Camperlux/vancontroller/docs/3d_top.png

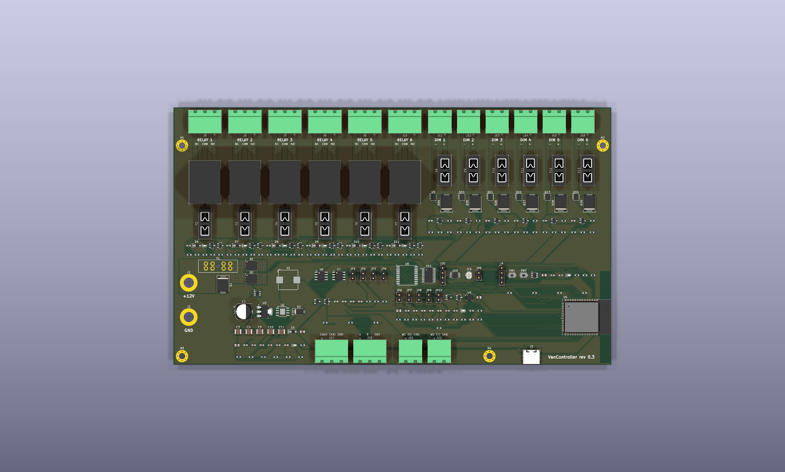
docs/3d_top.png
