Camperlux/vancontroller/docs/board_rev0.3_routed.png

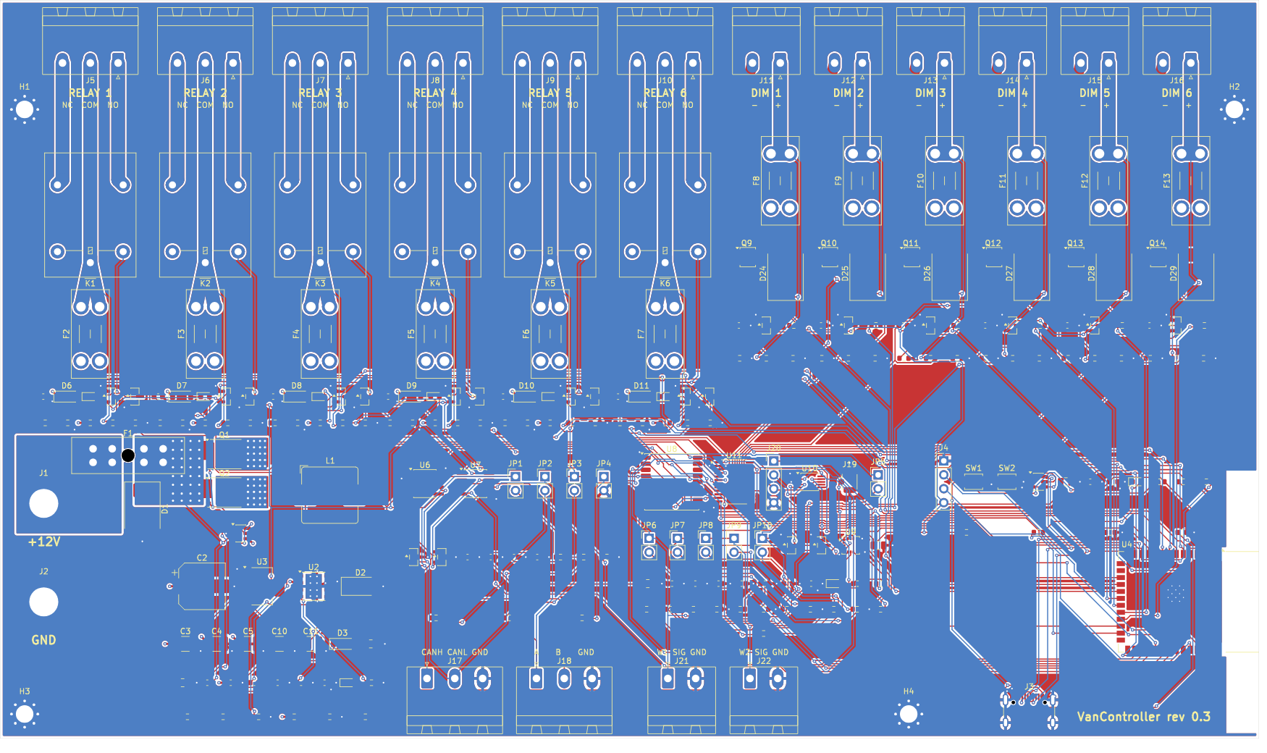
docs/board_rev0.3_routed.png
