Camperlux/vancontroller/docs/placement_rev0.3.png

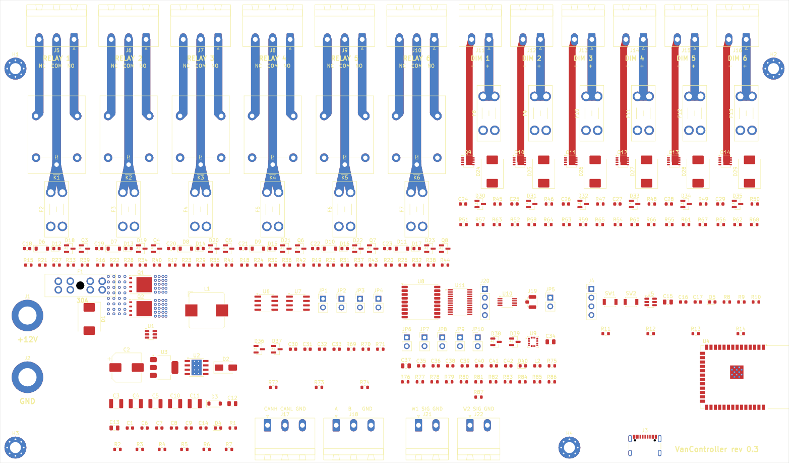
docs/placement_rev0.3.png
