Camperlux/vancontroller/enclosure/enclosure_base_preview.png

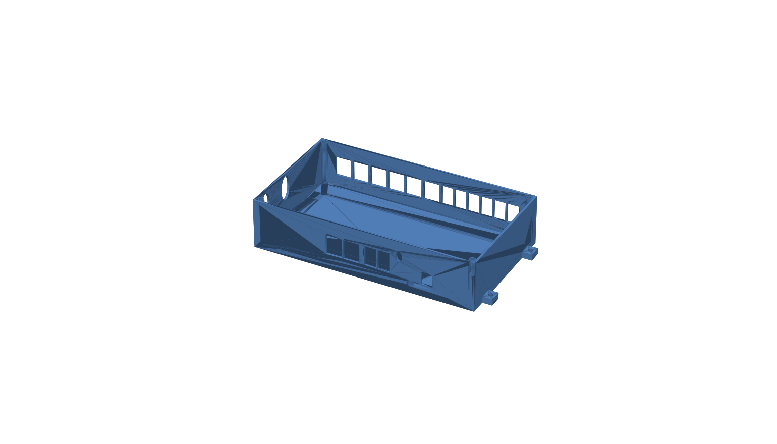
enclosure/enclosure_base_preview.png
