Camperlux/vancontroller/enclosure/enclosure_exploded_preview.png

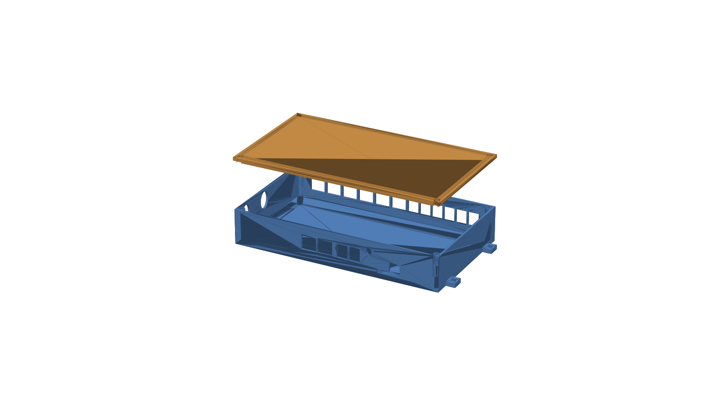
enclosure/enclosure_exploded_preview.png
