Camperlux/vancontroller/fab/bom.csv

Designators | Value | Footprint | MPN | Qty
C1,C7,C14,C16,C30,C31,C33,C35,C38-C42 | 100nF | Capacitor_SMD:C_0603_1608Metric |  | 13
C2 | 100uF 35V | Capacitor_SMD:CP_Elec_8x10 |  | 1
C3 | 4.7uF 50V | Capacitor_SMD:C_1210_3225Metric |  | 1
C4,C5 | 4.7uF 100V | Capacitor_SMD:C_1210_3225Metric |  | 2
C6 | 100nF 100V | Capacitor_SMD:C_0603_1608Metric |  | 1
C8,C32 | 4.7nF | Capacitor_SMD:C_0603_1608Metric |  | 2
C9 | 47pF | Capacitor_SMD:C_0603_1608Metric |  | 1
C10,C11 | 47uF 10V | Capacitor_SMD:C_1210_3225Metric |  | 2
C12,C13,C15 | 22uF | Capacitor_SMD:C_0805_2012Metric |  | 3
C17 | 1uF | Capacitor_SMD:C_0603_1608Metric |  | 1
C18-C29,C36 | 10nF | Capacitor_SMD:C_0603_1608Metric |  | 13
C34,C37 | 10uF | Capacitor_SMD:C_0805_2012Metric |  | 2
D1 | SMDJ26CA | Diode_SMD:D_SMC |  | 1
D2 | B360A | Diode_SMD:D_SMA |  | 1
D3 | B5819W | Diode_SMD:D_SOD-123 |  | 1
D4 | Green | LED_SMD:LED_0603_1608Metric |  | 1
D5 | Blue | LED_SMD:LED_0603_1608Metric |  | 1
D6-D11 | 1N4148W | Diode_SMD:D_SOD-123 |  | 6
D12-D17 | Red | LED_SMD:LED_0603_1608Metric |  | 6
D18-D23,D30-D35,D38,D39 | BAT54S | Package_TO_SOT_SMD:SOT-23 |  | 14
D24-D29 | SS54 | Diode_SMD:D_SMC |  | 6
D36 | NUP2105L | Package_TO_SOT_SMD:SOT-23 |  | 1
D37 | SM712 | Package_TO_SOT_SMD:SOT-23 |  | 1
D40 | Yellow | LED_SMD:LED_0603_1608Metric |  | 1
F1 | 30A ATO | Fuse:FuseHolder_Blade_ATO_Littelfuse_FLR_178.6165 | Littelfuse FLR 178.6165 + 30 A ATO fuse | 1
F2-F7 | 10A mini | Fuse:Fuseholder_Blade_Mini_Keystone_3568 | Keystone 3568 + mini blade fuse (size to load) | 6
F8-F13 | 5A mini | Fuse:Fuseholder_Blade_Mini_Keystone_3568 | Keystone 3568 + mini blade fuse (size to load) | 6
J1 | +12V IN (M5 stud) | MountingHole:MountingHole_5.3mm_M5_DIN965_Pad |  | 1
J2 | GND IN (M5 stud) | MountingHole:MountingHole_5.3mm_M5_DIN965_Pad |  | 1
J3 | USB-C | Connector_USB:USB_C_Receptacle_GCT_USB4105-xx-A_16P_TopMnt_Horizontal |  | 1
J4 | UART0 debug | Connector_PinHeader_2.54mm:PinHeader_1x04_P2.54mm_Vertical |  | 1
J5-J10 | NO / COM / NC | Connector_Phoenix_MSTB:PhoenixContact_MSTBA_2,5_3-G-5,08_1x03_P5.08mm_Horizontal | Phoenix MSTBA 2,5/3-G-5,08 + MSTB 2,5/3-ST-5,08 | 6
J11-J16 | LOAD+ / LOAD- | Connector_Phoenix_MSTB:PhoenixContact_MSTBA_2,5_2-G-5,08_1x02_P5.08mm_Horizontal | Phoenix MSTBA 2,5/2-G-5,08 + MSTB 2,5/2-ST-5,08 | 6
J17 | CANH / CANL / GND | Connector_Phoenix_MSTB:PhoenixContact_MSTBA_2,5_3-G-5,08_1x03_P5.08mm_Horizontal | Phoenix MSTBA 2,5/3-G-5,08 + MSTB 2,5/3-ST-5,08 | 1
J18 | A / B / GND | Connector_Phoenix_MSTB:PhoenixContact_MSTBA_2,5_3-G-5,08_1x03_P5.08mm_Horizontal | Phoenix MSTBA 2,5/3-G-5,08 + MSTB 2,5/3-ST-5,08 | 1
J19 | GPS ANT (u.FL) | Connector_Coaxial:U.FL_Hirose_U.FL-R-SMT-1_Vertical |  | 1
J20 | AUX ADC | Connector_PinHeader_2.54mm:PinHeader_1x04_P2.54mm_Vertical |  | 1
J21 | WATER 1 | Connector_Phoenix_MSTB:PhoenixContact_MSTBA_2,5_2-G-5,08_1x02_P5.08mm_Horizontal | Phoenix MSTBA 2,5/2-G-5,08 + MSTB 2,5/2-ST-5,08 | 1
J22 | WATER 2 | Connector_Phoenix_MSTB:PhoenixContact_MSTBA_2,5_2-G-5,08_1x02_P5.08mm_Horizontal | Phoenix MSTBA 2,5/2-G-5,08 + MSTB 2,5/2-ST-5,08 | 1
JP1 | CAN TERM | Connector_PinHeader_2.54mm:PinHeader_1x02_P2.54mm_Vertical |  | 1
JP2 | 485 TERM | Connector_PinHeader_2.54mm:PinHeader_1x02_P2.54mm_Vertical |  | 1
JP3 | 485 BIAS+ | Connector_PinHeader_2.54mm:PinHeader_1x02_P2.54mm_Vertical |  | 1
JP4 | 485 BIAS- | Connector_PinHeader_2.54mm:PinHeader_1x02_P2.54mm_Vertical |  | 1
JP5 | W1 RESISTIVE | Connector_PinHeader_2.54mm:PinHeader_1x02_P2.54mm_Vertical |  | 1
JP6 | W1 4-20mA | Connector_PinHeader_2.54mm:PinHeader_1x02_P2.54mm_Vertical |  | 1
JP7 | W1 0-5V | Connector_PinHeader_2.54mm:PinHeader_1x02_P2.54mm_Vertical |  | 1
JP8 | W2 RESISTIVE | Connector_PinHeader_2.54mm:PinHeader_1x02_P2.54mm_Vertical |  | 1
JP9 | W2 4-20mA | Connector_PinHeader_2.54mm:PinHeader_1x02_P2.54mm_Vertical |  | 1
JP10 | W2 0-5V | Connector_PinHeader_2.54mm:PinHeader_1x02_P2.54mm_Vertical |  | 1
K1-K6 | G5LE-1-E DC12 | Relay_THT:Relay_SPDT_Omron-G5LE-1 |  | 6
L1 | 10uH 6A | Inductor_SMD:L_Bourns_SRP1038C_10.0x10.0mm | Bourns SRP1038C-100M | 1
L2 | 27nH | Inductor_SMD:L_0603_1608Metric |  | 1
Q1,Q2 | CSD18540Q5B | Package_TO_SOT_SMD:TDSON-8-1 |  | 2
Q3-Q8 | AO3400A | Package_TO_SOT_SMD:SOT-23 |  | 6
Q9-Q14 | BUK9M12-60EX | Package_TO_SOT_SMD:LFPAK33 |  | 6
R1 | 162k | Resistor_SMD:R_0603_1608Metric |  | 1
R2 | 16.9k | Resistor_SMD:R_0603_1608Metric |  | 1
R3 | 53.6k | Resistor_SMD:R_0603_1608Metric |  | 1
R4 | 10.2k | Resistor_SMD:R_0603_1608Metric |  | 1
R5 | 120k | Resistor_SMD:R_0603_1608Metric |  | 1
R6,R8,R9,R39-R44,R63-R68,R71,R76,R77,R80,R84,R86 | 10k | Resistor_SMD:R_0603_1608Metric |  | 21
R7,R12,R87 | 1k | Resistor_SMD:R_0603_1608Metric |  | 3
R10,R11 | 4.7k | Resistor_SMD:R_0603_1608Metric |  | 2
R13,R14 | 5.1k | Resistor_SMD:R_0603_1608Metric |  | 2
R15-R20 | 100 | Resistor_SMD:R_0603_1608Metric |  | 6
R21-R26,R51-R56 | 100k | Resistor_SMD:R_0603_1608Metric |  | 12
R27-R32 | 2.2k | Resistor_SMD:R_0603_1608Metric |  | 6
R33-R38,R57-R62 | 33k | Resistor_SMD:R_0603_1608Metric |  | 12
R45-R50 | 47 | Resistor_SMD:R_0603_1608Metric |  | 6
R69,R70 | 60.4 | Resistor_SMD:R_0603_1608Metric |  | 2
R72 | 120 | Resistor_SMD:R_0603_1608Metric |  | 1
R73,R74 | 680 | Resistor_SMD:R_0603_1608Metric |  | 2
R75 | 10 | Resistor_SMD:R_0603_1608Metric |  | 1
R78,R82 | 470 | Resistor_SMD:R_0603_1608Metric |  | 2
R79,R83 | 150 | Resistor_SMD:R_0603_1608Metric |  | 2
R81,R85 | 15k | Resistor_SMD:R_0603_1608Metric |  | 2
SW1 | RESET | Button_Switch_SMD:SW_SPST_B3U-1000P |  | 1
SW2 | BOOT | Button_Switch_SMD:SW_SPST_B3U-1000P |  | 1
U1 | LM74700QDBVRQ1 | Package_TO_SOT_SMD:SOT-23-6 |  | 1
U2 | TPS54360DDA | Package_SO:TI_SO-PowerPAD-8_ThermalVias |  | 1
U3 | AMS1117-3.3 | Package_TO_SOT_SMD:SOT-223-3_TabPin2 |  | 1
U4 | ESP32-S3-WROOM-1-N16 | RF_Module:ESP32-S3-WROOM-1 |  | 1
U5 | USBLC6-2SC6 | Package_TO_SOT_SMD:SOT-23-6 |  | 1
U6 | TJA1051T/3 | Package_SO:SOIC-8_3.9x4.9mm_P1.27mm |  | 1
U7 | THVD1450D | Package_SO:SOIC-8_3.9x4.9mm_P1.27mm |  | 1
U8 | MAX-M10S | RF_GPS:ublox_MAX |  | 1
U9 | LIS3DH | Package_LGA:LGA-16_3x3mm_P0.5mm_LayoutBorder3x5y |  | 1
U10 | ADS1115IDGS | Package_SO:TSSOP-10_3x3mm_P0.5mm |  | 1
U11 | TCA9535PWR | Package_SO:TSSOP-24_4.4x7.8mm_P0.65mm |  | 1
