Camperlux/vancontroller/enclosure/VanController_enclosure_assembly.step

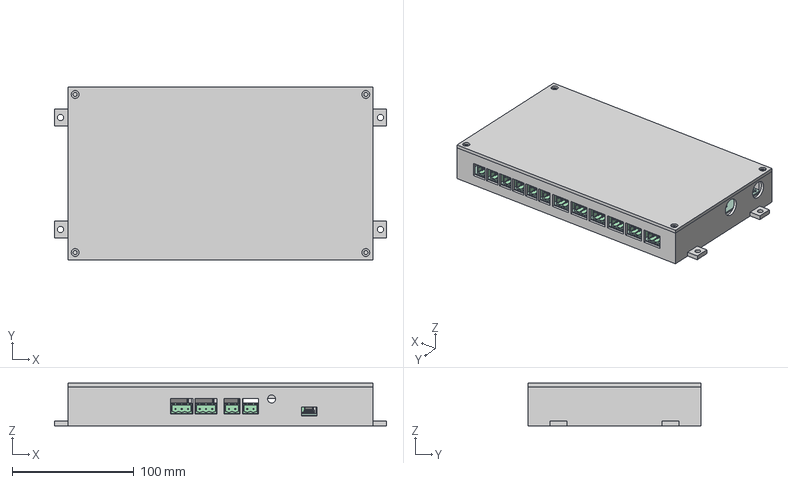
[picture p7: CAD file, 2026-10-07]
enclosure/VanController_enclosure_assembly.step
273.0 x 142.0 x 35.1 mm
R_0603_1608Metric_1 x 87
A_Keystone_3568 x 12
D_SMC_1 x 7
C_0603_1608Metric_1 x 31
MSTBA_01x03_G_5_08mm x 8
Relay_SPDT_Omron-G5LE-1_1 x 6
MSTBA_01x02_G_5_08mm x 8
LED_0603_1608Metric_1 x 9
C_0805_2012Metric_1 x 5
U.FL_Hirose_U.FL-R-SMT-1_Vertical_1
SOT-23_1 x 22
SOT-1210_LFPAK33 x 6
D_SOD-123_1 x 7
TSSOP-24_4.4x7.8mm_P0.65mm_1
SW_SPST_B3U-1000P_1 x 2
C_1210_3225Metric_1 x 5
PinHeader_1x02_P254mm_Vertical x 10
ESP32-S3-WROOM-1_1
TDSON_8_1 x 2
TSSOP-10_3x3mm_P0.5mm_1
PinHeader_1x04_P254mm_Vertical x 2
SOT-23-6_1 x 2
D_SMA_1
CP_Elec_8x10_1
SOIC-8_3.9x4.9mm_P1.27mm_1 x 2
SOT-223_1
L_0603_1608Metric_1
USB_C_Receptacle_16P_TopMnt_Horizontal_GCT_USB4105-xx-A
LGA_16_3x3mm_P05mm_LayoutBorder3x5y
VanController_PCB
