Camperlux/vancontroller/fab/VanController.step

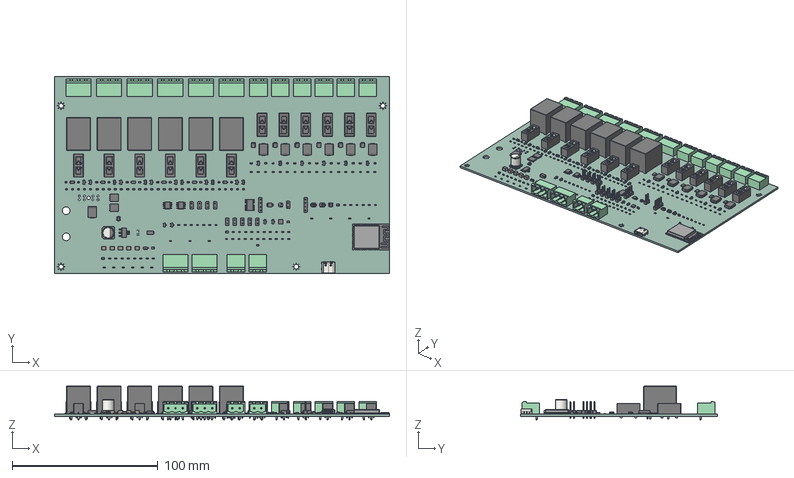
[picture p8: CAD file, 2026-10-14]
fab/VanController.step
230.0 x 135.0 x 23.1 mm
R_0603_1608Metric x 87
A_Keystone_3568 x 12
D_SMC x 7
C_0603_1608Metric x 31
MSTBA_01x03_G_5_08mm x 8
Relay_SPDT_Omron-G5LE-1 x 6
MSTBA_01x02_G_5_08mm x 8
LED_0603_1608Metric x 9
C_0805_2012Metric x 5
U.FL_Hirose_U.FL-R-SMT-1_Vertical
SOT-23 x 22
SOT-1210_LFPAK33 x 6
D_SOD-123 x 7
TSSOP-24_4.4x7.8mm_P0.65mm
SW_SPST_B3U-1000P x 2
C_1210_3225Metric x 5
PinHeader_1x02_P254mm_Vertical x 10
ESP32-S3-WROOM-1
TDSON_8_1 x 2
TSSOP-10_3x3mm_P0.5mm
PinHeader_1x04_P254mm_Vertical x 2
SOT-23-6 x 2
D_SMA
CP_Elec_8x10
SOIC-8_3.9x4.9mm_P1.27mm x 2
SOT-223
L_0603_1608Metric
USB_C_Receptacle_16P_TopMnt_Horizontal_GCT_USB4105-xx-A
LGA_16_3x3mm_P05mm_LayoutBorder3x5y
VanController_PCB
