Camperlux/vancontroller/manufacturing/VanController_rev0.3_PCBWay/08_Enclosure_3D_print_optional/VanController_base.stl

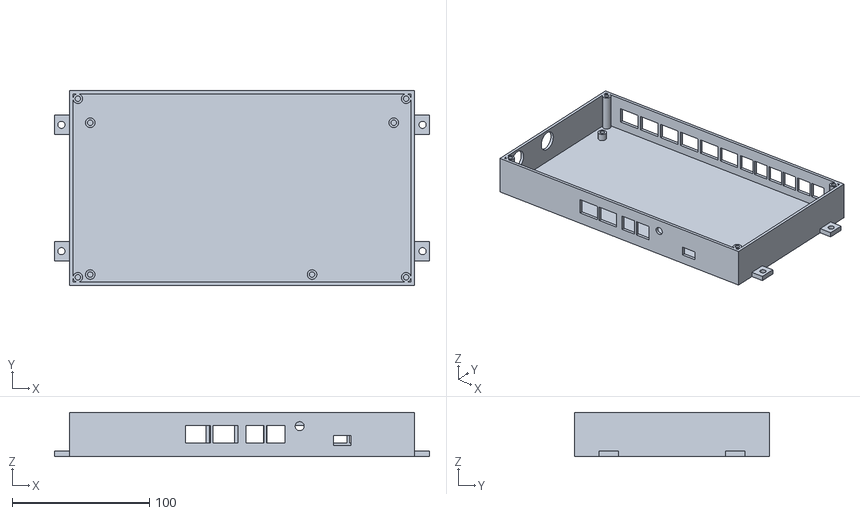
[picture p9: CAD file, 2026-10-07]
manufacturing/VanController_rev0.3_PCBWay/08_Enclosure_3D_print_optional/VanController_base.stl
273.0 x 142.0 x 32.1
