Camperlux/vancontroller/manufacturing/VanController_rev0.3_PCBWay/08_Enclosure_3D_print_optional/VanController_lid.stl

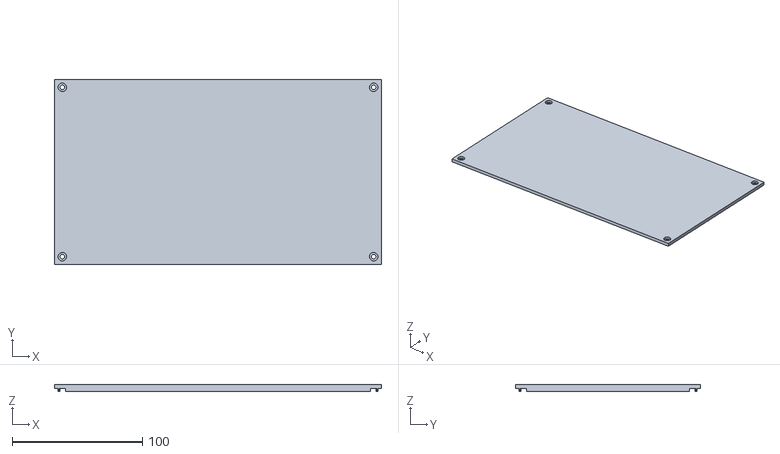
[picture p10: CAD file, 2026-10-07]
manufacturing/VanController_rev0.3_PCBWay/08_Enclosure_3D_print_optional/VanController_lid.stl
251.0 x 142.0 x 5.00
