Camperlux/vancontroller/(list of files, cad)

Other CAD files:
enclosure/VanController_pcb.step
