Camperlux/vancontroller/docs/VanController_schematic.pdf

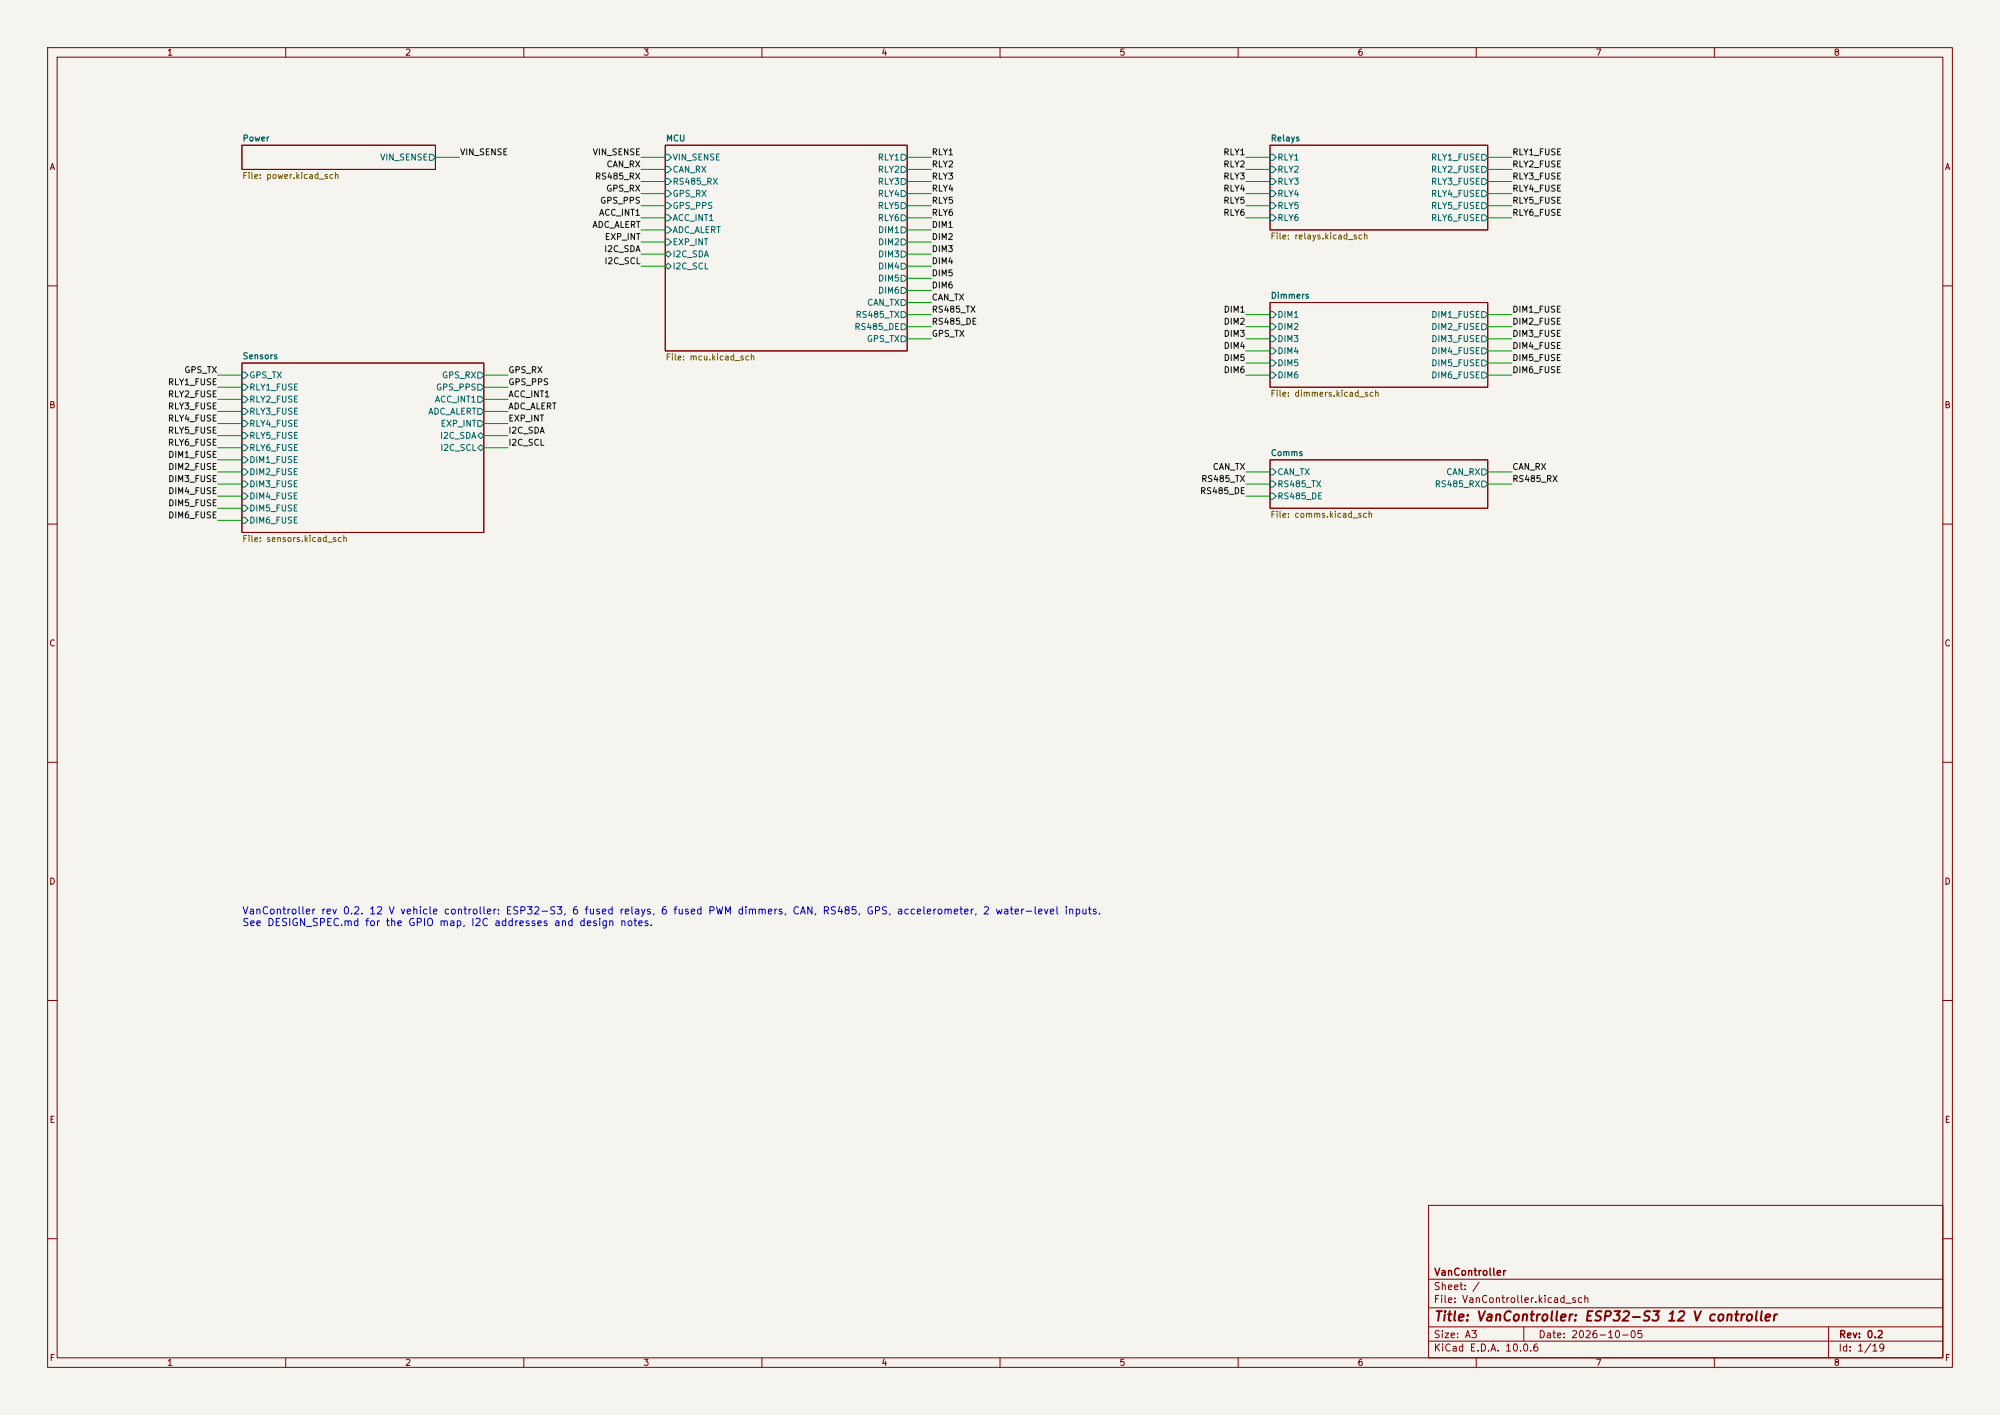
[picture p11: page 1]

See DESIGN_SPEC.md for the GPIO map, I2C addresses and design notes.

Size: A3 | Rev: 0.2 | F Date: 2026-10-05
KiCad E.D.A. 10.0.6 | Id: 1/19

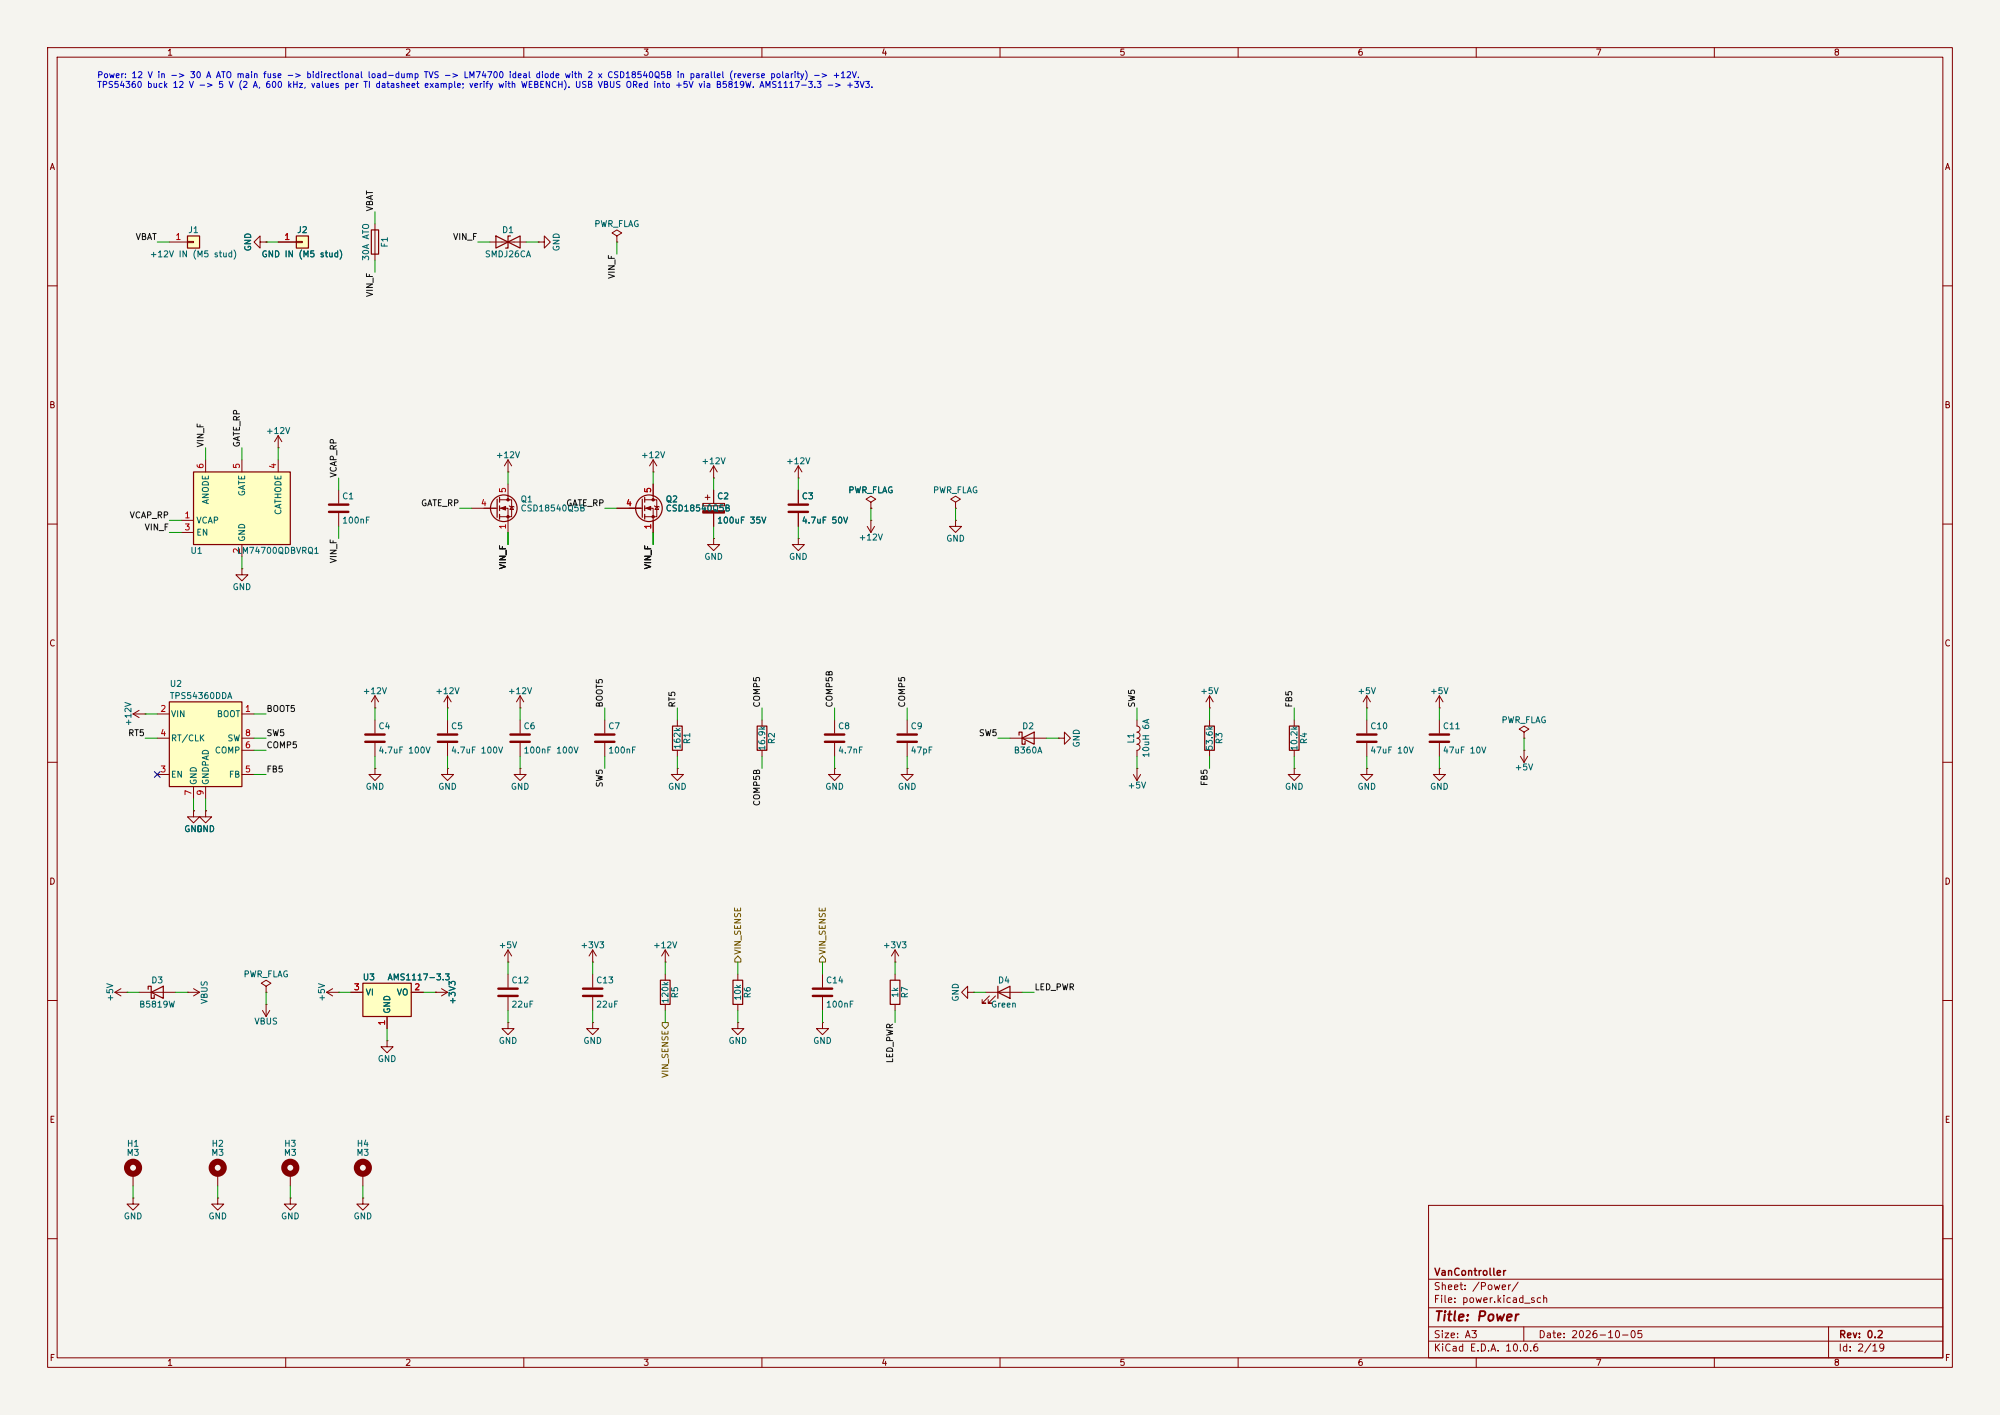
[picture p12: page 2]

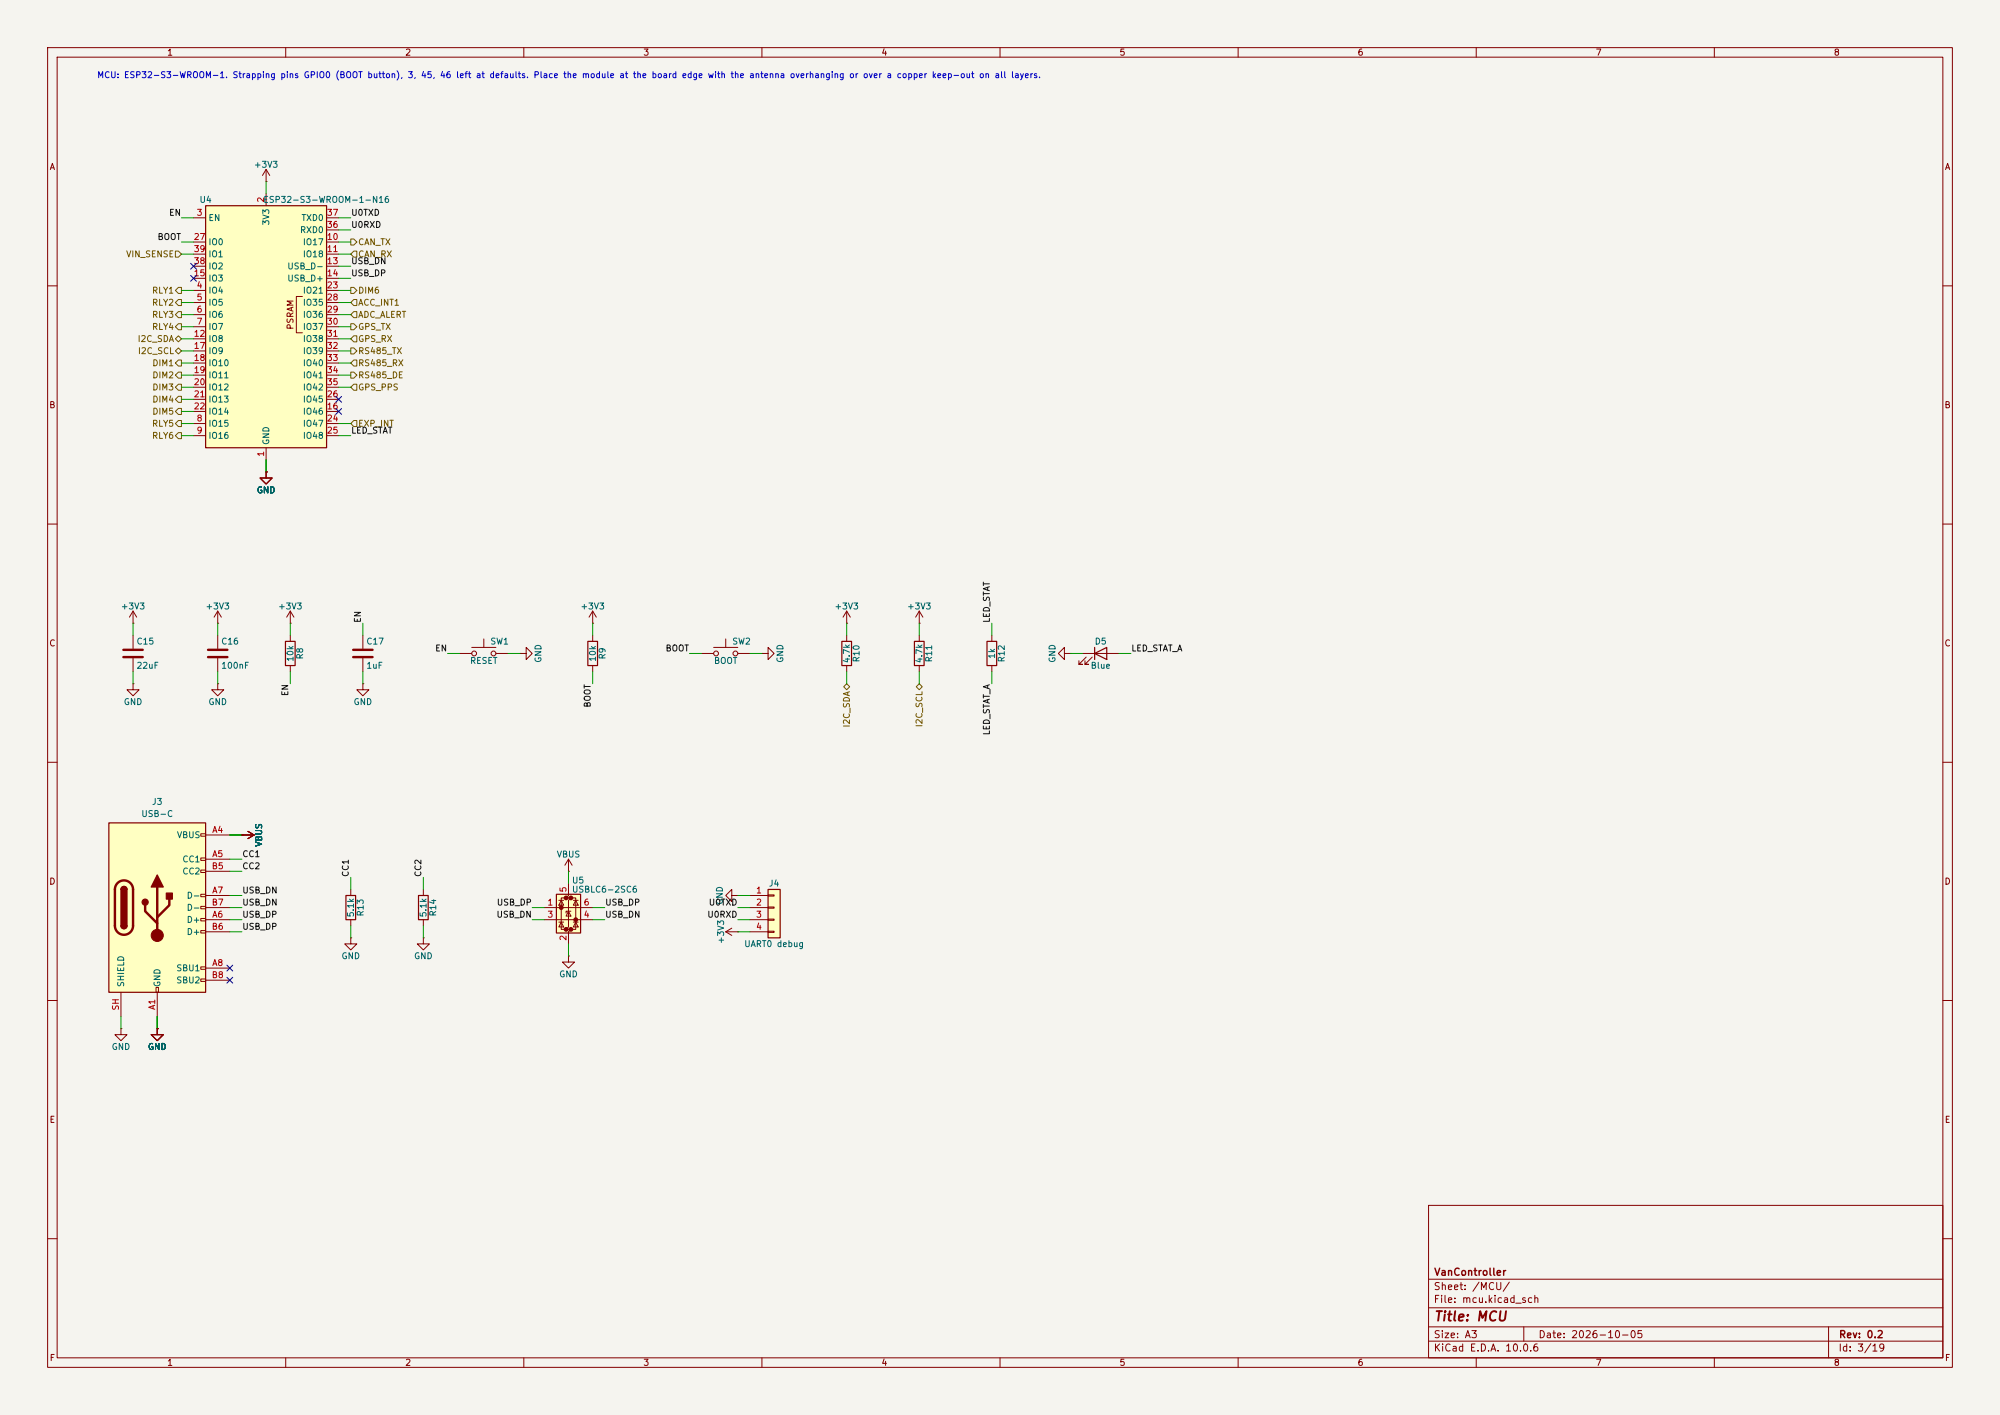
[picture p13: page 3]

MCU: ESP32-S3-WROOM-1. Strapping pins GPIO0 (BOOT button), 3, 45, 46 left at defaults. Place the module at the board edge with the antenna overhanging or over a copper keep-out on all layers. GNDVBUS GND

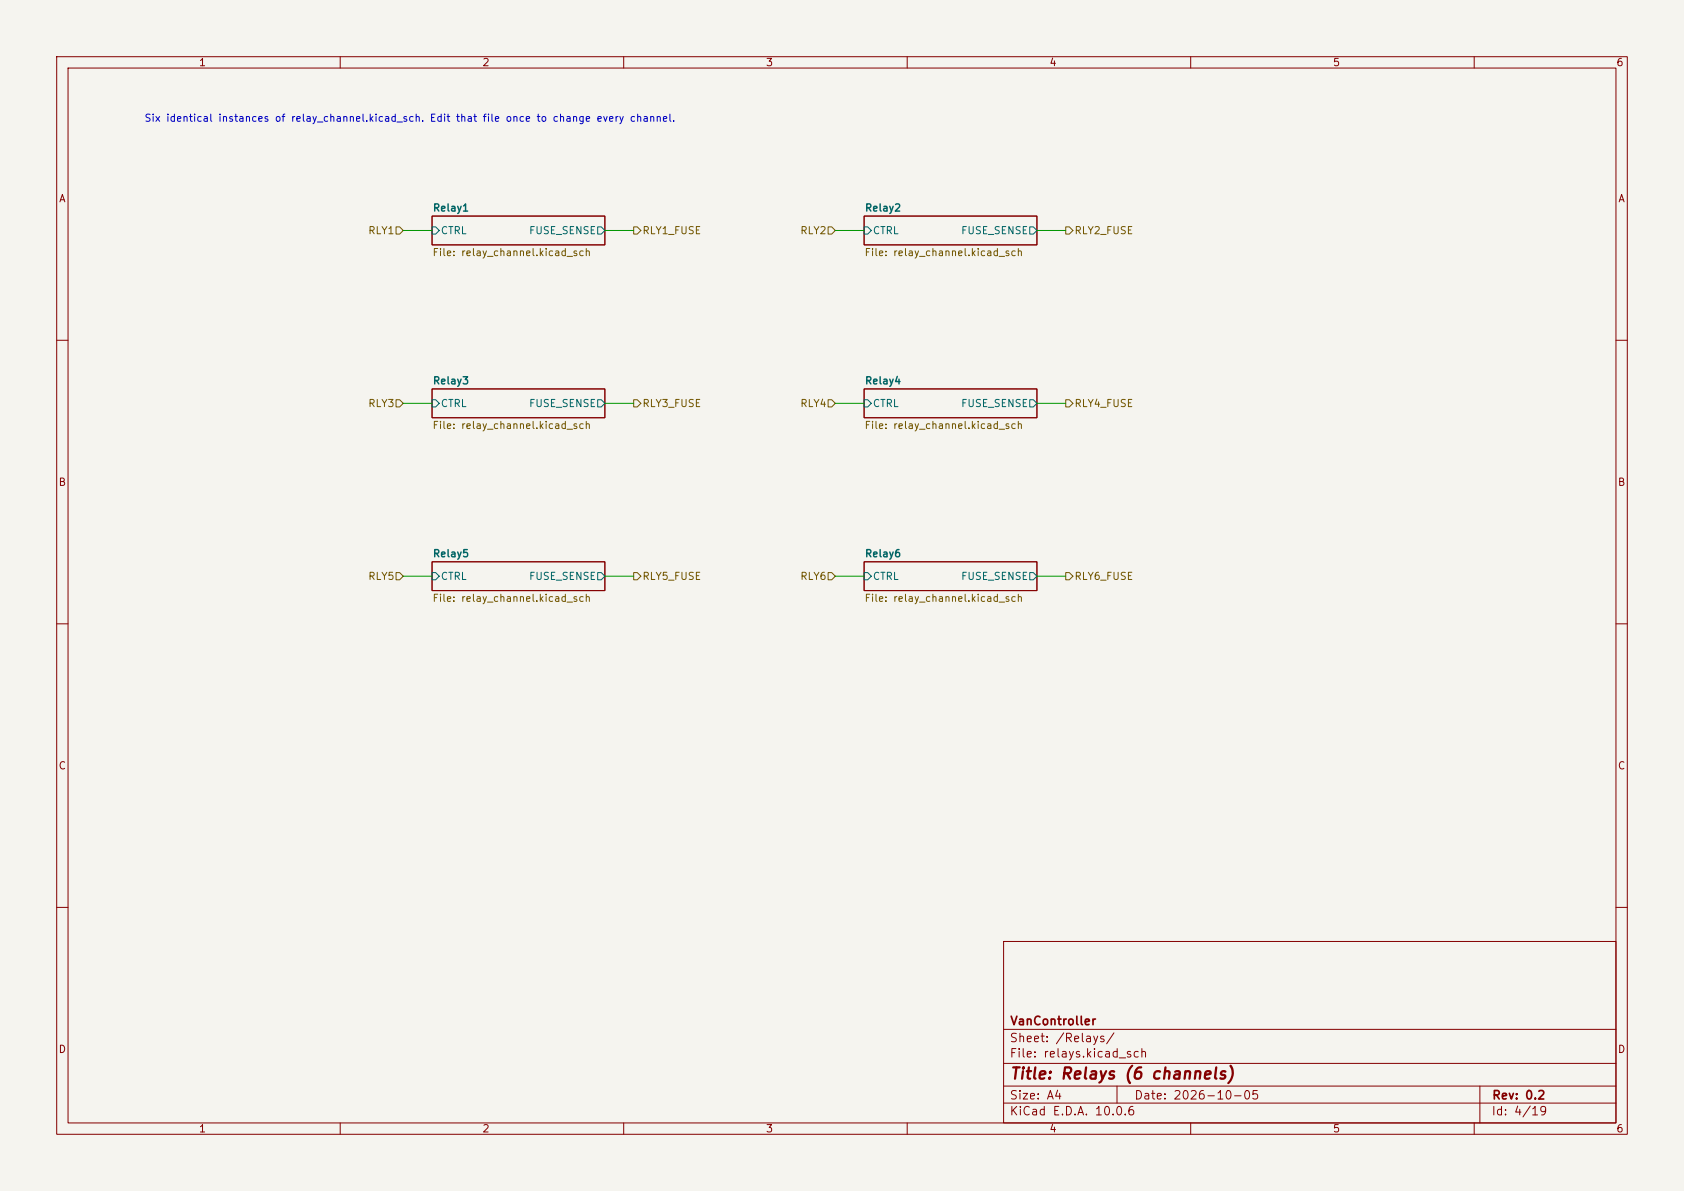
[picture p14: page 4]

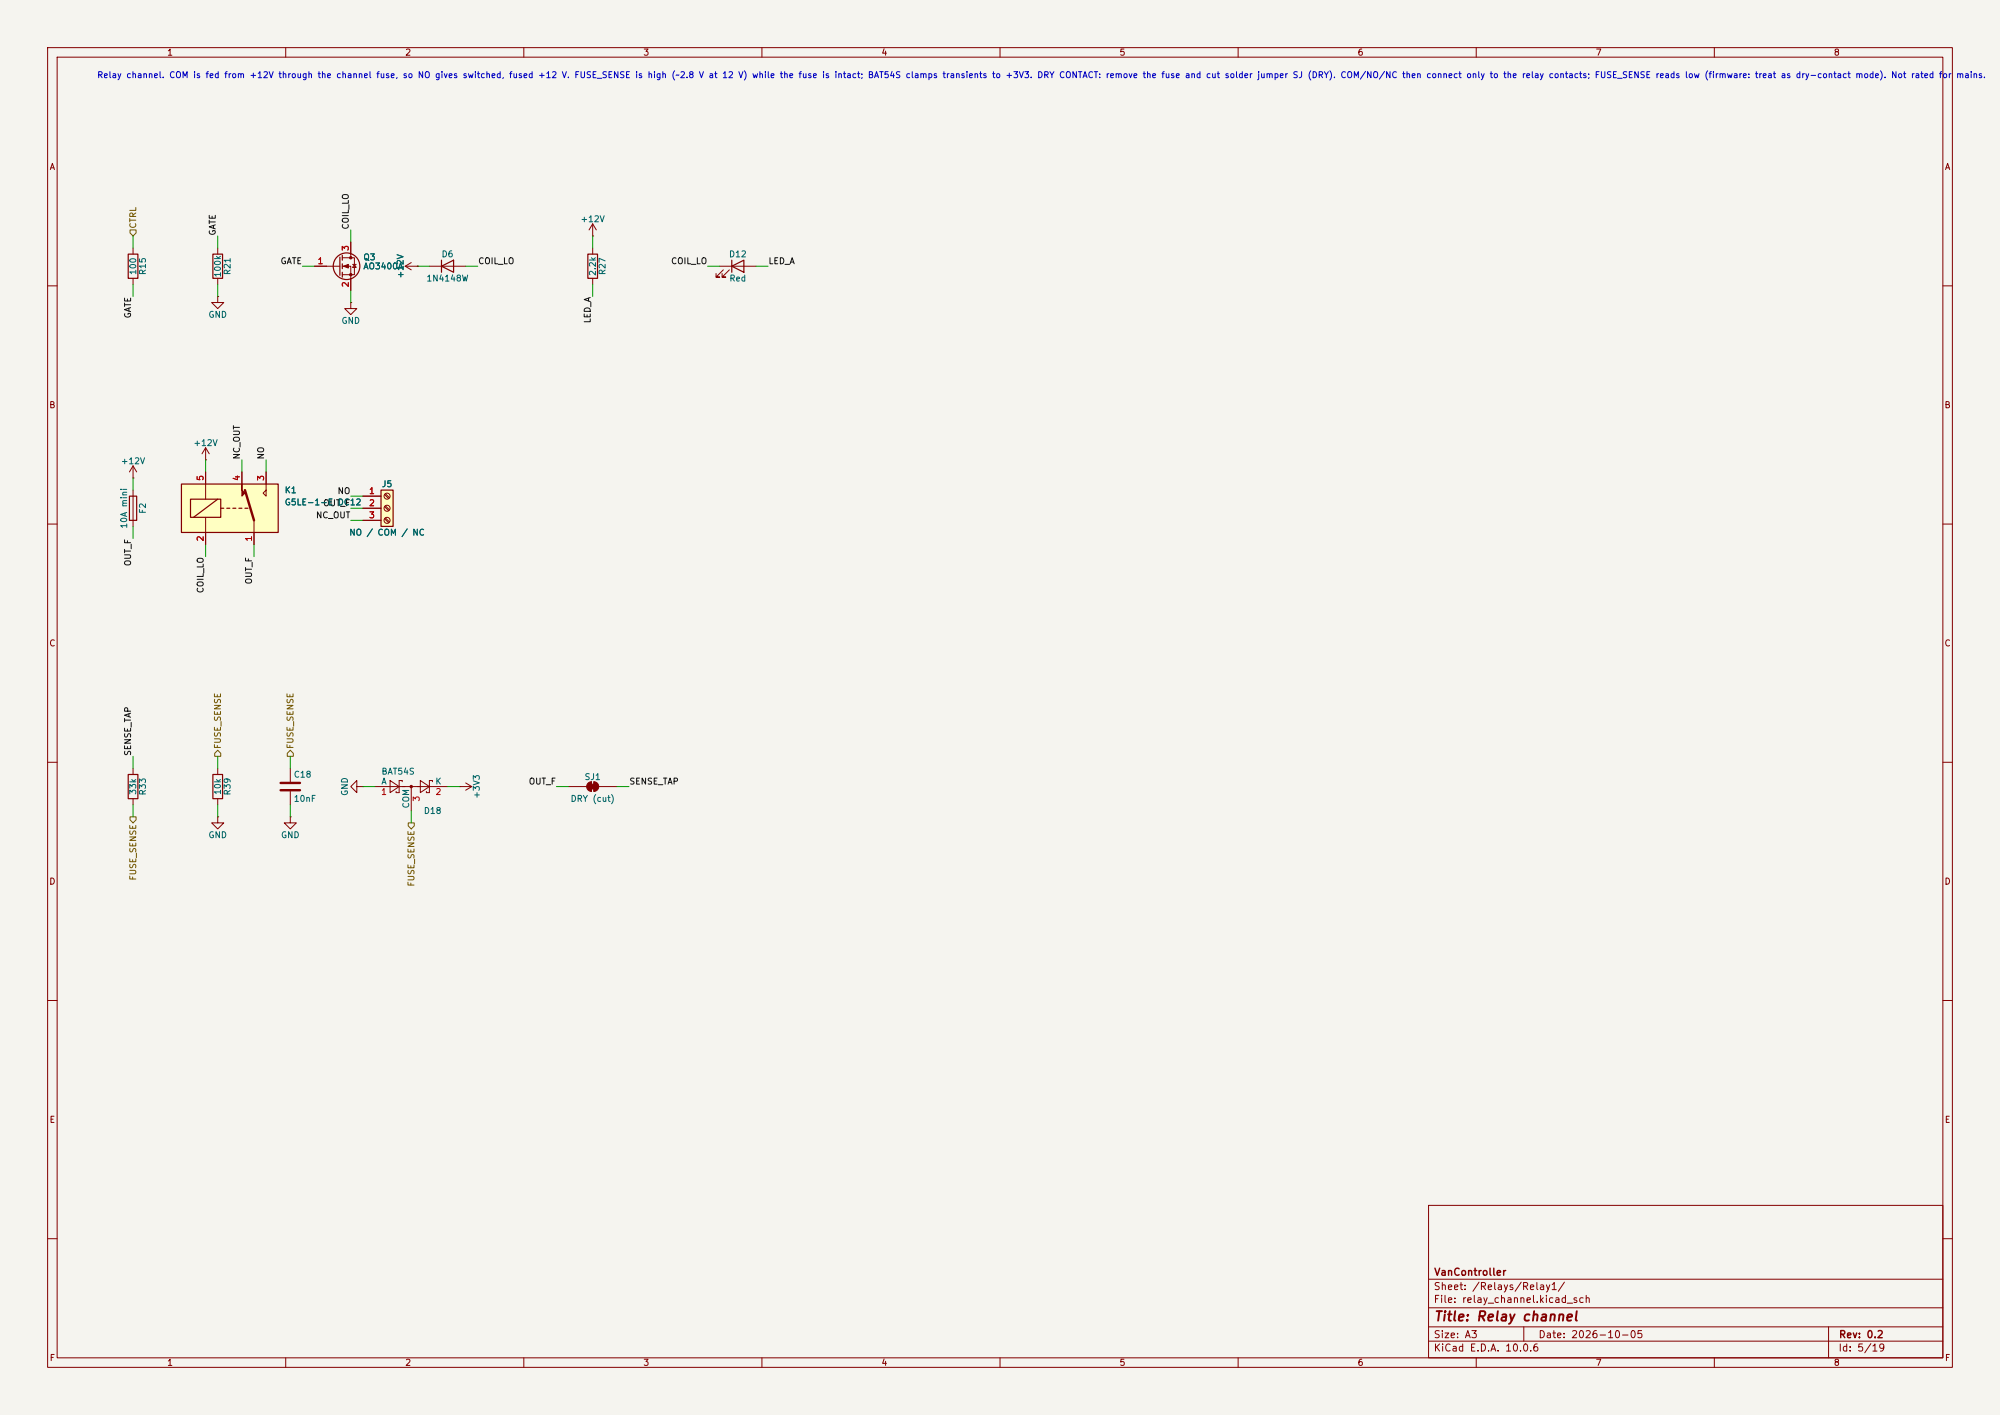
[picture p15: page 5]

GATE Relay channel. COM is fed from +12V through the channel fuse, so NO gives switched, fused +12 V. FUSE_SENSE is high (~2.8 V at 12 V) while the fuse is intact; BAT54S clamps transients to +3V3. DRY CONTACT: remove the fuse and cut solder jumper SJ (DRY). COM/NO/NC then connect only to the relay contacts; FUSE_SENSE reads low (firmware: treat as dry-contact mode). Not rated for mains. Q3

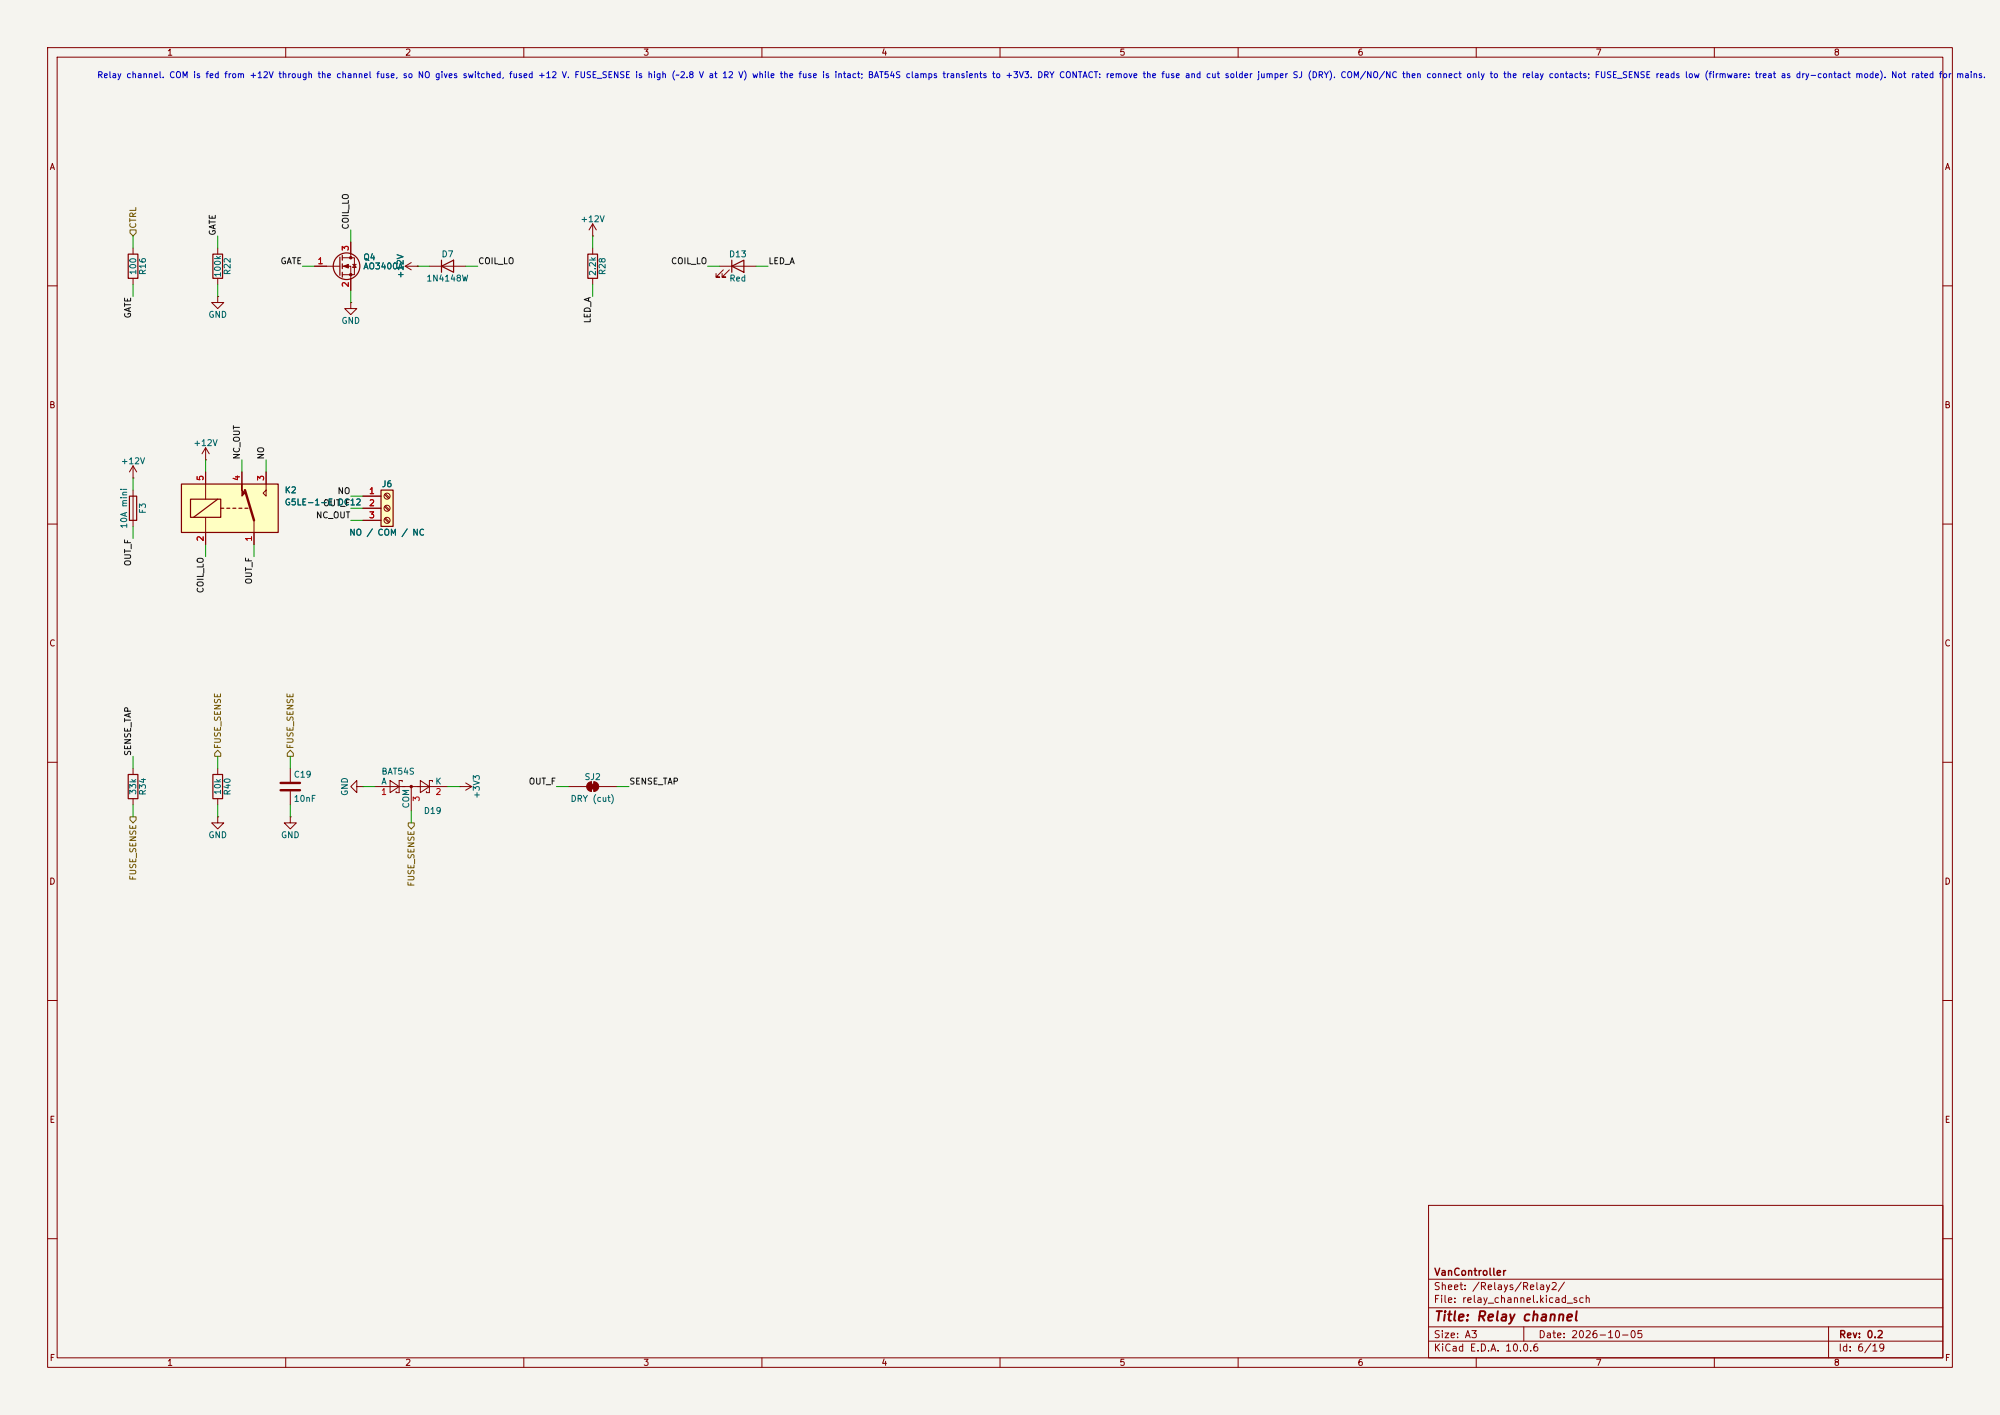
[picture p16: page 6]

GATE Relay channel. COM is fed from +12V through the channel fuse, so NO gives switched, fused +12 V. FUSE_SENSE is high (~2.8 V at 12 V) while the fuse is intact; BAT54S clamps transients to +3V3. DRY CONTACT: remove the fuse and cut solder jumper SJ (DRY). COM/NO/NC then connect only to the relay contacts; FUSE_SENSE reads low (firmware: treat as dry-contact mode). Not rated for mains. Q4

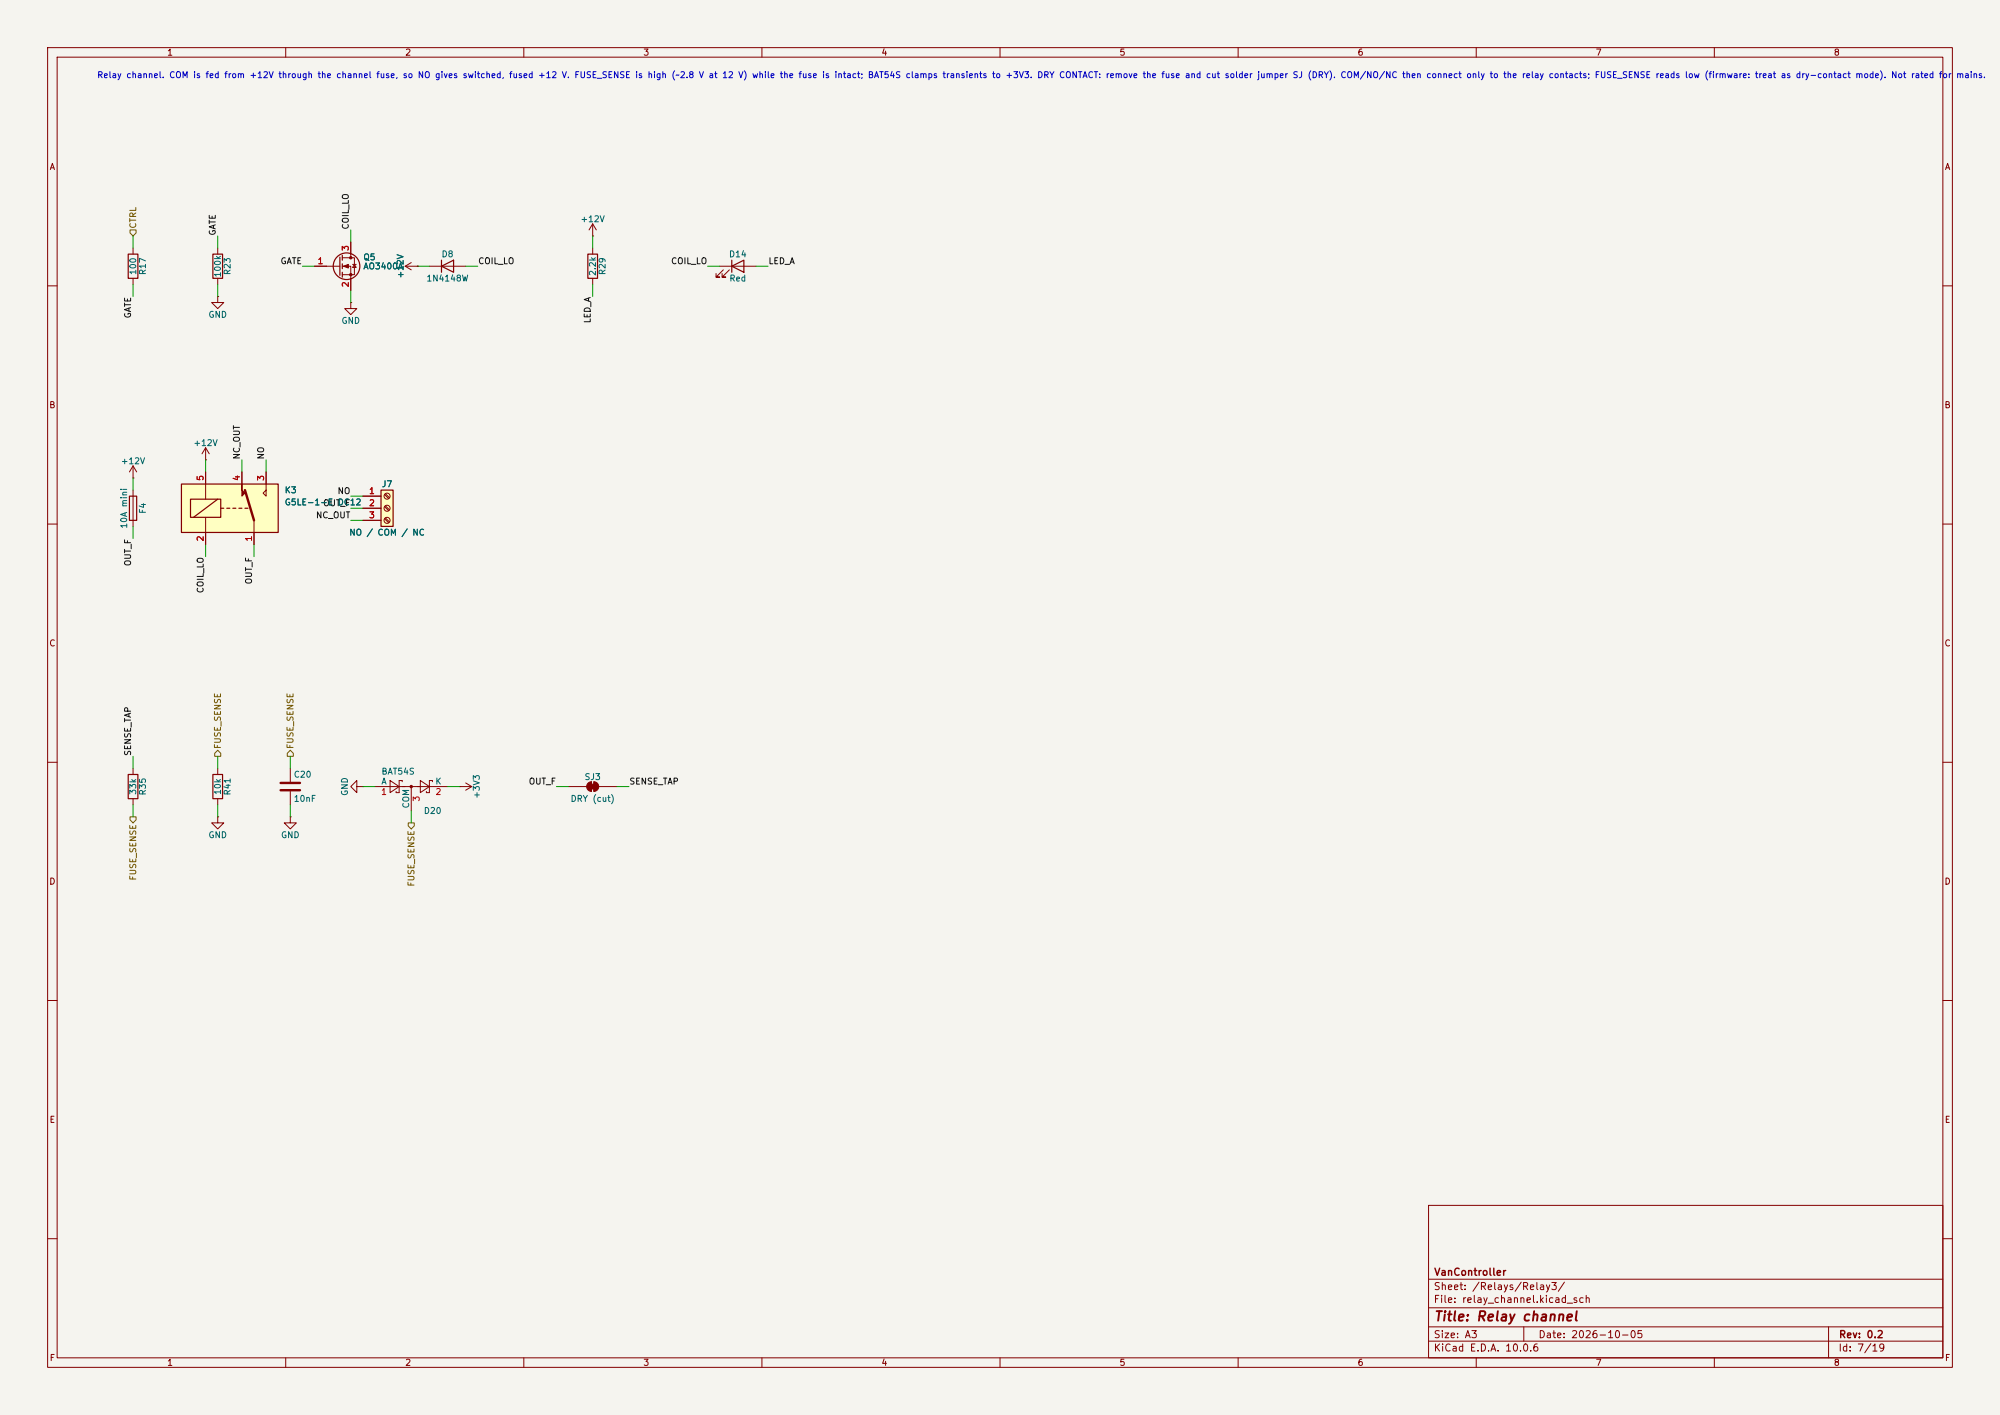
[picture p17: page 7]

GATE Relay channel. COM is fed from +12V through the channel fuse, so NO gives switched, fused +12 V. FUSE_SENSE is high (~2.8 V at 12 V) while the fuse is intact; BAT54S clamps transients to +3V3. DRY CONTACT: remove the fuse and cut solder jumper SJ (DRY). COM/NO/NC then connect only to the relay contacts; FUSE_SENSE reads low (firmware: treat as dry-contact mode). Not rated for mains. Q5

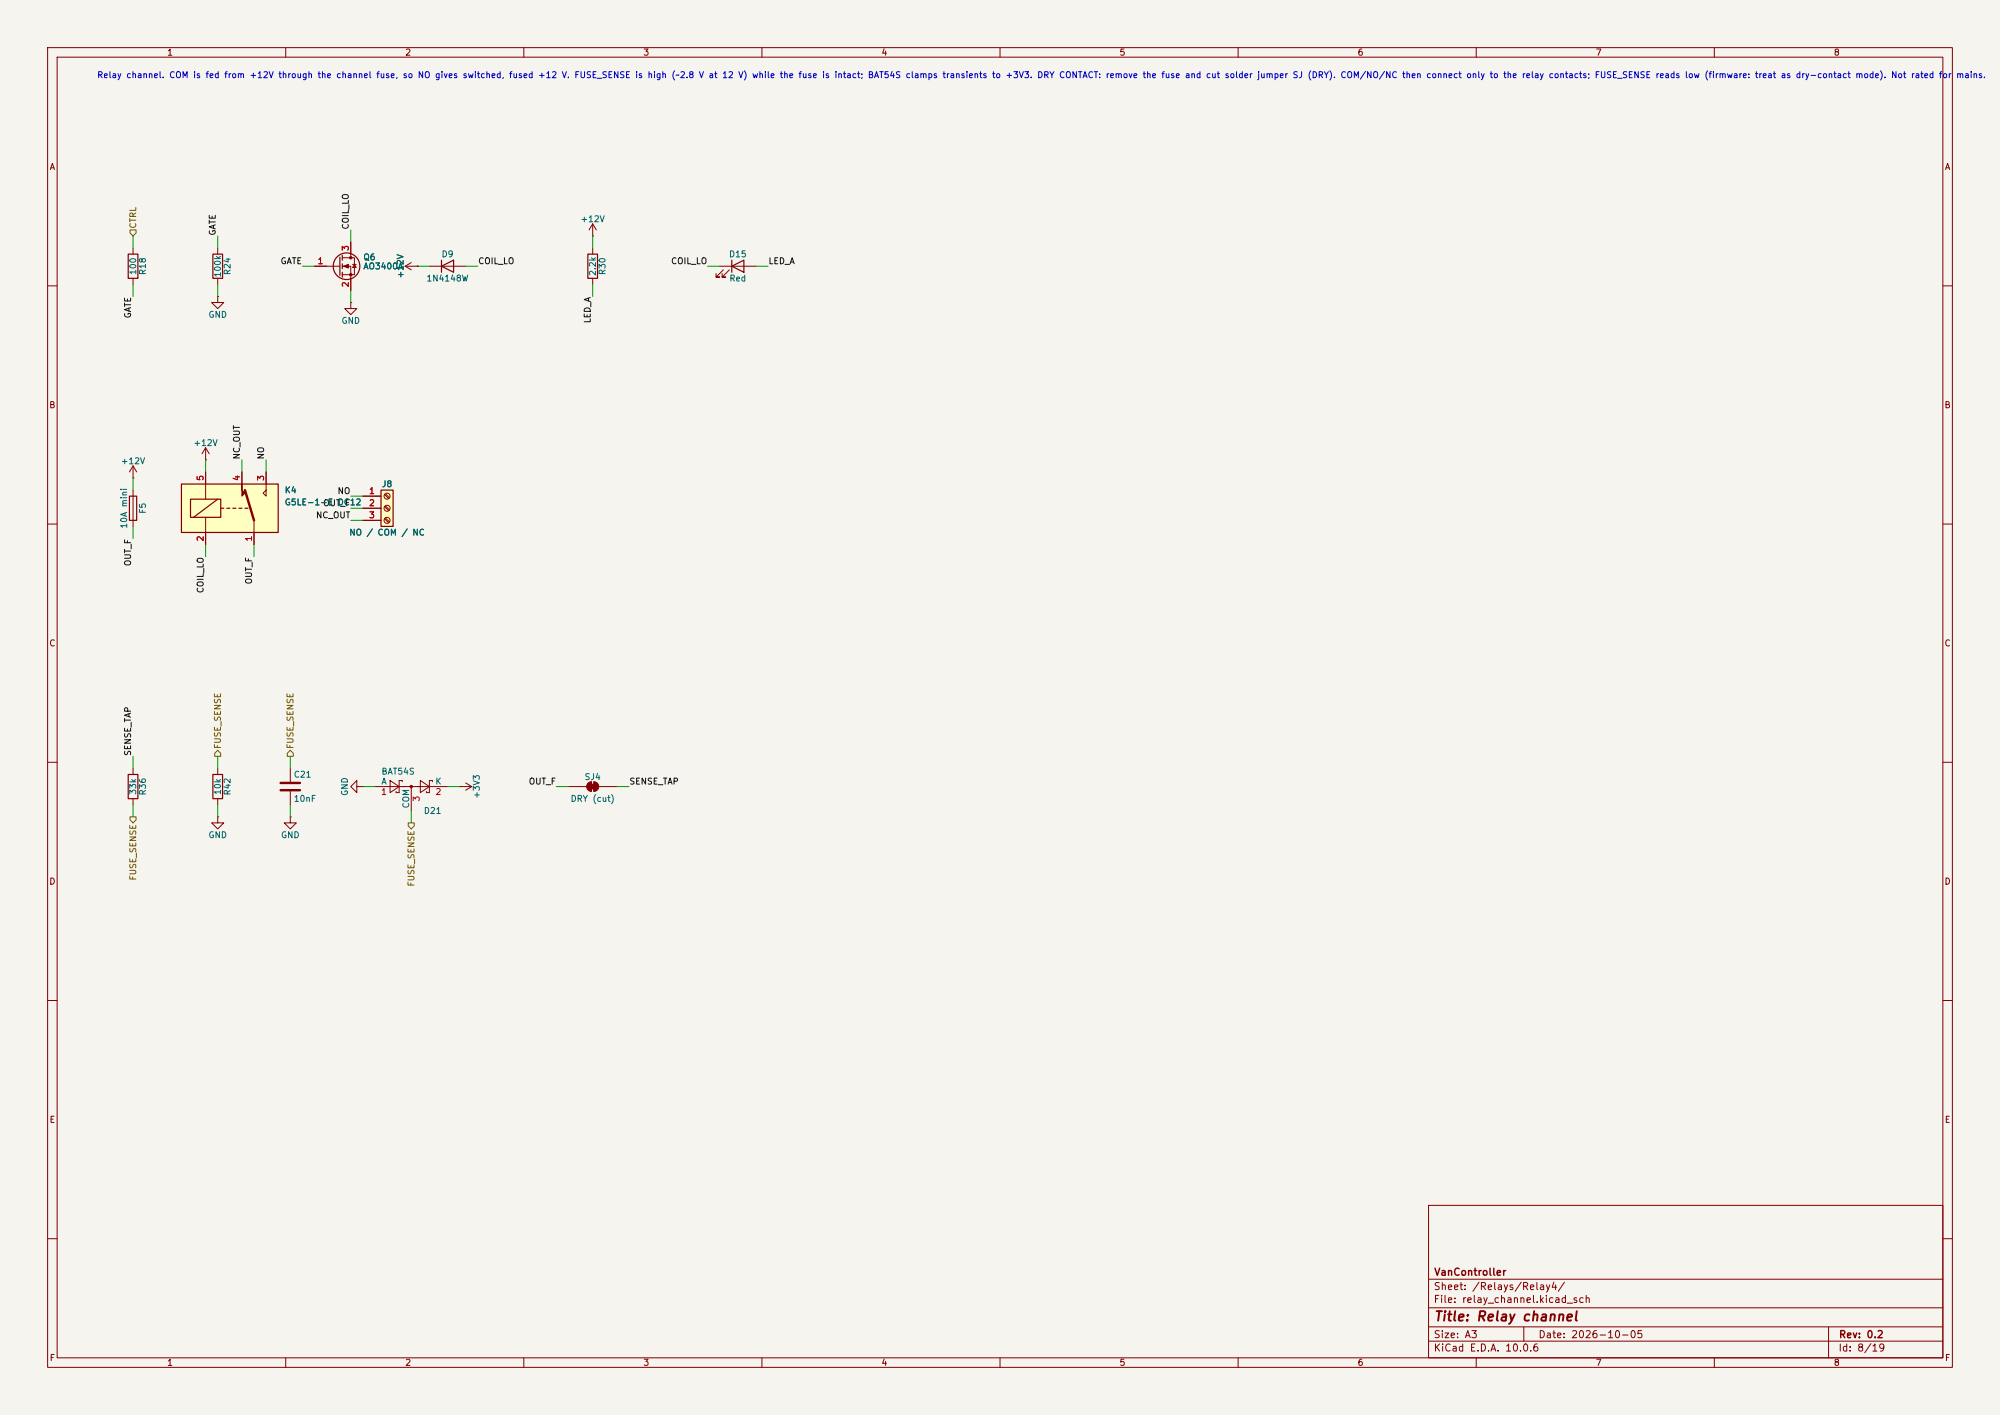
[picture p18: page 8]

GATE Relay channel. COM is fed from +12V through the channel fuse, so NO gives switched, fused +12 V. FUSE_SENSE is high (~2.8 V at 12 V) while the fuse is intact; BAT54S clamps transients to +3V3. DRY CONTACT: remove the fuse and cut solder jumper SJ (DRY). COM/NO/NC then connect only to the relay contacts; FUSE_SENSE reads low (firmware: treat as dry-contact mode). Not rated for mains. Q6
D15 Red +12V 100 R18

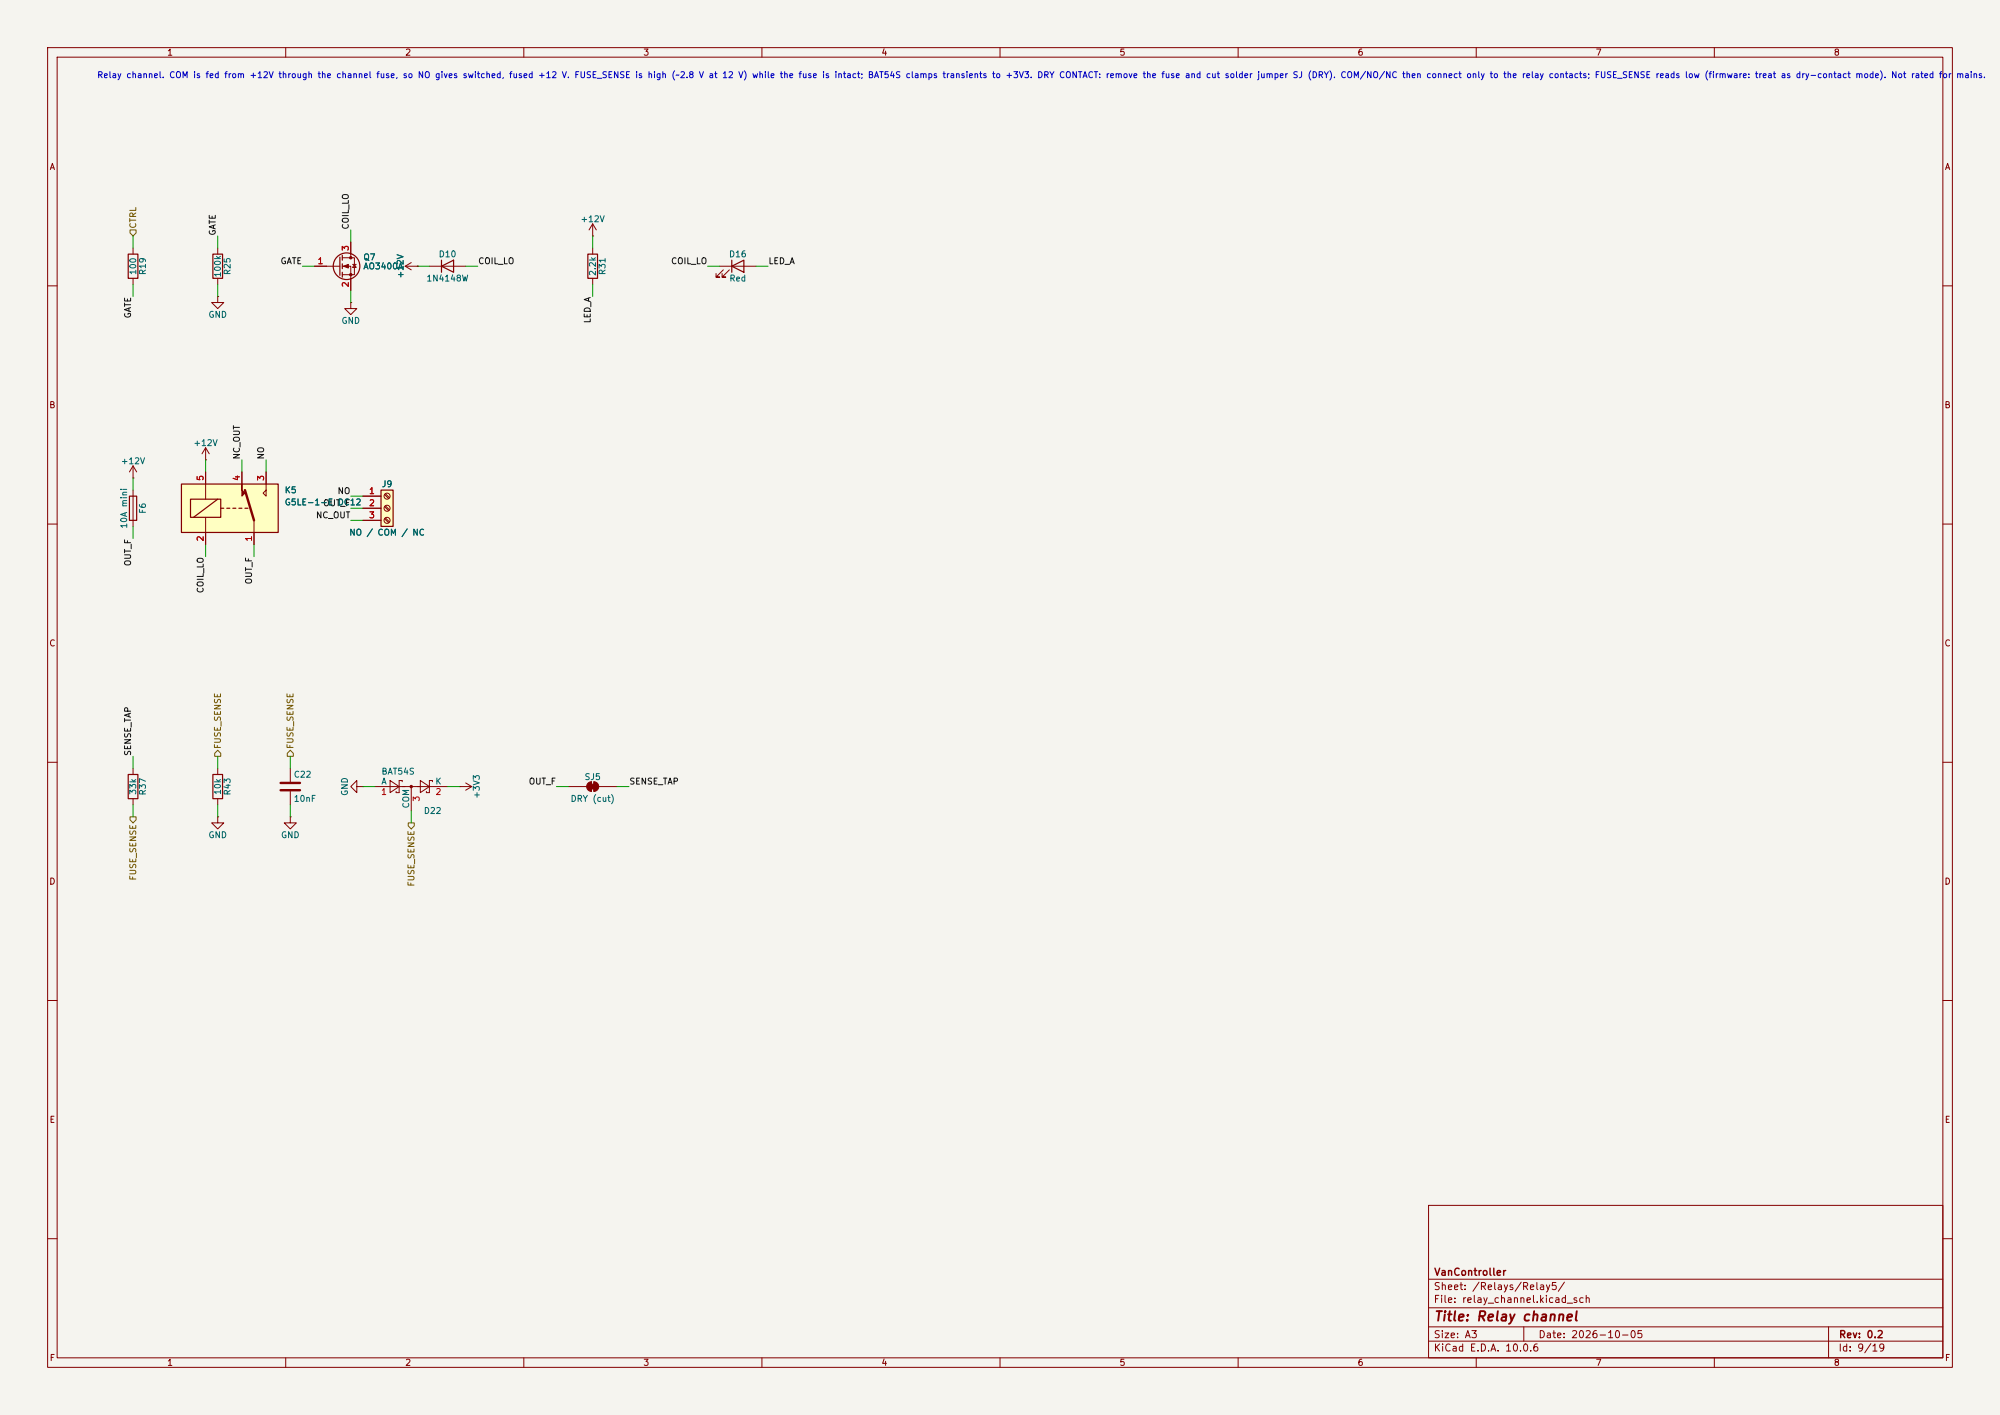
[picture p19: page 9]

GATE Relay channel. COM is fed from +12V through the channel fuse, so NO gives switched, fused +12 V. FUSE_SENSE is high (~2.8 V at 12 V) while the fuse is intact; BAT54S clamps transients to +3V3. DRY CONTACT: remove the fuse and cut solder jumper SJ (DRY). COM/NO/NC then connect only to the relay contacts; FUSE_SENSE reads low (firmware: treat as dry-contact mode). Not rated for mains. Q7

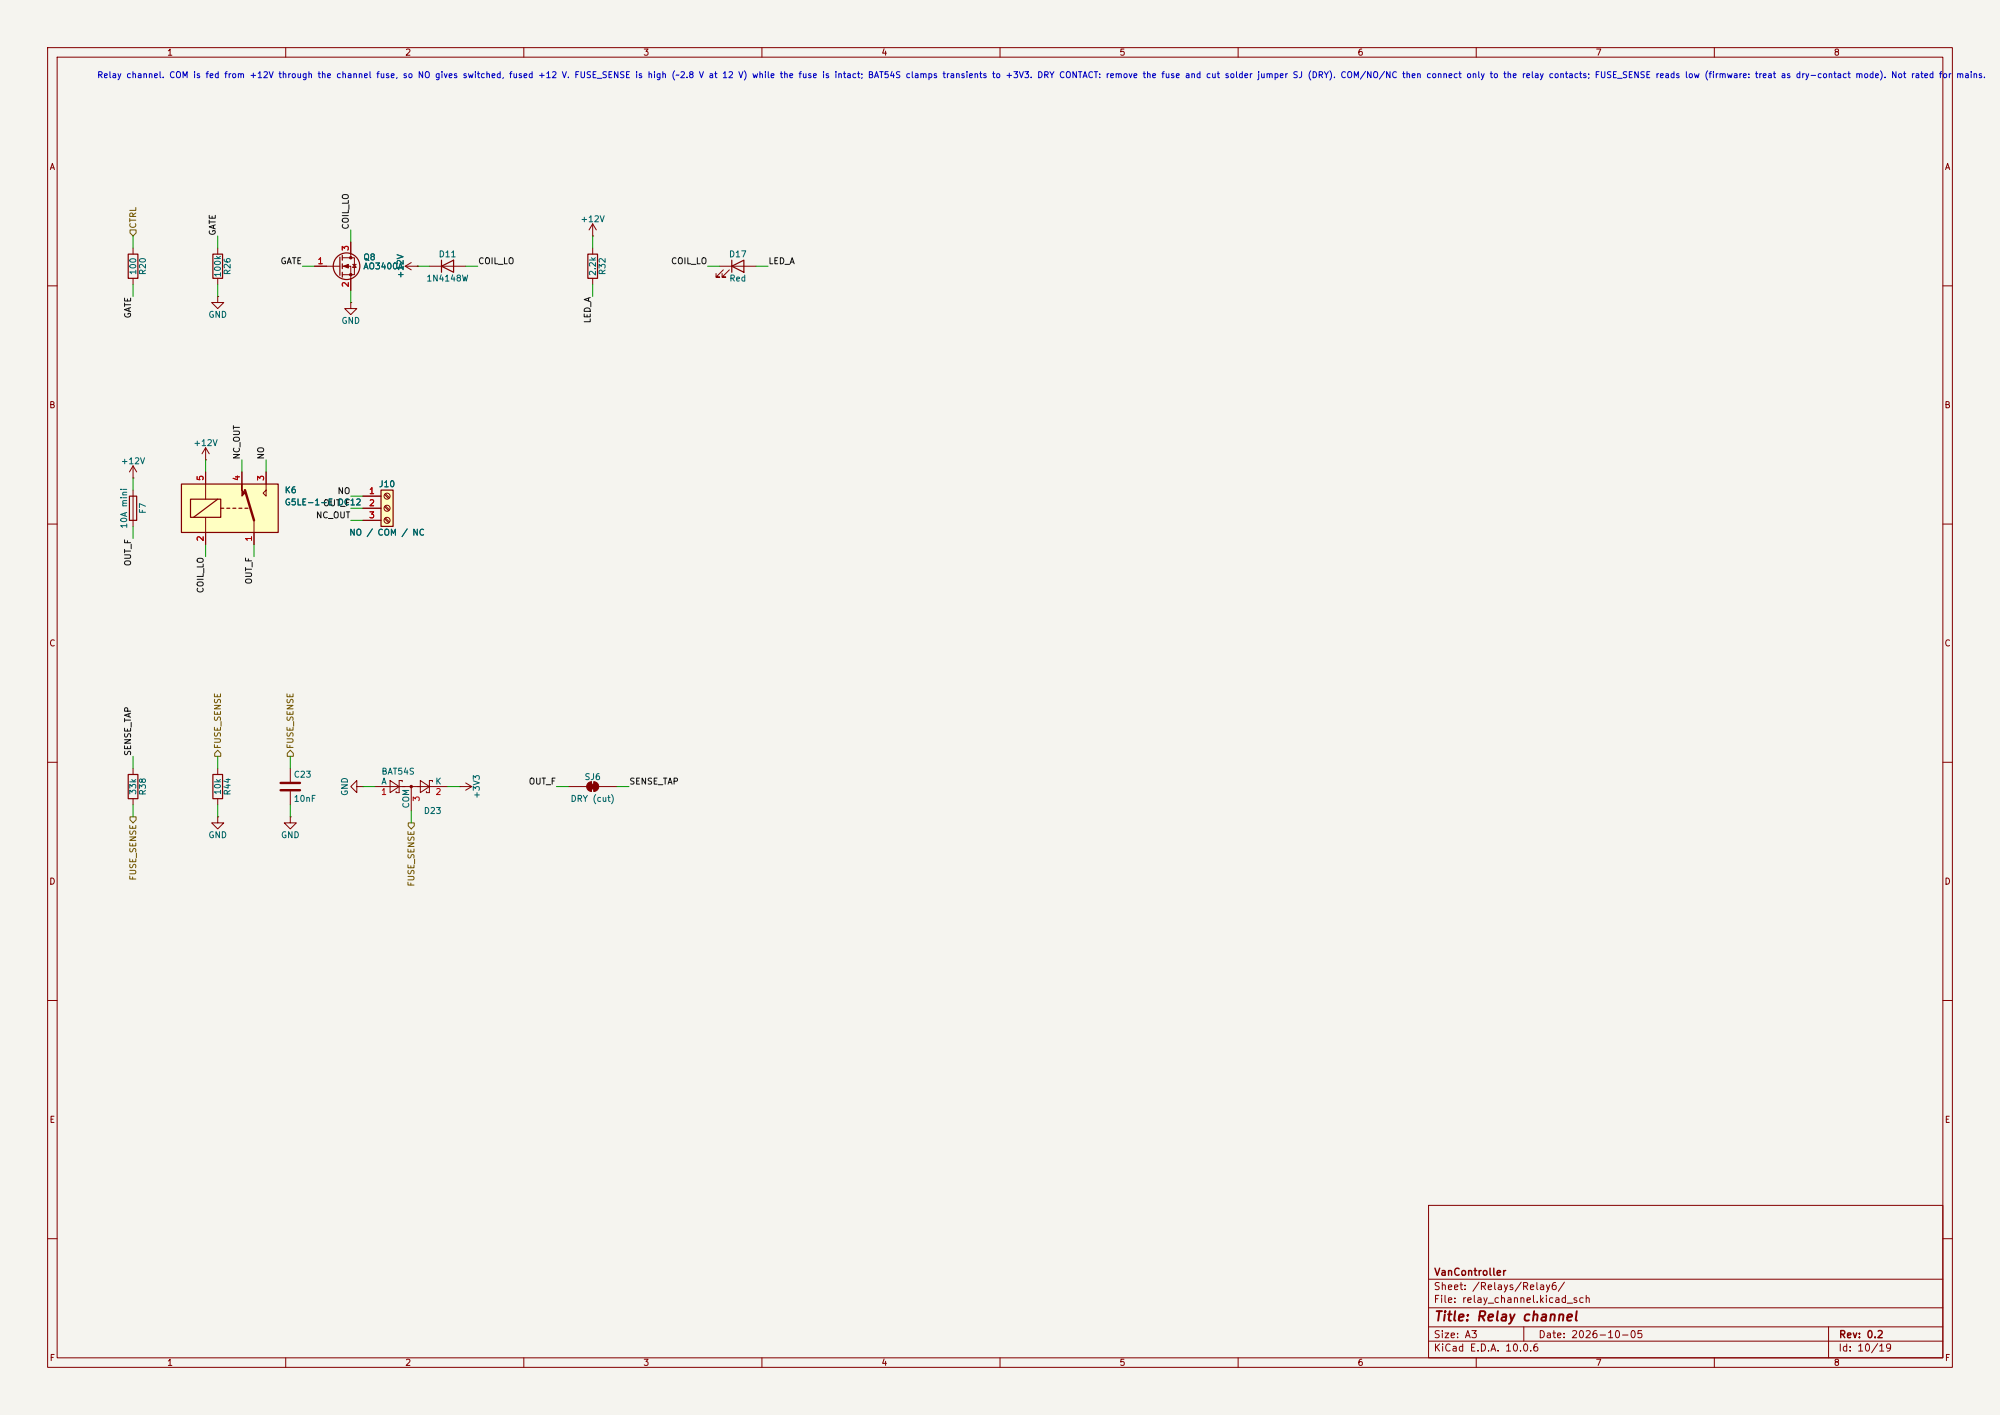
[picture p20: page 10]

GATE Relay channel. COM is fed from +12V through the channel fuse, so NO gives switched, fused +12 V. FUSE_SENSE is high (~2.8 V at 12 V) while the fuse is intact; BAT54S clamps transients to +3V3. DRY CONTACT: remove the fuse and cut solder jumper SJ (DRY). COM/NO/NC then connect only to the relay contacts; FUSE_SENSE reads low (firmware: treat as dry-contact mode). Not rated for mains. Q8
D17 Red +12V 100 R20

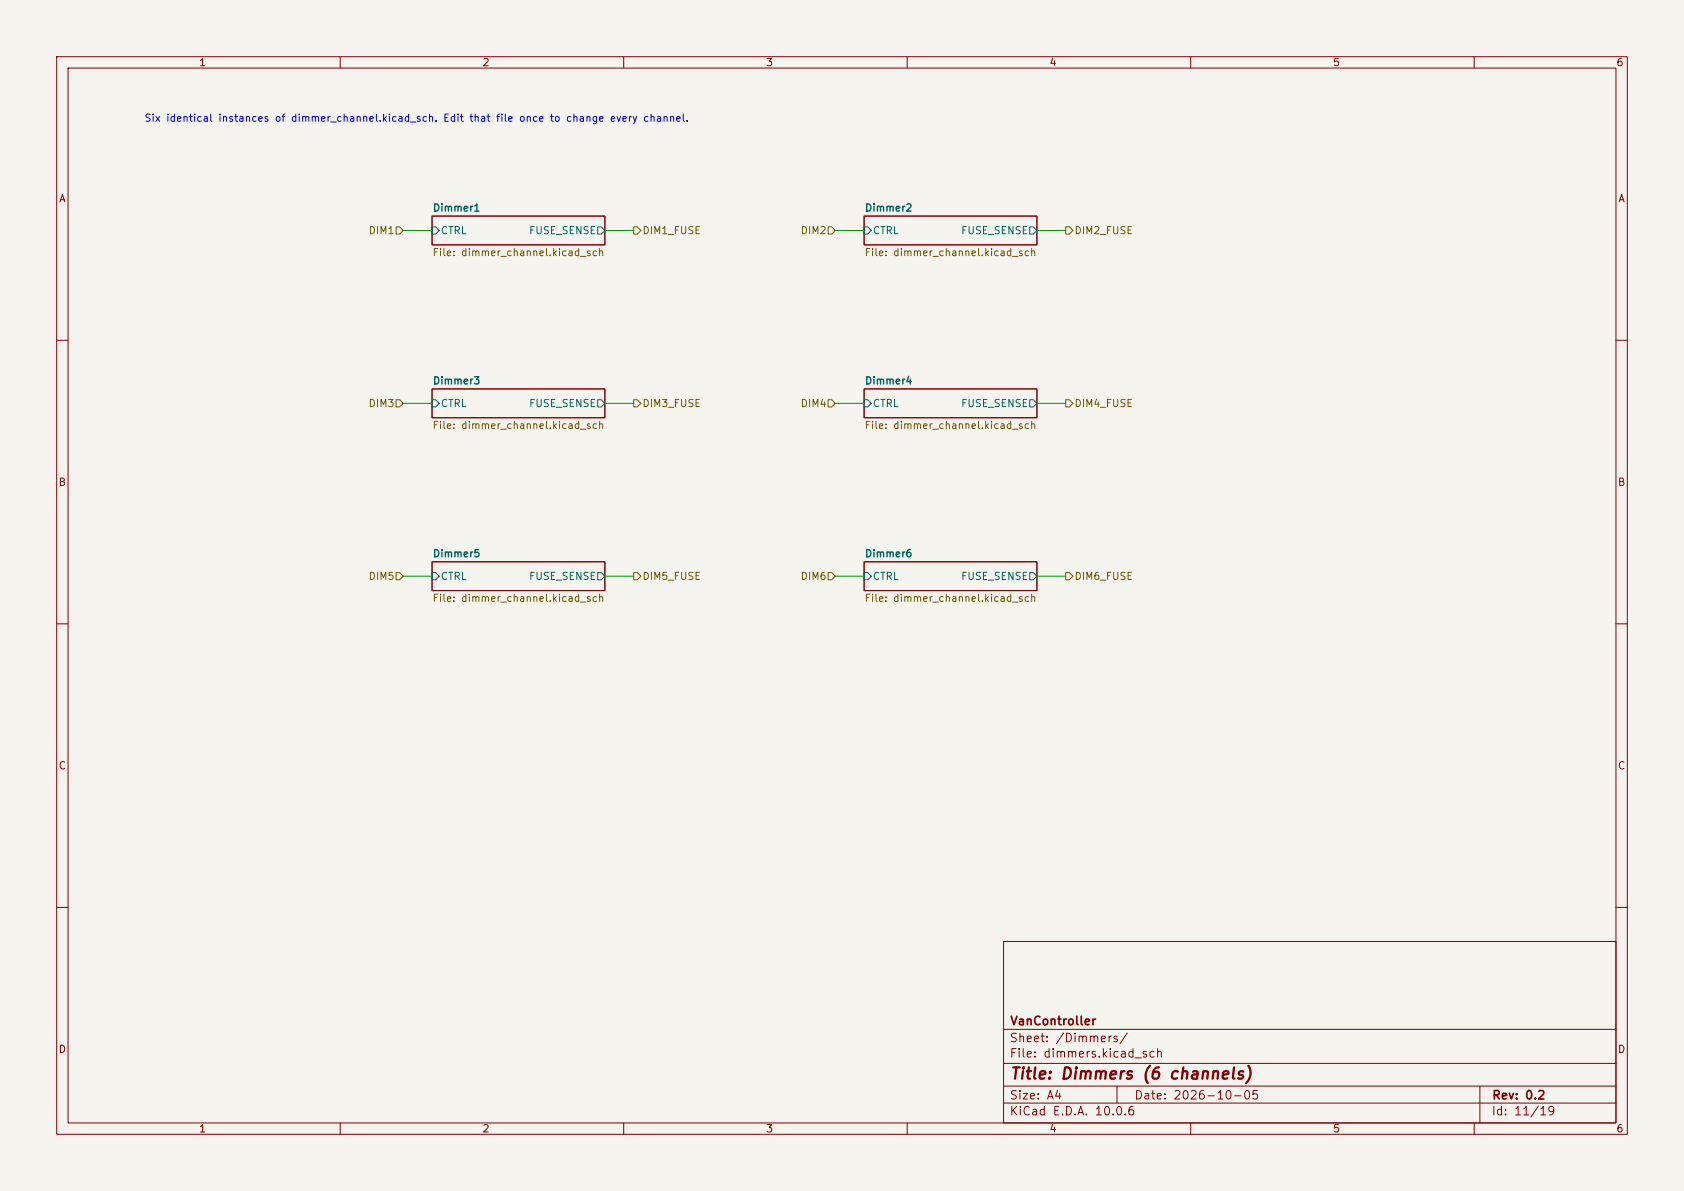
[picture p21: page 11]

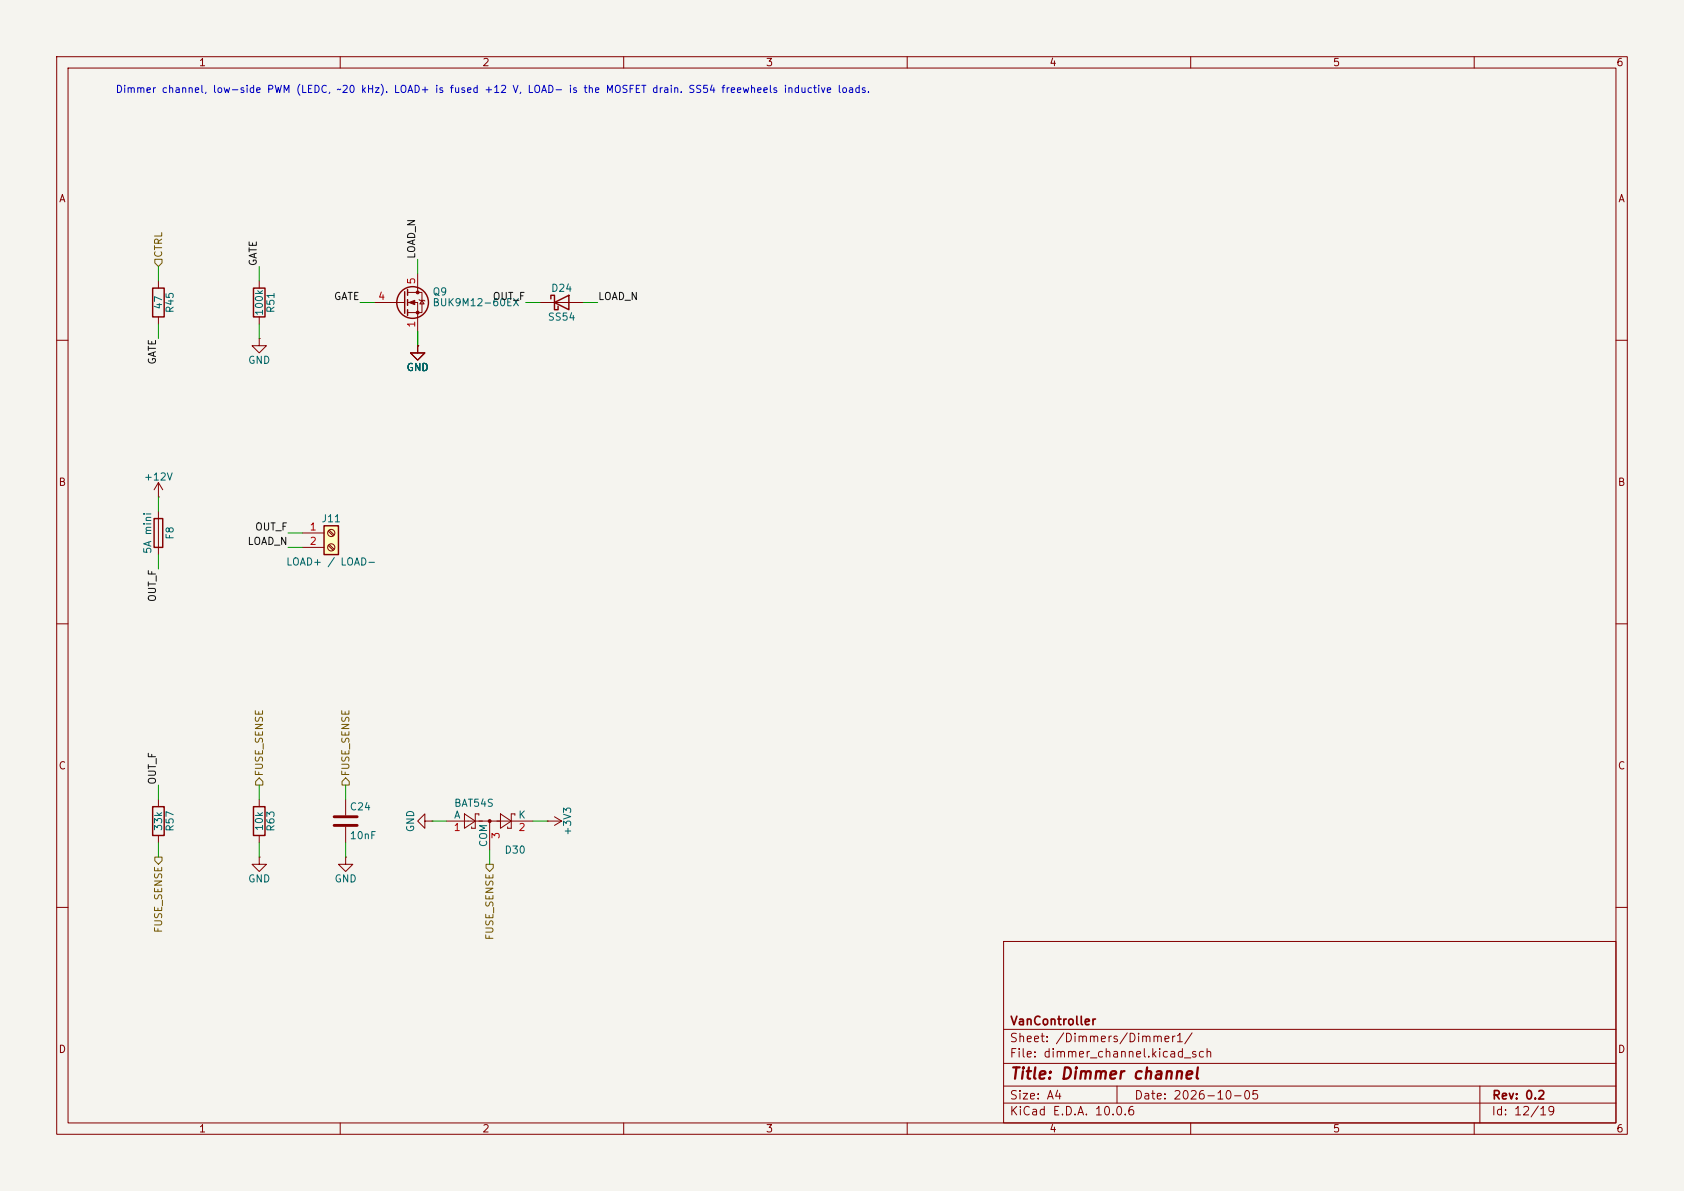
[picture p22: page 12]

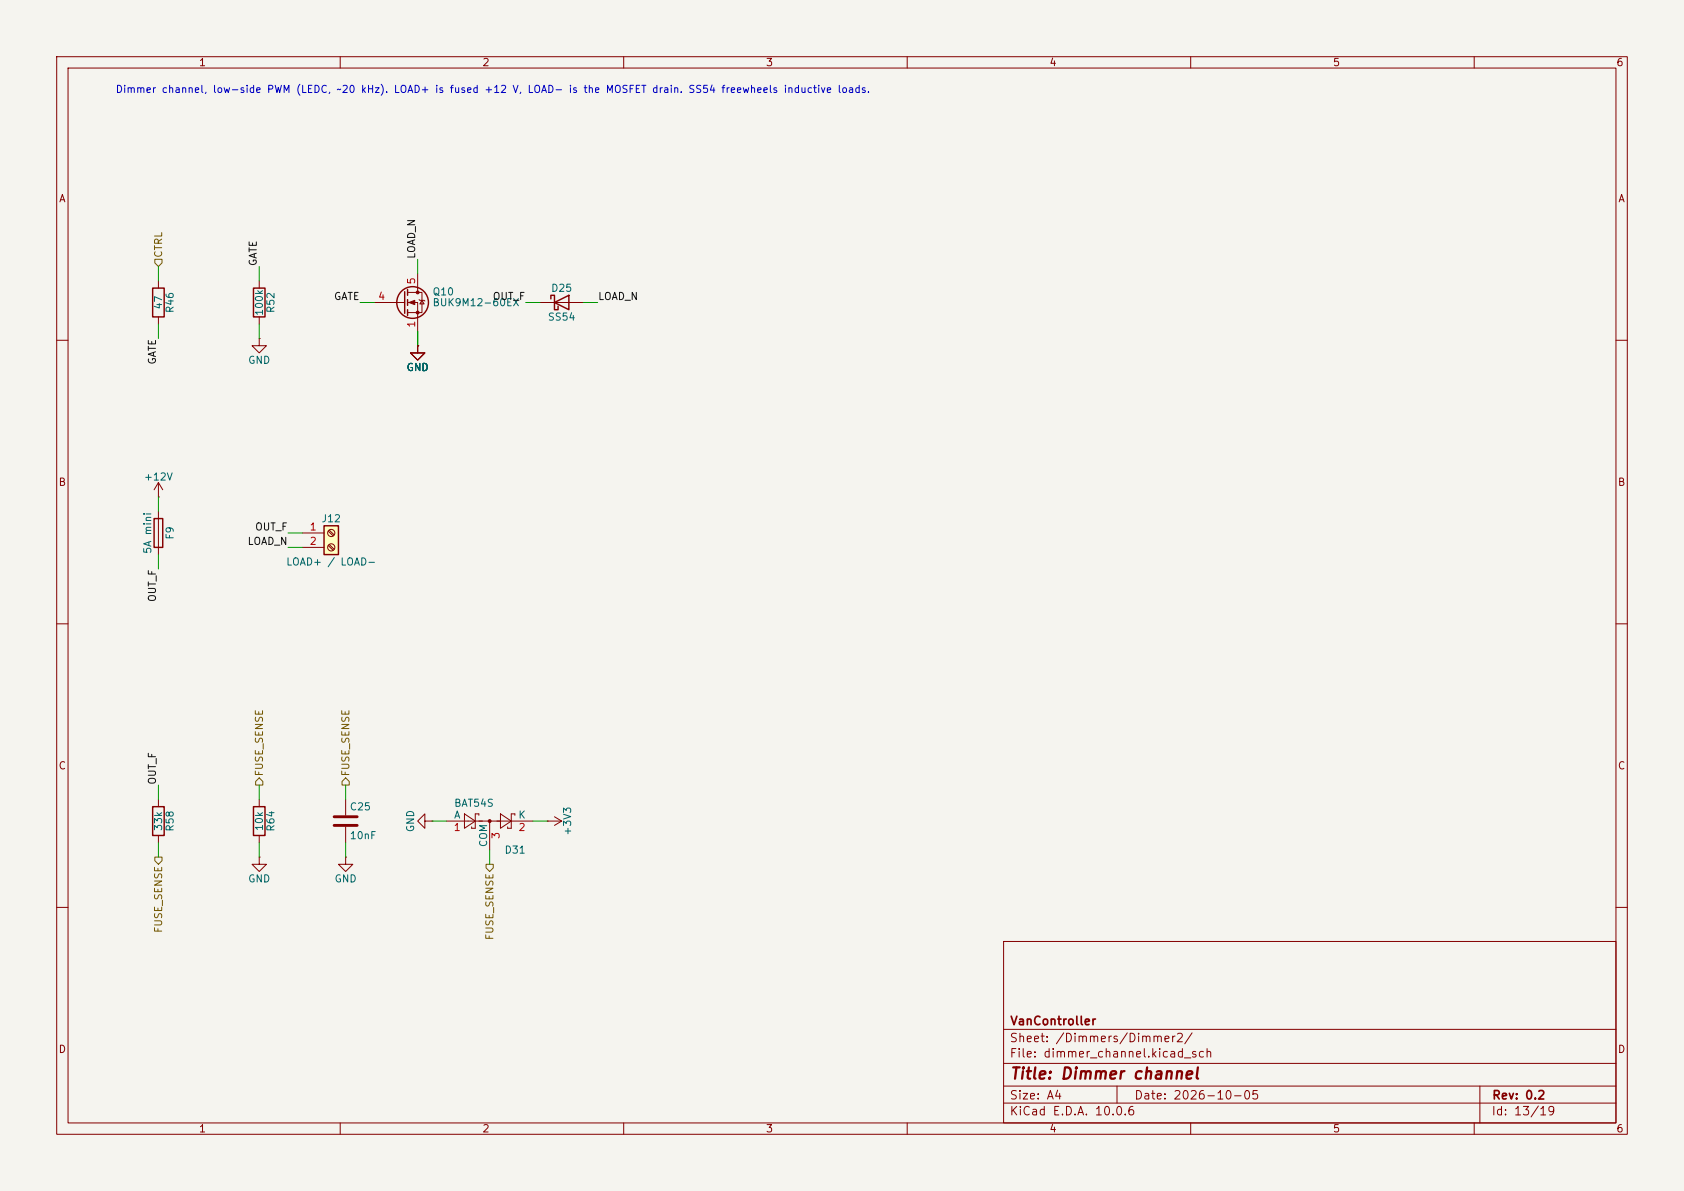
[picture p23: page 13]

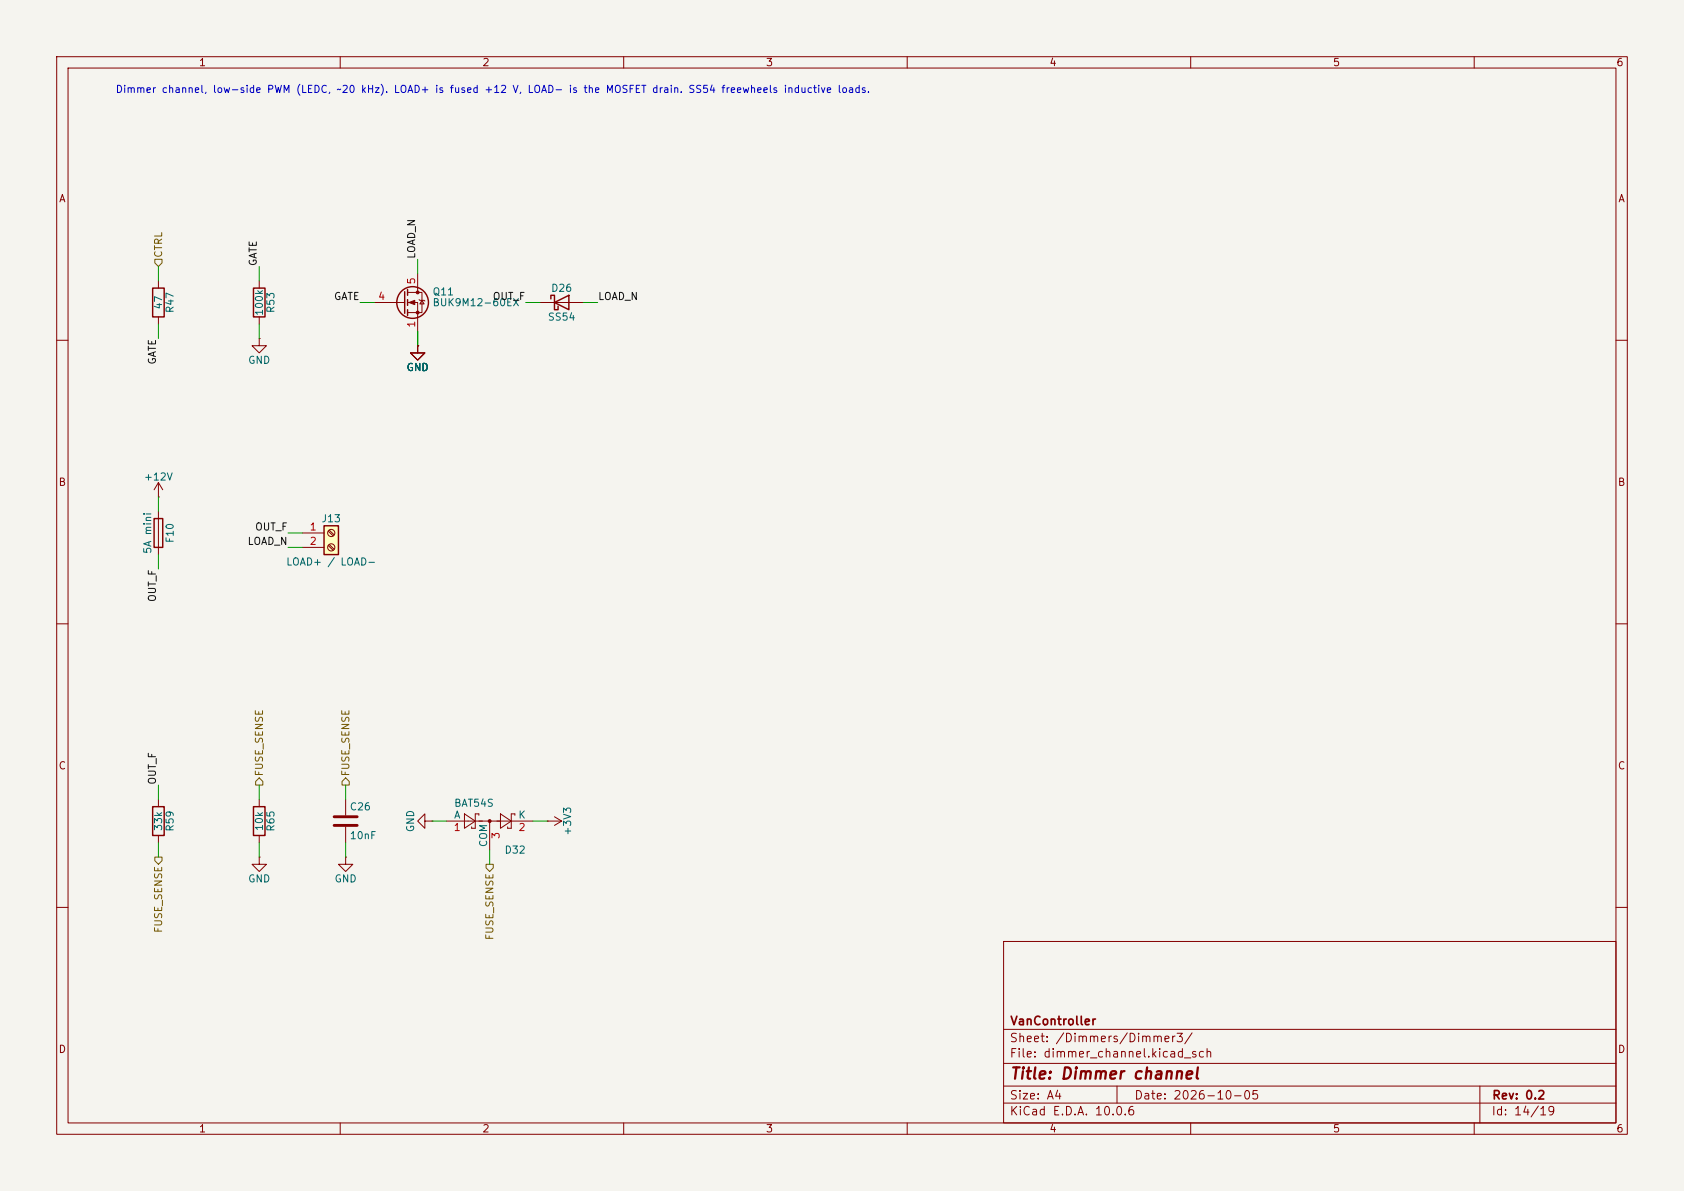
[picture p24: page 14]

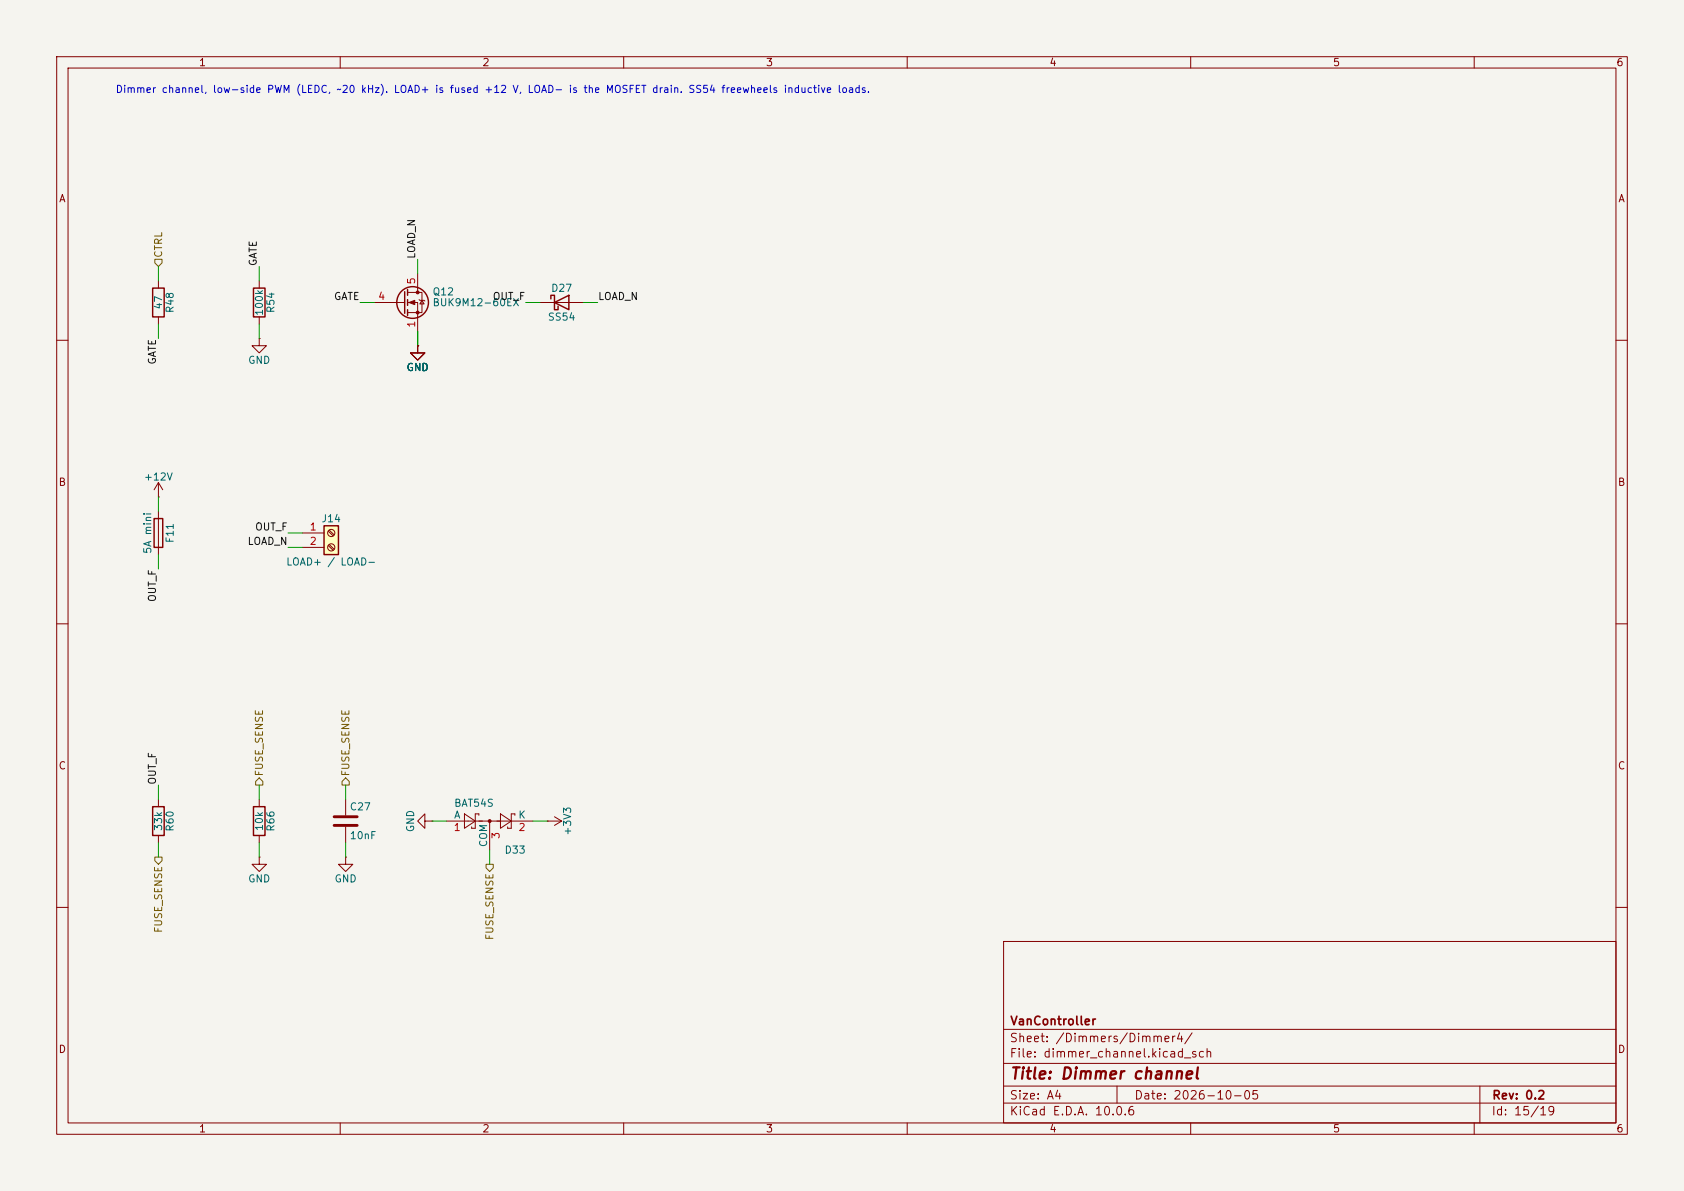
[picture p25: page 15]

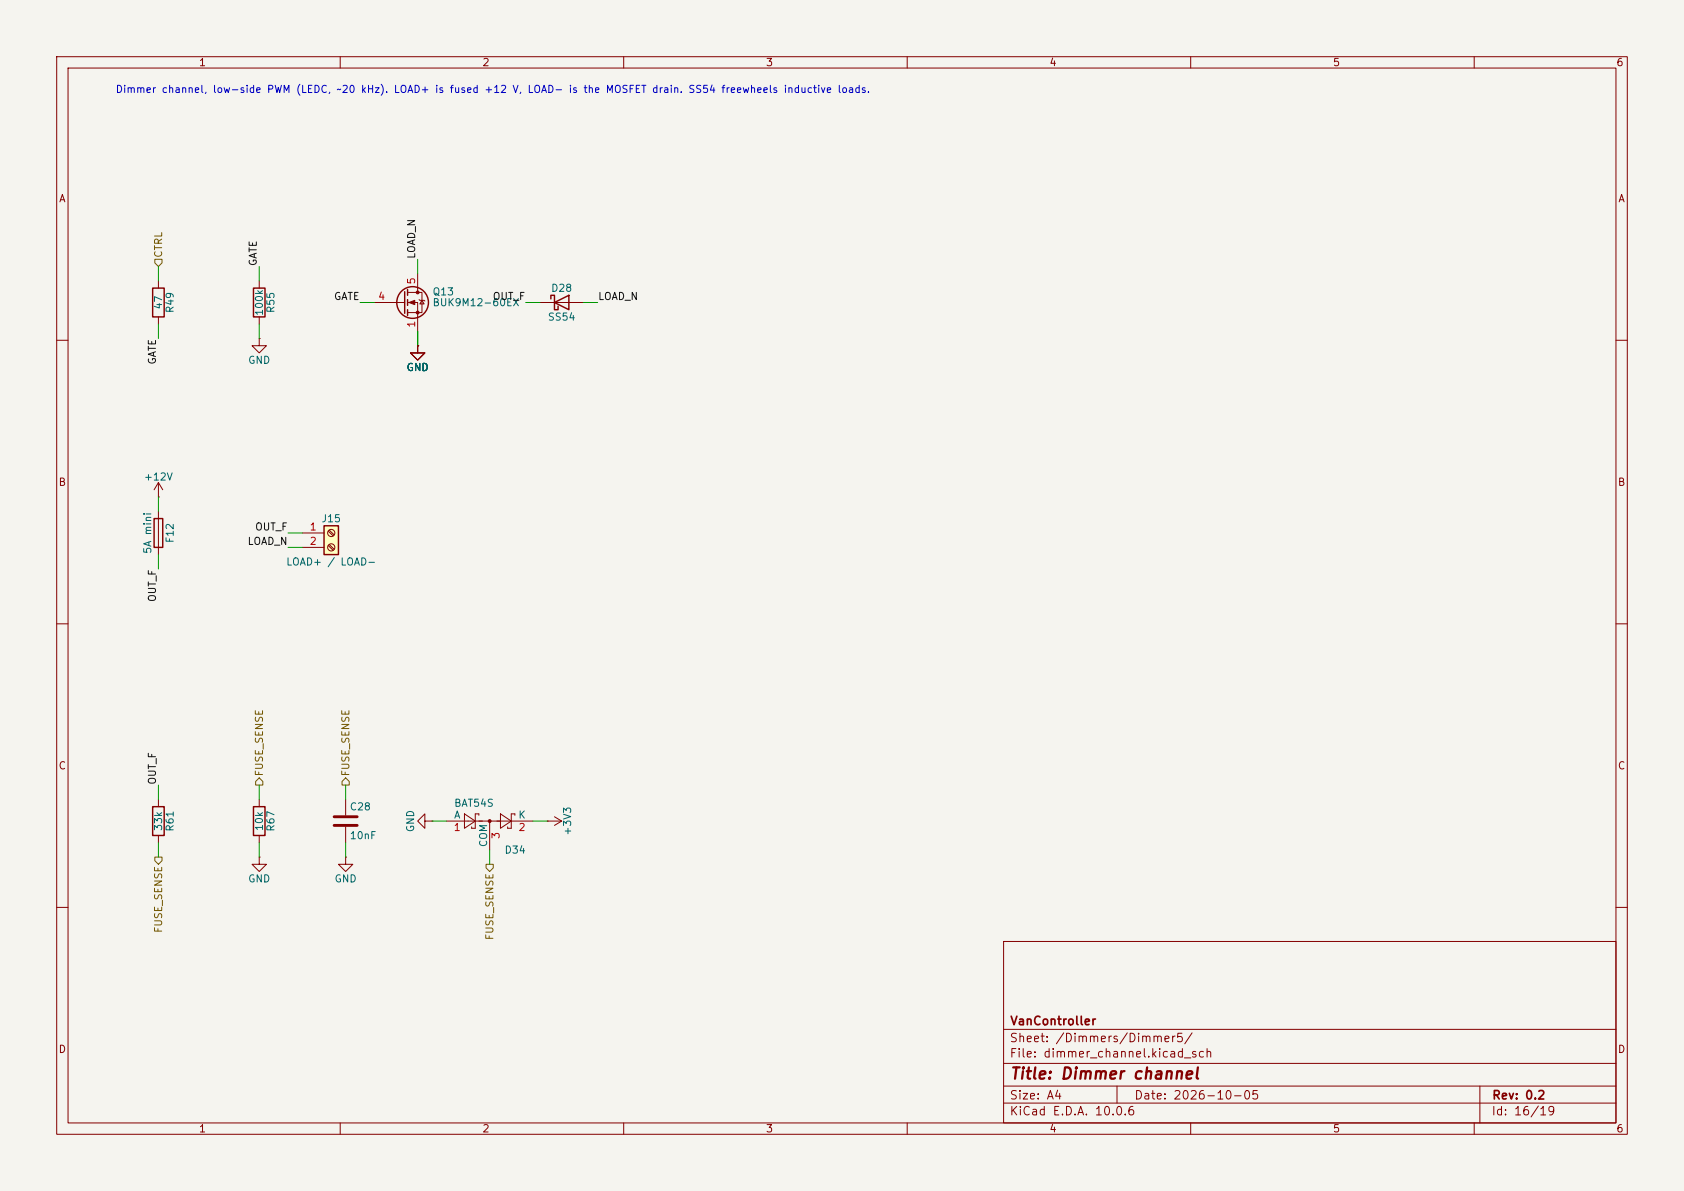
[picture p26: page 16]

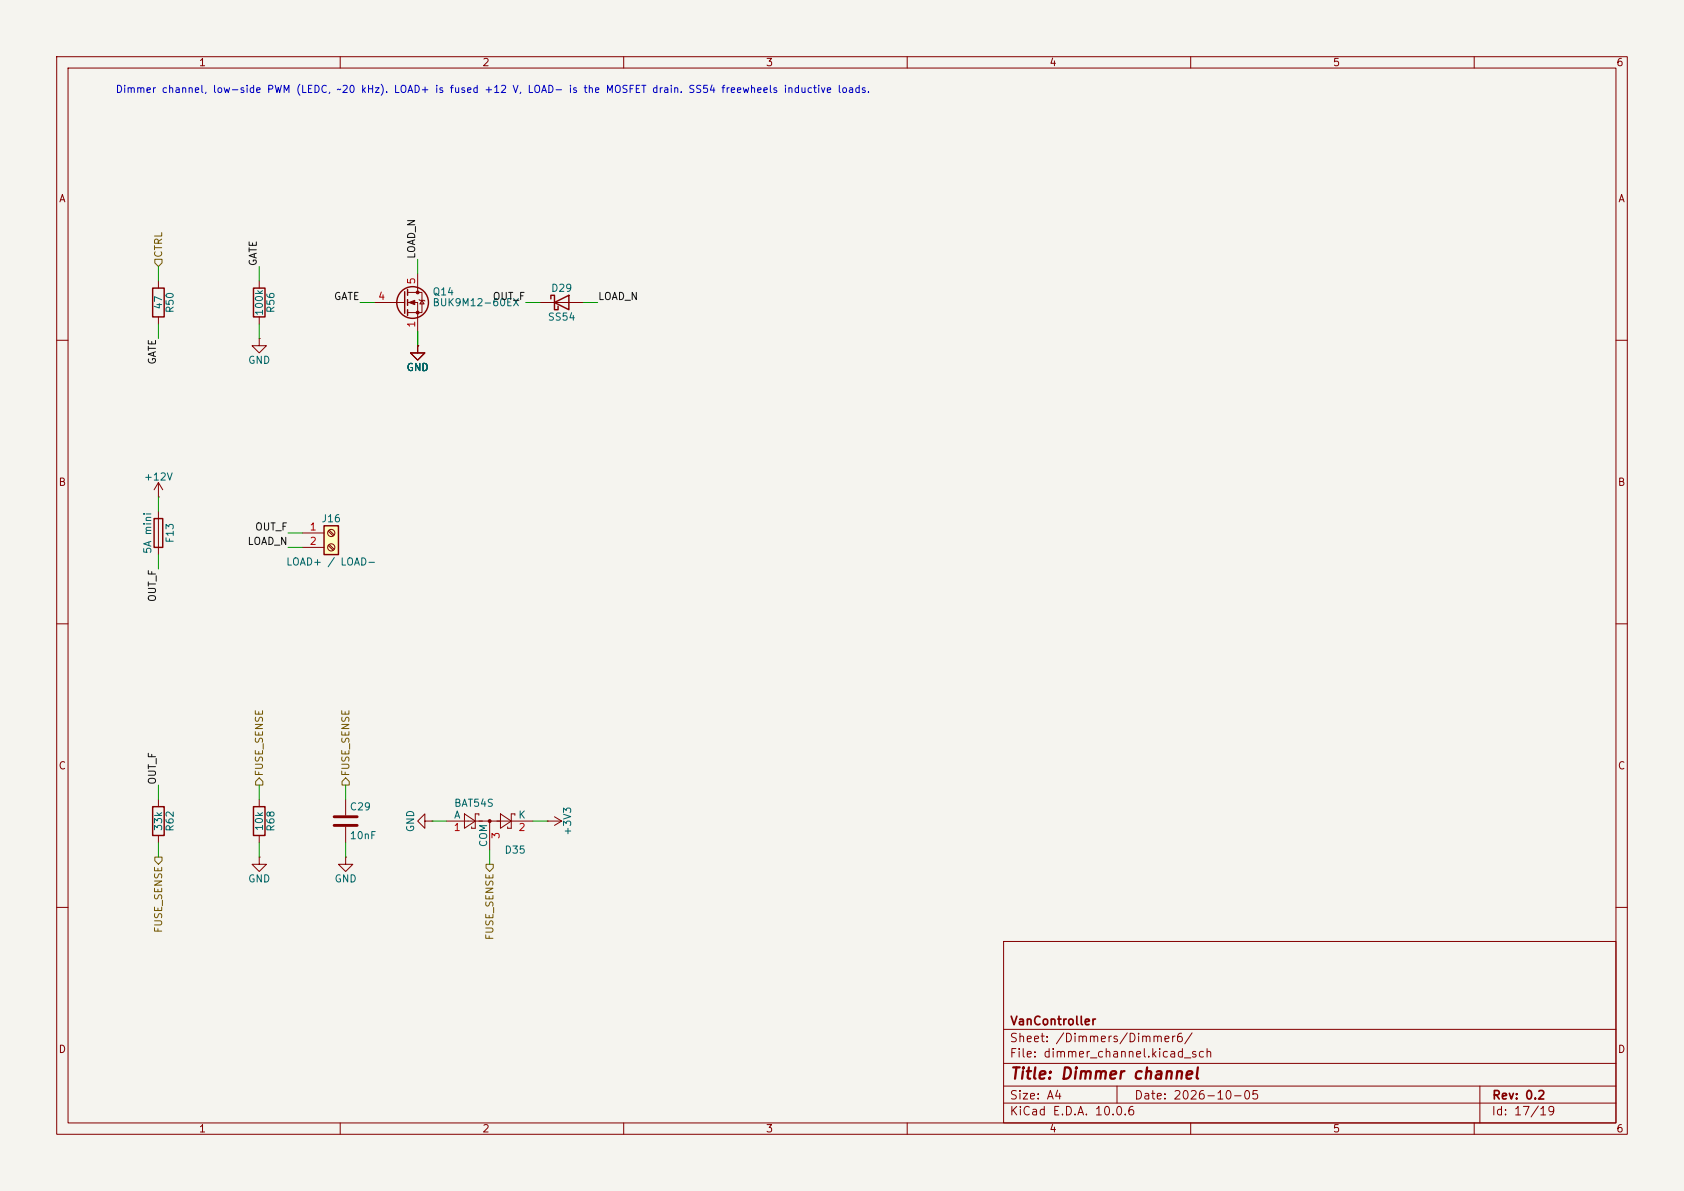
[picture p27: page 17]

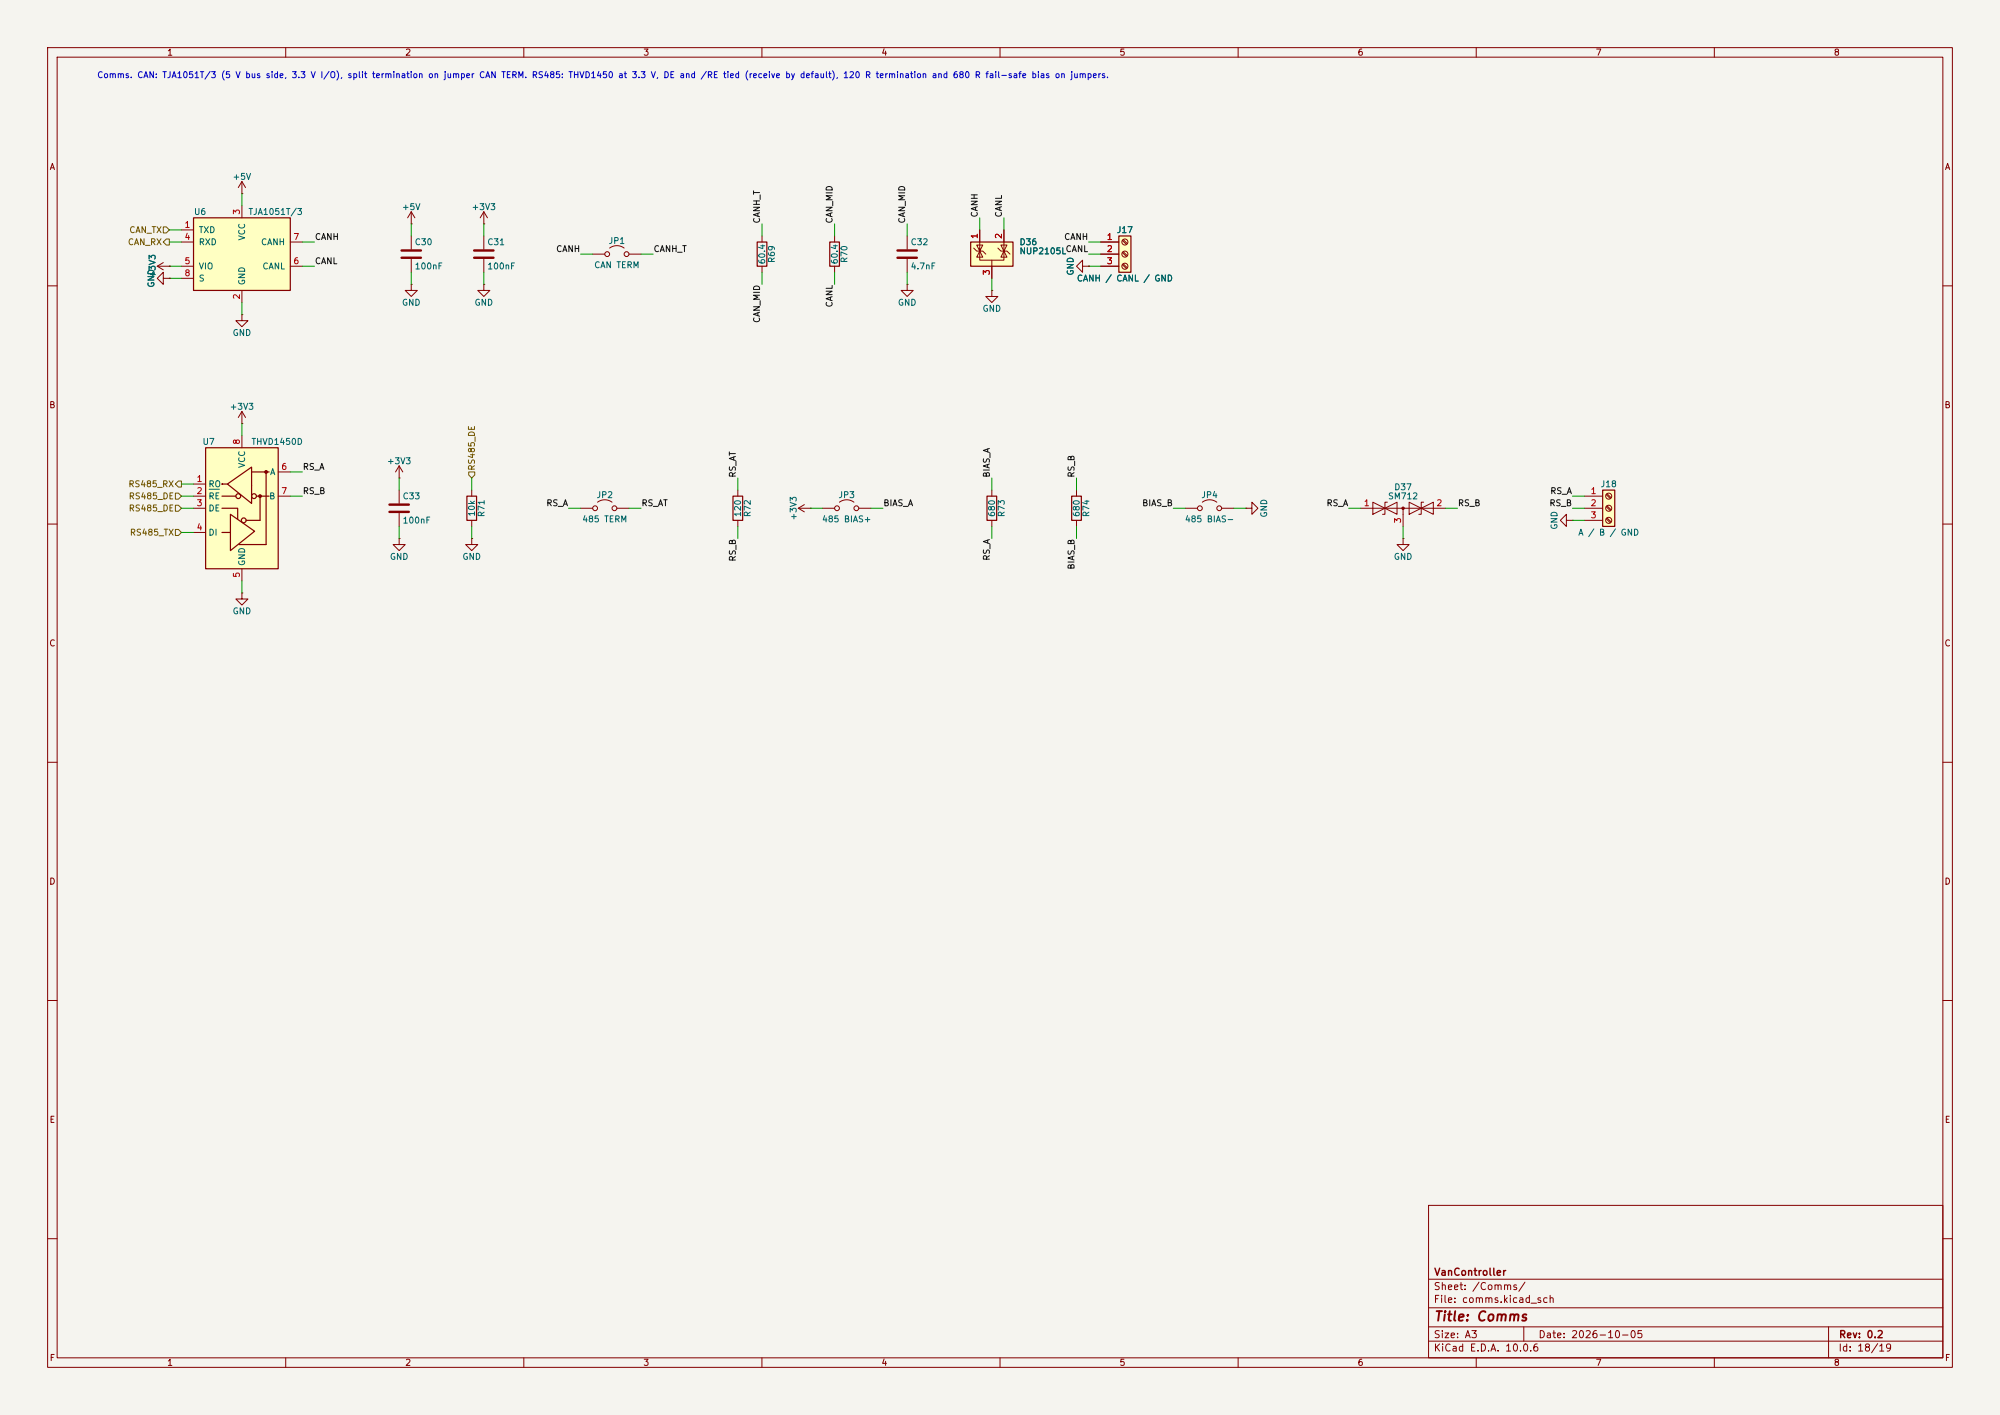
[picture p28: page 18]

RS_B RS_B RS_AT CANH_T Comms. CAN: TJA1051T/3 (5 V bus side, 3.3 V I/O), split termination on jumper CAN TERM. RS485: THVD1450 at 3.3 V, DE and /RE tied (receive by default), 120 R termination and 680 R fail-safe bias on jumpers. +3V3 GND

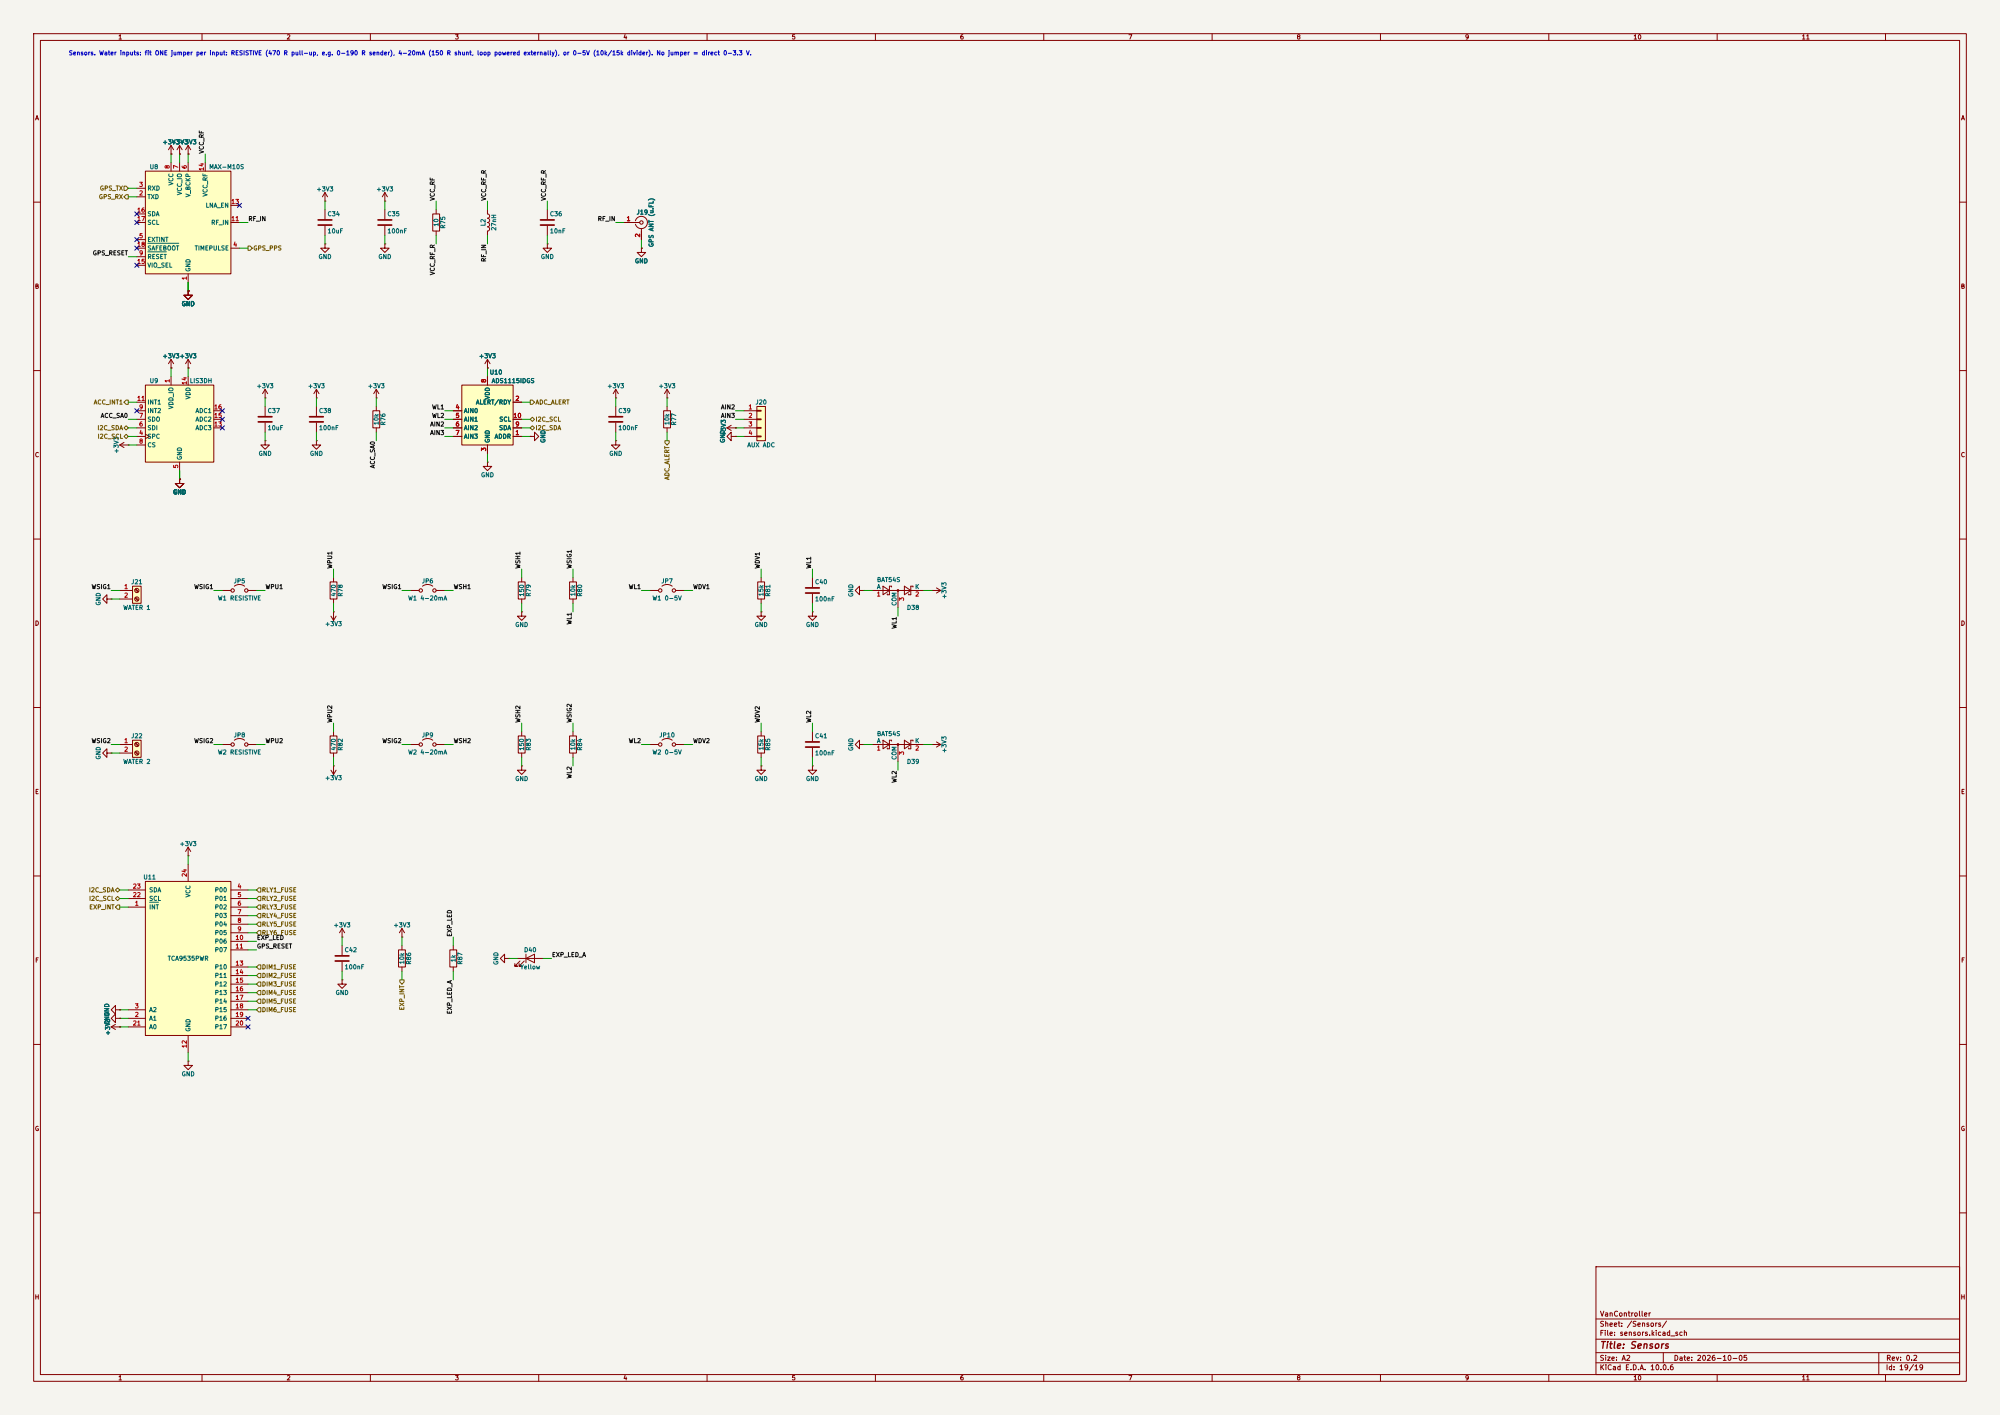
[picture p29: page 19]

Sensors. Water inputs: fit ONE jumper per input: RESISTIVE (470 R pull-up, e.g. 0-190 R sender), 4-20mA (150 R shunt, loop powered externally), or 0-5V (10k/15k divider). No jumper = direct 0-3.3 V. GND +3V3

J19 GPS ANT (u.FL) GND
