Camperlux/vancontroller/docs/VanController_assembly_top.pdf

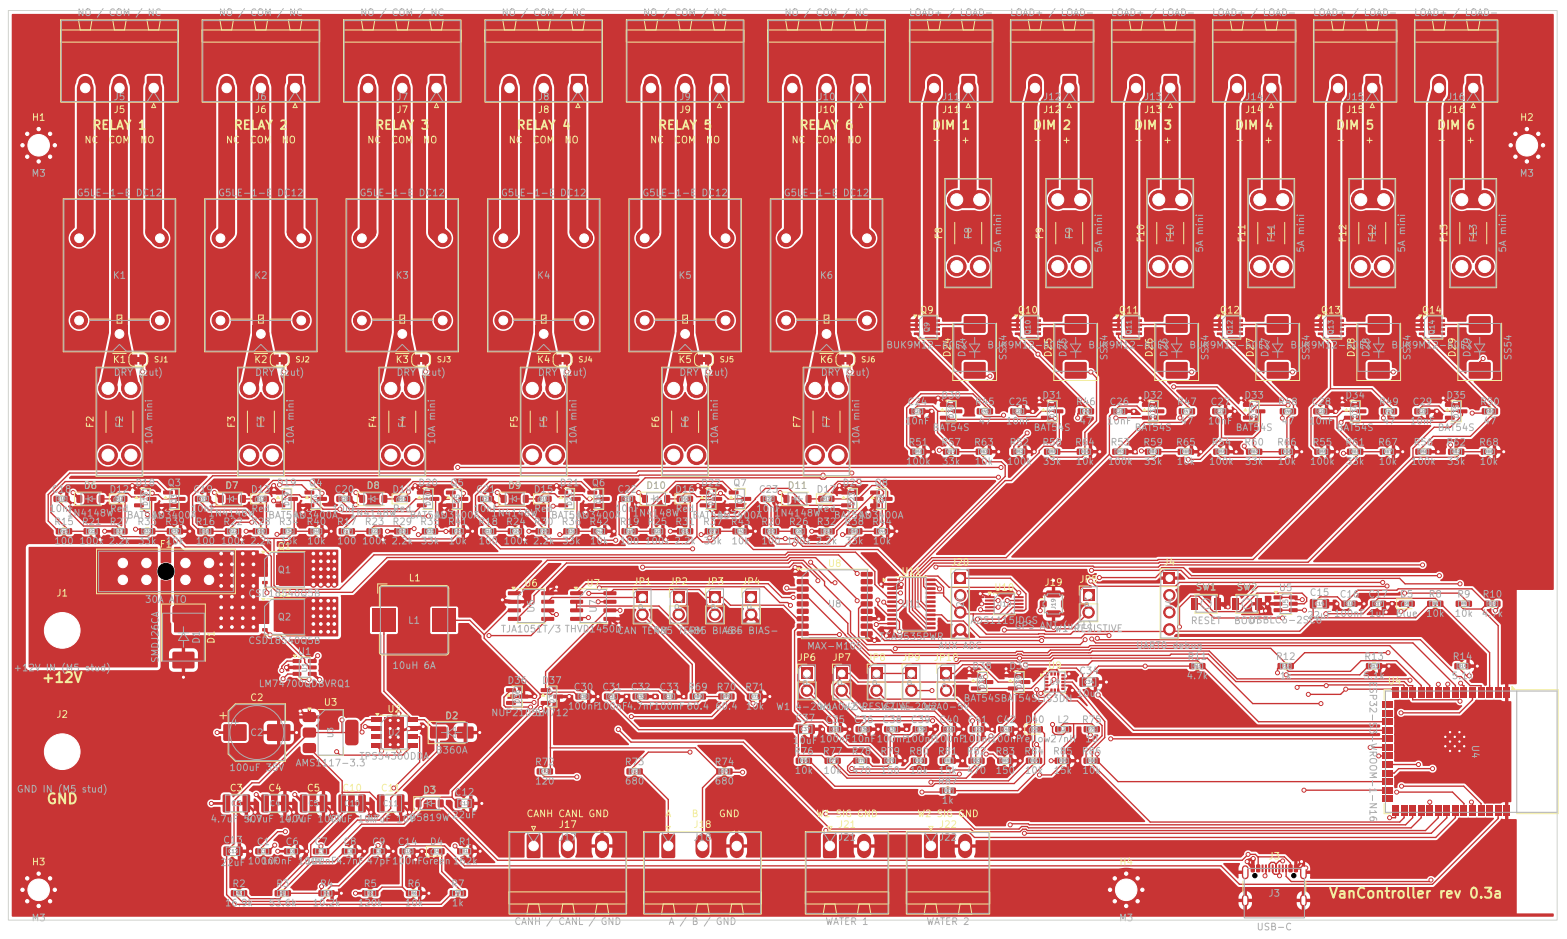
[picture p30: page 1]
