Camperlux/vancontroller/VanController.kicad_pcb

## KiCad design VanController.kicad_pcb (2026-10-14)

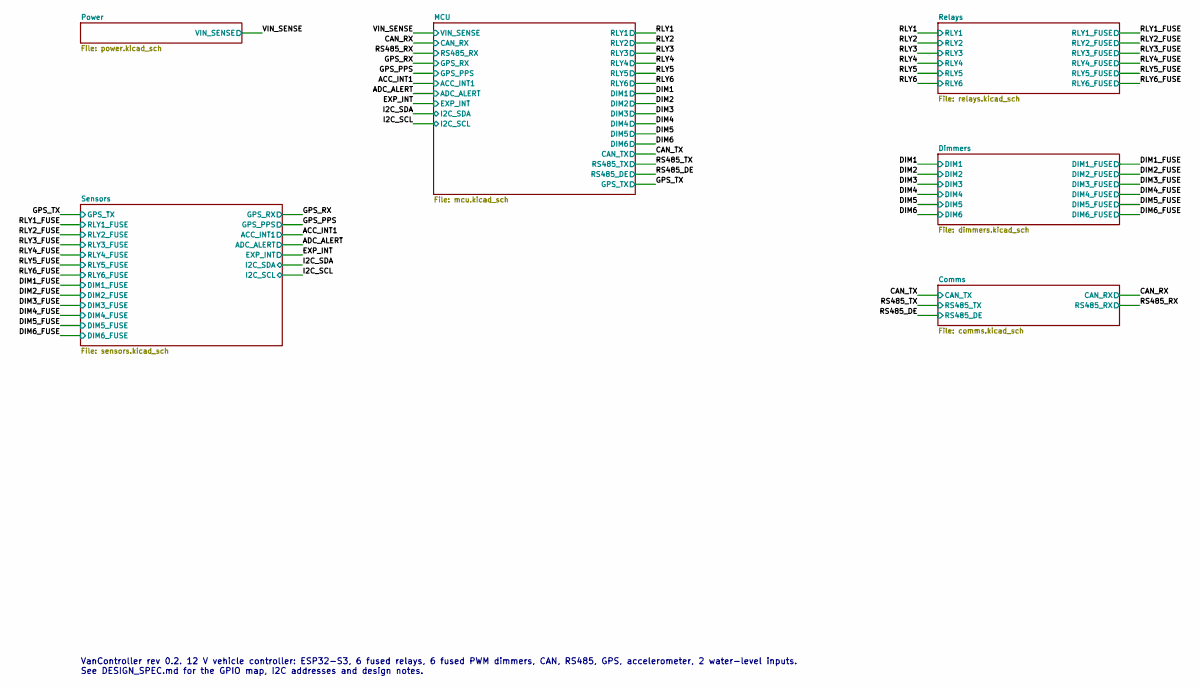
[picture p31: schematic VanController.kicad_sch, VanController: ESP32-S3 12 V controller]

Notes on the sheet:
VanController rev 0.2. 12 V vehicle controller: ESP32-S3, 6 fused relays, 6 fused PWM dimmers, CAN, RS485, GPS, accelerometer, 2 water-level inputs. See DESIGN_SPEC.md for the GPIO map, I2C addresses and design notes.

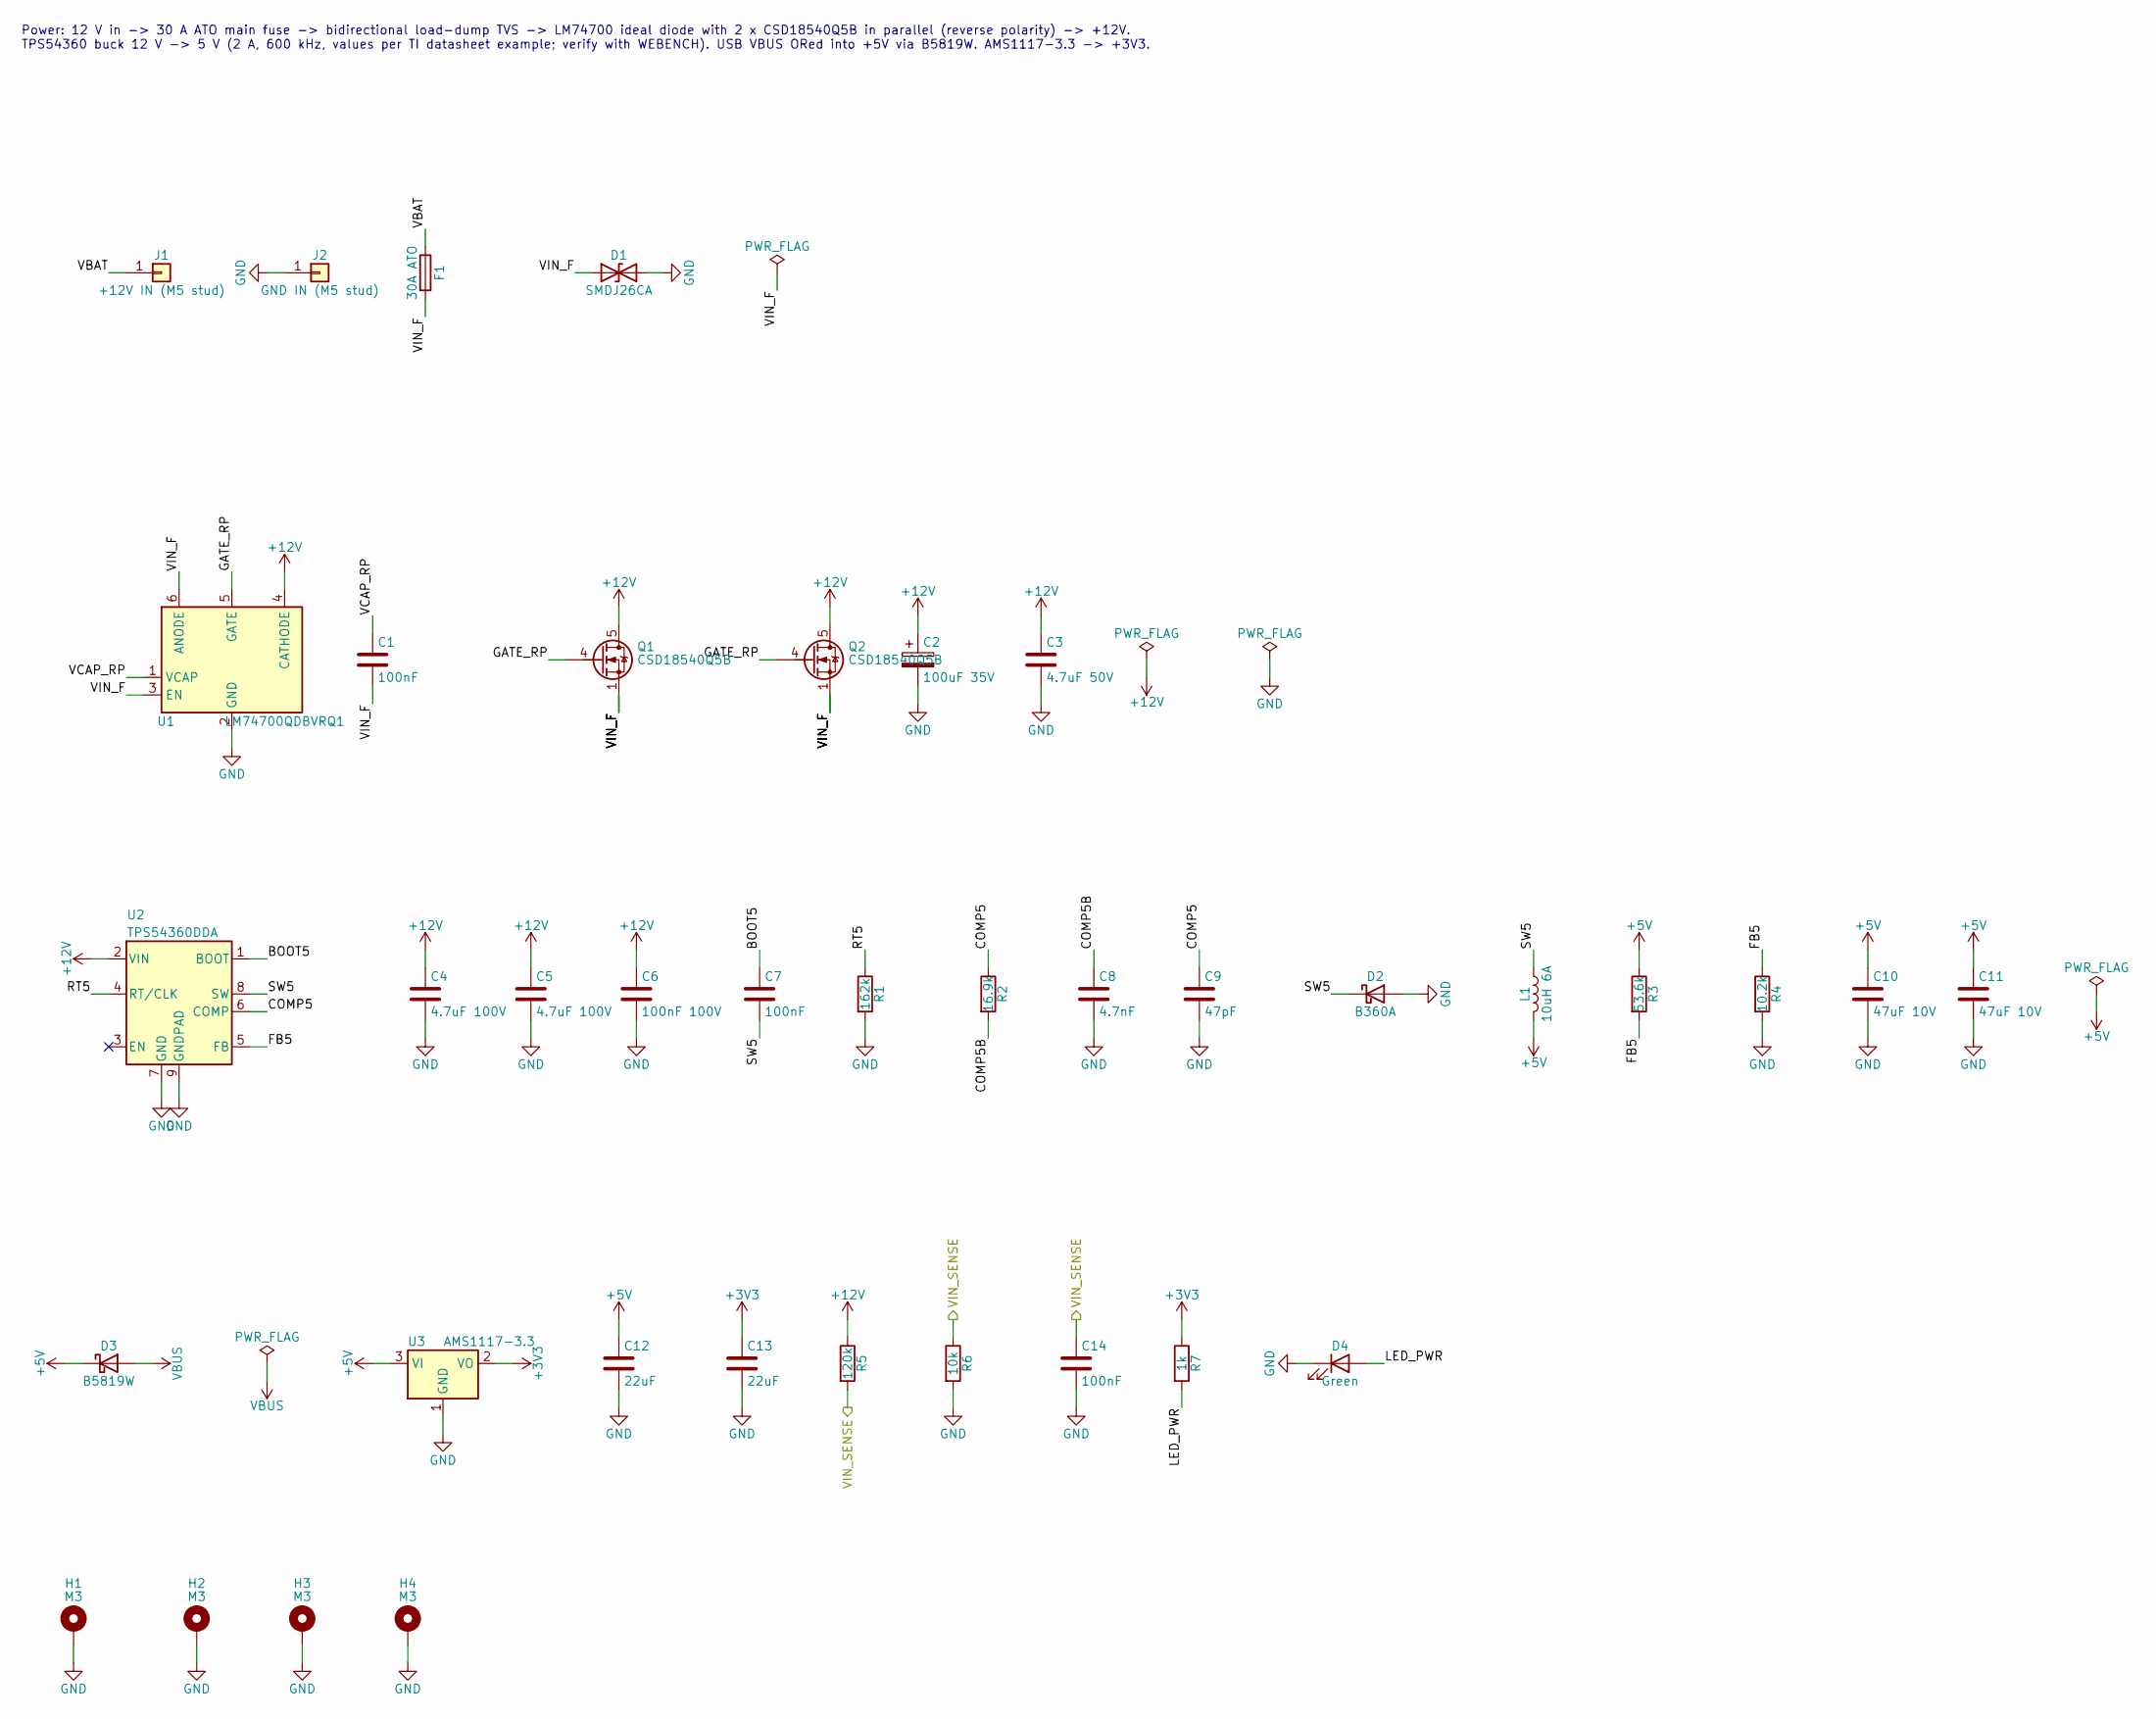
[picture p32: schematic power.kicad_sch]

Parts:
C1, C7, C14: 100nF; C_0603_1608Metric
C2: 100uF 35V; CP_Elec_8x10
C3: 4.7uF 50V; C_1210_3225Metric
C4, C5: 4.7uF 100V; C_1210_3225Metric
C6: 100nF 100V; C_0603_1608Metric
C8: 4.7nF; C_0603_1608Metric
C9: 47pF; C_0603_1608Metric
C10, C11: 47uF 10V; C_1210_3225Metric
C12, C13: 22uF; C_0805_2012Metric
D1: SMDJ26CA; D_SMC
D2: B360A; D_SMA
D3: B5819W; D_SOD-123
D4: Green; LED_0603_1608Metric
F1: 30A ATO; FuseHolder_Blade_ATO_Littelfuse_FLR_178.6165; MPN Littelfuse FLR 178.6165 + 30 A ATO fuse
H1, H2, H3, H4: M3; MountingHole_3.2mm_M3_Pad_Via
J1: +12V IN (M5 stud); MountingHole_5.3mm_M5_DIN965_Pad
J2: GND IN (M5 stud); MountingHole_5.3mm_M5_DIN965_Pad
L1: 10uH 6A; L_Bourns_SRP1038C_10.0x10.0mm; MPN Bourns SRP1038C-100M
Q1, Q2: CSD18540Q5B; TDSON-8-1
R1: 162k; R_0603_1608Metric
R2: 16.9k; R_0603_1608Metric
R3: 53.6k; R_0603_1608Metric
R4: 10.2k; R_0603_1608Metric
R5: 120k; R_0603_1608Metric
R6: 10k; R_0603_1608Metric
R7: 1k; R_0603_1608Metric
U1: LM74700QDBVRQ1; SOT-23-6
U2: TPS54360DDA; TI_SO-PowerPAD-8_ThermalVias
U3: AMS1117-3.3; SOT-223-3_TabPin2

Connections:
+3V3: C13.1, R7.1, U3.2 (VO); also elsewhere on the board
+5V: C10.1, C11.1, C12.1, D3.1 (K), L1.2, R3.1, U3.3 (VI); also elsewhere on the board
+12V: C2.1, C3.1, C4.1, C5.1, C6.1, Q1.5 (D), Q2.5 (D), R5.1, U1.4 (CATHODE), U2.2 (VIN); also elsewhere on the board
/Power/BOOT5: C7.1, U2.1 (BOOT)
/Power/COMP5: C9.1, R2.1, U2.6 (COMP)
/Power/COMP5B: C8.1, R2.2
/Power/FB5: R3.2, R4.1, U2.5 (FB)
/Power/GATE_RP: Q1.4 (G), Q2.4 (G), U1.5 (GATE)
/Power/LED_PWR: D4.2 (A), R7.2
/Power/RT5: R1.1, U2.4 (RT/CLK)
/Power/SW5: C7.2, D2.1 (K), L1.1, U2.8 (SW)
/Power/VBAT: F1.1, J1.1
/Power/VCAP_RP: C1.1, U1.1 (VCAP)
/Power/VIN_F: C1.2, D1.1 (A1), F1.2, Q1.1 (S), Q1.2 (S), Q1.3 (S), Q2.1 (S), Q2.2 (S), Q2.3 (S), U1.3 (EN), U1.6 (ANODE)
/VIN_SENSE: C14.1, R5.2, R6.1; also elsewhere on the board
GND: C2.2, C3.2, C4.2, C5.2, C6.2, C8.2, C9.2, C10.2, C11.2, C12.2, C13.2, C14.2, D1.2 (A2), D2.2 (A), D4.1 (K), H1.1, H2.1, H3.1, H4.1, J2.1, R1.2, R4.2, R6.2, U1.2 (GND), U2.7 (GND), U2.9 (GNDPAD), U3.1 (GND); also elsewhere on the board
VBUS: D3.2 (A); also elsewhere on the board

Notes on the sheet:
Power: 12 V in -> 30 A ATO main fuse -> bidirectional load-dump TVS -> LM74700 ideal diode with 2 x CSD18540Q5B in parallel (reverse polarity) -> +12V. TPS54360 buck 12 V -> 5 V (2 A, 600 kHz, values per TI datasheet example; verify with WEBENCH). USB VBUS ORed into +5V via B5819W. AMS1117-3.3 -> +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

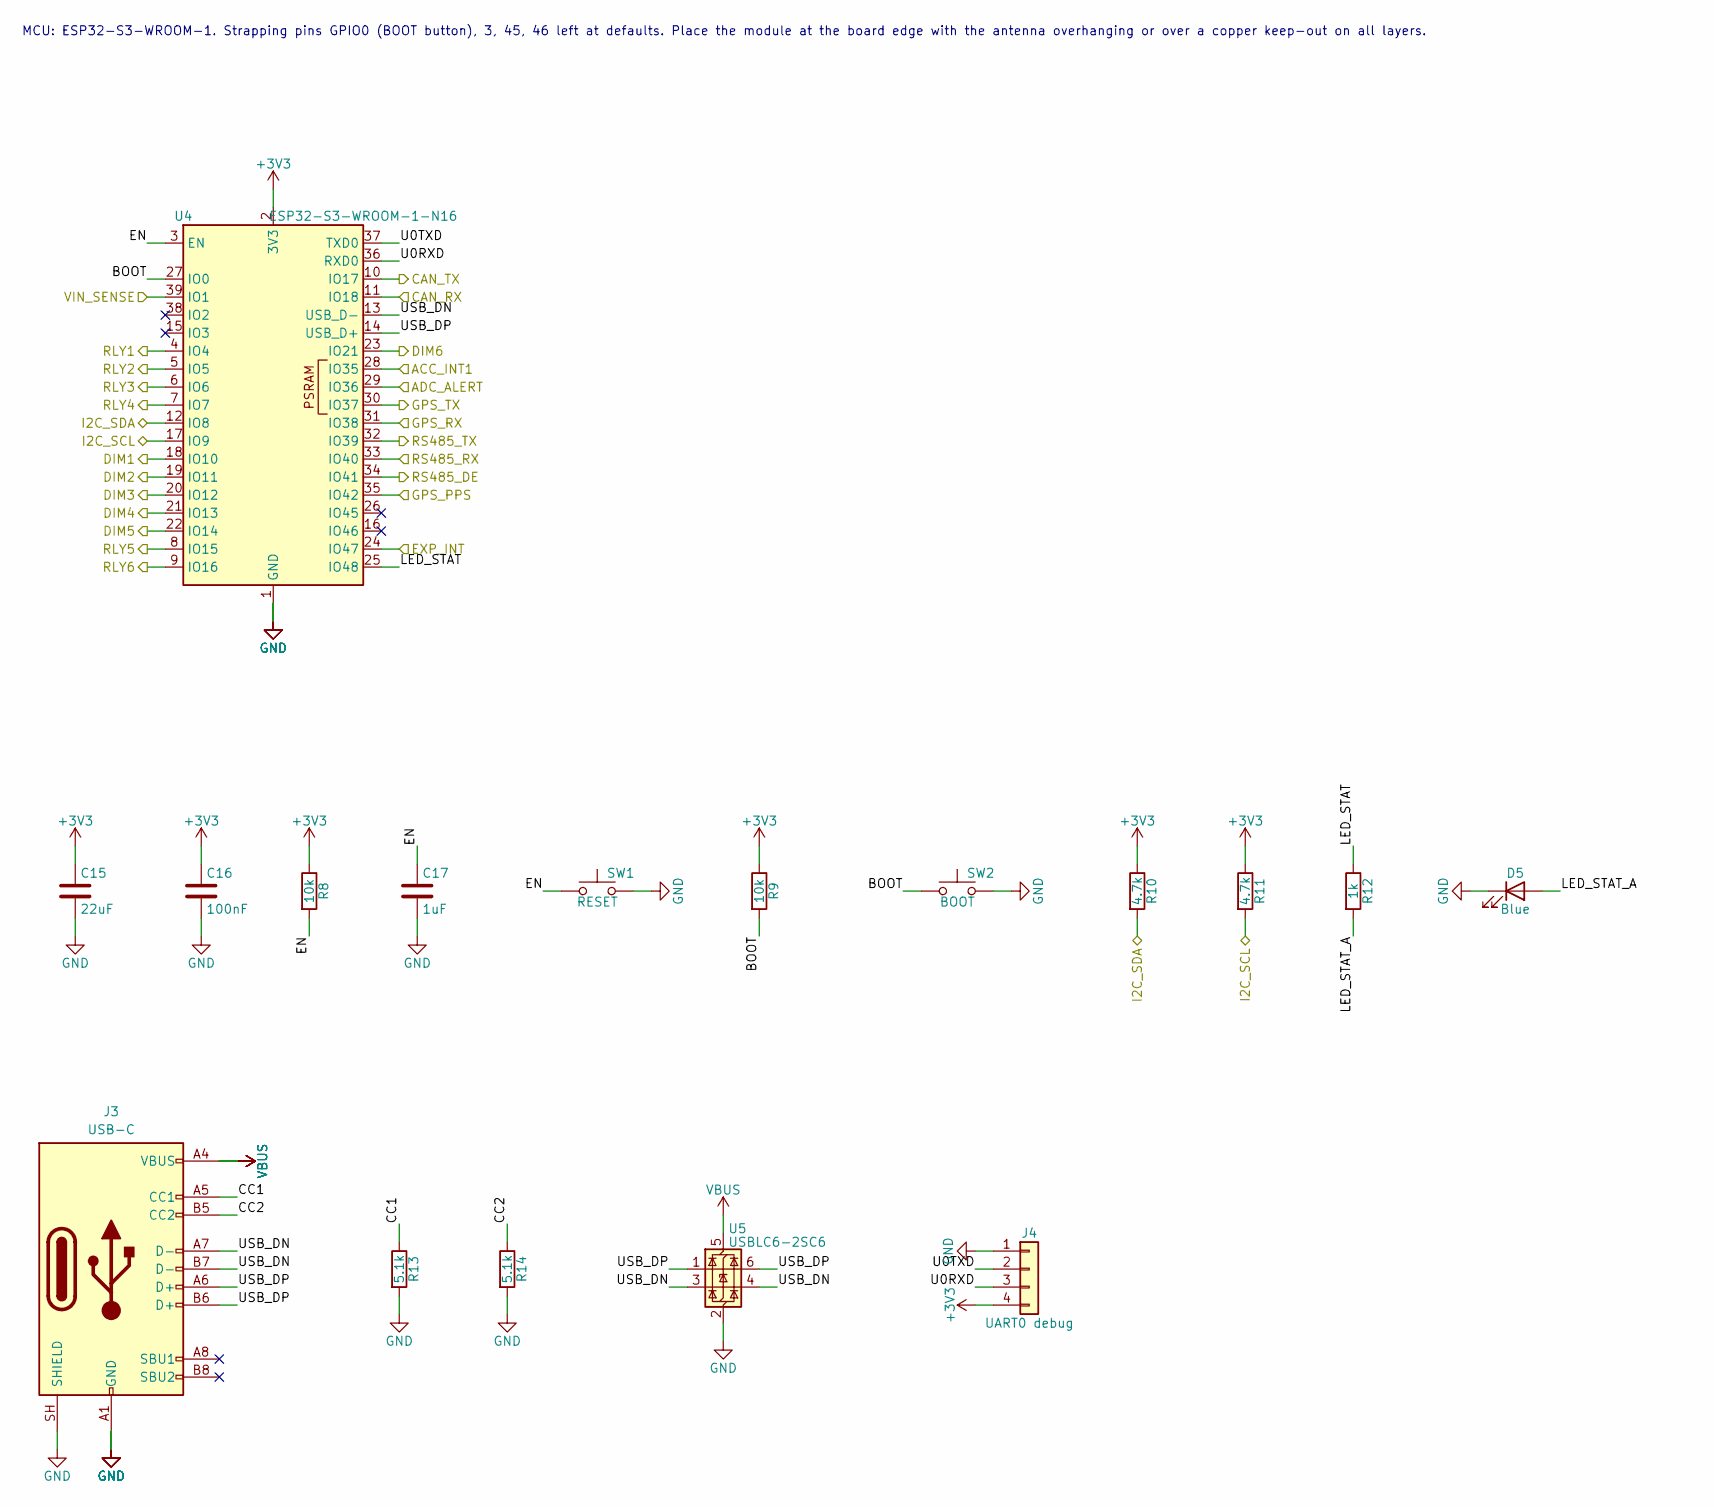
[picture p33: schematic mcu.kicad_sch]

Parts:
C15: 22uF; C_0805_2012Metric
C16: 100nF; C_0603_1608Metric
C17: 1uF; C_0603_1608Metric
D5: Blue; LED_0603_1608Metric
J3: USB-C; USB_C_Receptacle_GCT_USB4105-xx-A_16P_TopMnt_Horizontal
J4: UART0 debug; PinHeader_1x04_P2.54mm_Vertical
R8, R9: 10k; R_0603_1608Metric
R10, R11: 4.7k; R_0603_1608Metric
R12: 1k; R_0603_1608Metric
R13, R14: 5.1k; R_0603_1608Metric
SW1: RESET; SW_SPST_B3U-1000P
SW2: BOOT; SW_SPST_B3U-1000P
U4: ESP32-S3-WROOM-1-N16; ESP32-S3-WROOM-1
U5: USBLC6-2SC6; SOT-23-6

Connections:
+3V3: C15.1, C16.1, J4.4, R8.1, R9.1, R10.1, R11.1, U4.2 (3V3); also elsewhere on the board
/ACC_INT1: U4.28 (IO35); also elsewhere on the board
/ADC_ALERT: U4.29 (IO36); also elsewhere on the board
/CAN_RX: U4.11 (IO18); also elsewhere on the board
/CAN_TX: U4.10 (IO17); also elsewhere on the board
/DIM1: U4.18 (IO10); also elsewhere on the board
/DIM2: U4.19 (IO11); also elsewhere on the board
/DIM3: U4.20 (IO12); also elsewhere on the board
/DIM4: U4.21 (IO13); also elsewhere on the board
/DIM5: U4.22 (IO14); also elsewhere on the board
/DIM6: U4.23 (IO21); also elsewhere on the board
/EXP_INT: U4.24 (IO47); also elsewhere on the board
/GPS_PPS: U4.35 (IO42); also elsewhere on the board
/GPS_RX: U4.31 (IO38); also elsewhere on the board
/GPS_TX: U4.30 (IO37); also elsewhere on the board
/I2C_SCL: R11.2, U4.17 (IO9); also elsewhere on the board
/I2C_SDA: R10.2, U4.12 (IO8); also elsewhere on the board
/MCU/BOOT: R9.2, SW2.1, U4.27 (IO0)
/MCU/CC1: J3.A5 (CC1), R13.1
/MCU/CC2: J3.B5 (CC2), R14.1
/MCU/EN: C17.1, R8.2, SW1.1, U4.3 (EN)
/MCU/LED_STAT: R12.1, U4.25 (IO48)
/MCU/LED_STAT_A: D5.2 (A), R12.2
/MCU/U0RXD: J4.3, U4.36 (RXD0)
/MCU/U0TXD: J4.2, U4.37 (TXD0)
/MCU/USB_DN: J3.A7 (D-), J3.B7 (D-), U4.13 (USB_D-), U5.3 (I/O2), U5.4 (I/O2)
/MCU/USB_DP: J3.A6 (D+), J3.B6 (D+), U4.14 (USB_D+), U5.1 (I/O1), U5.6 (I/O1)
/RLY1: U4.4 (IO4); also elsewhere on the board
/RLY2: U4.5 (IO5); also elsewhere on the board
/RLY3: U4.6 (IO6); also elsewhere on the board
/RLY4: U4.7 (IO7); also elsewhere on the board
/RLY5: U4.8 (IO15); also elsewhere on the board
/RLY6: U4.9 (IO16); also elsewhere on the board
/RS485_DE: U4.34 (IO41); also elsewhere on the board
/RS485_RX: U4.33 (IO40); also elsewhere on the board
/RS485_TX: U4.32 (IO39); also elsewhere on the board
/VIN_SENSE: U4.39 (IO1); also elsewhere on the board
GND: C15.2, C16.2, C17.2, D5.1 (K), J3.A1 (GND), J3.A12 (GND), J3.B1 (GND), J3.B12 (GND), J3.SH (SHIELD), J4.1, R13.2, R14.2, SW1.2, SW2.2, U4.1 (GND), U4.40 (GND), U4.41 (GND), U5.2 (GND); also elsewhere on the board
VBUS: J3.A4 (VBUS), J3.A9 (VBUS), J3.B4 (VBUS), J3.B9 (VBUS), U5.5 (VBUS); also elsewhere on the board

Notes on the sheet:
MCU: ESP32-S3-WROOM-1. Strapping pins GPIO0 (BOOT button), 3, 45, 46 left at defaults. Place the module at the board edge with the antenna overhanging or over a copper keep-out on all layers.

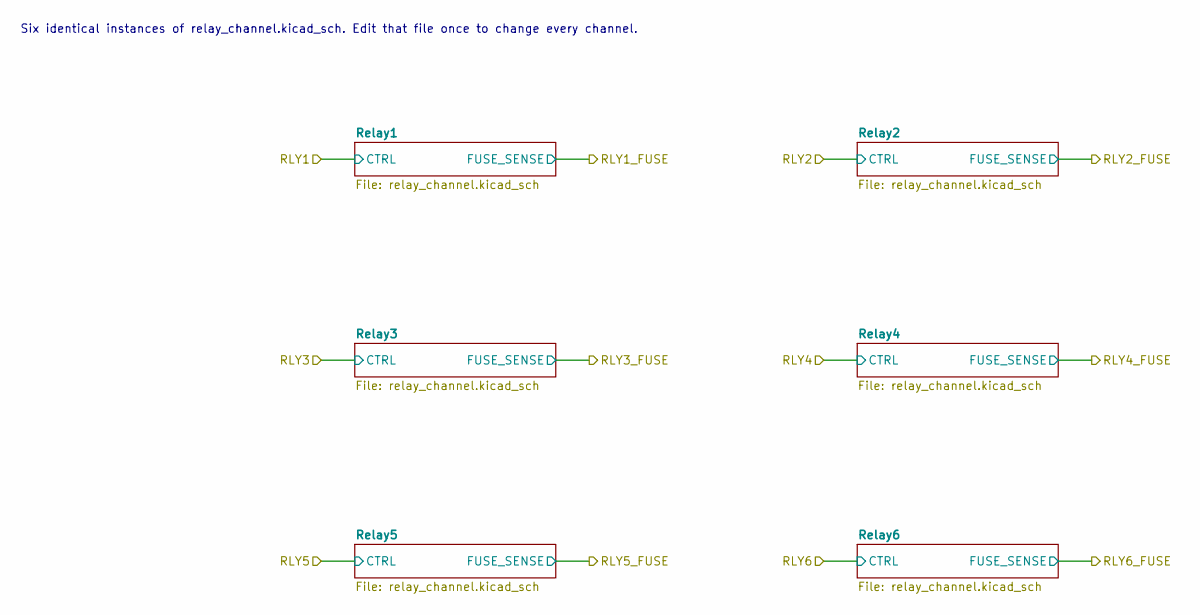
[picture p34: schematic relays.kicad_sch, Relays (6 channels)]

Notes on the sheet:
Six identical instances of relay_channel.kicad_sch. Edit that file once to change every channel.

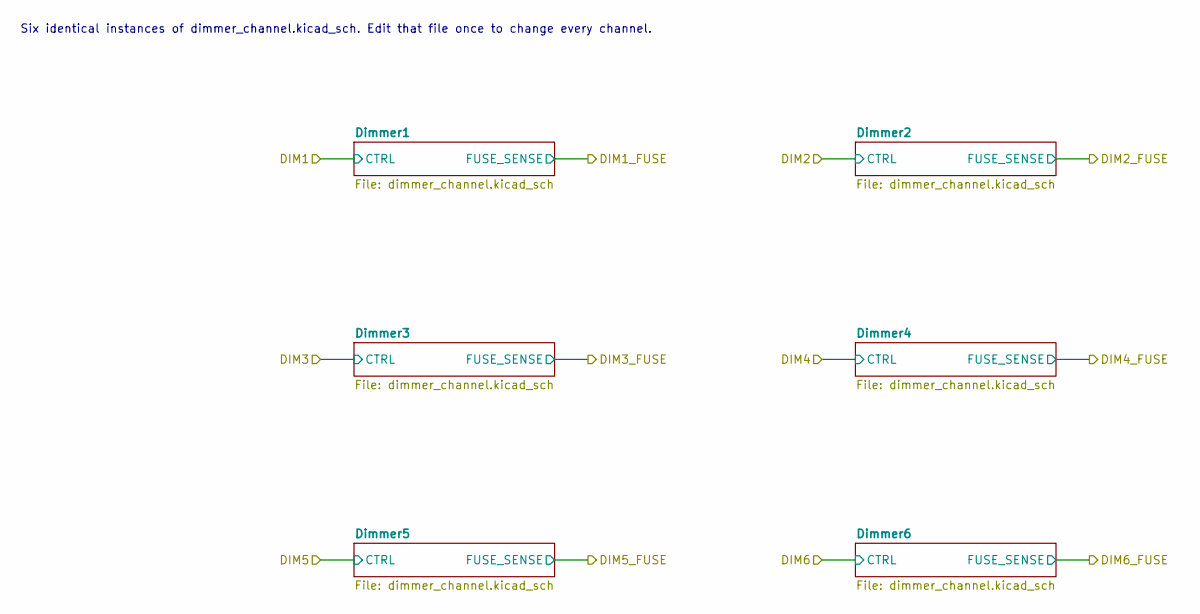
[picture p35: schematic dimmers.kicad_sch, Dimmers (6 channels)]

Notes on the sheet:
Six identical instances of dimmer_channel.kicad_sch. Edit that file once to change every channel.

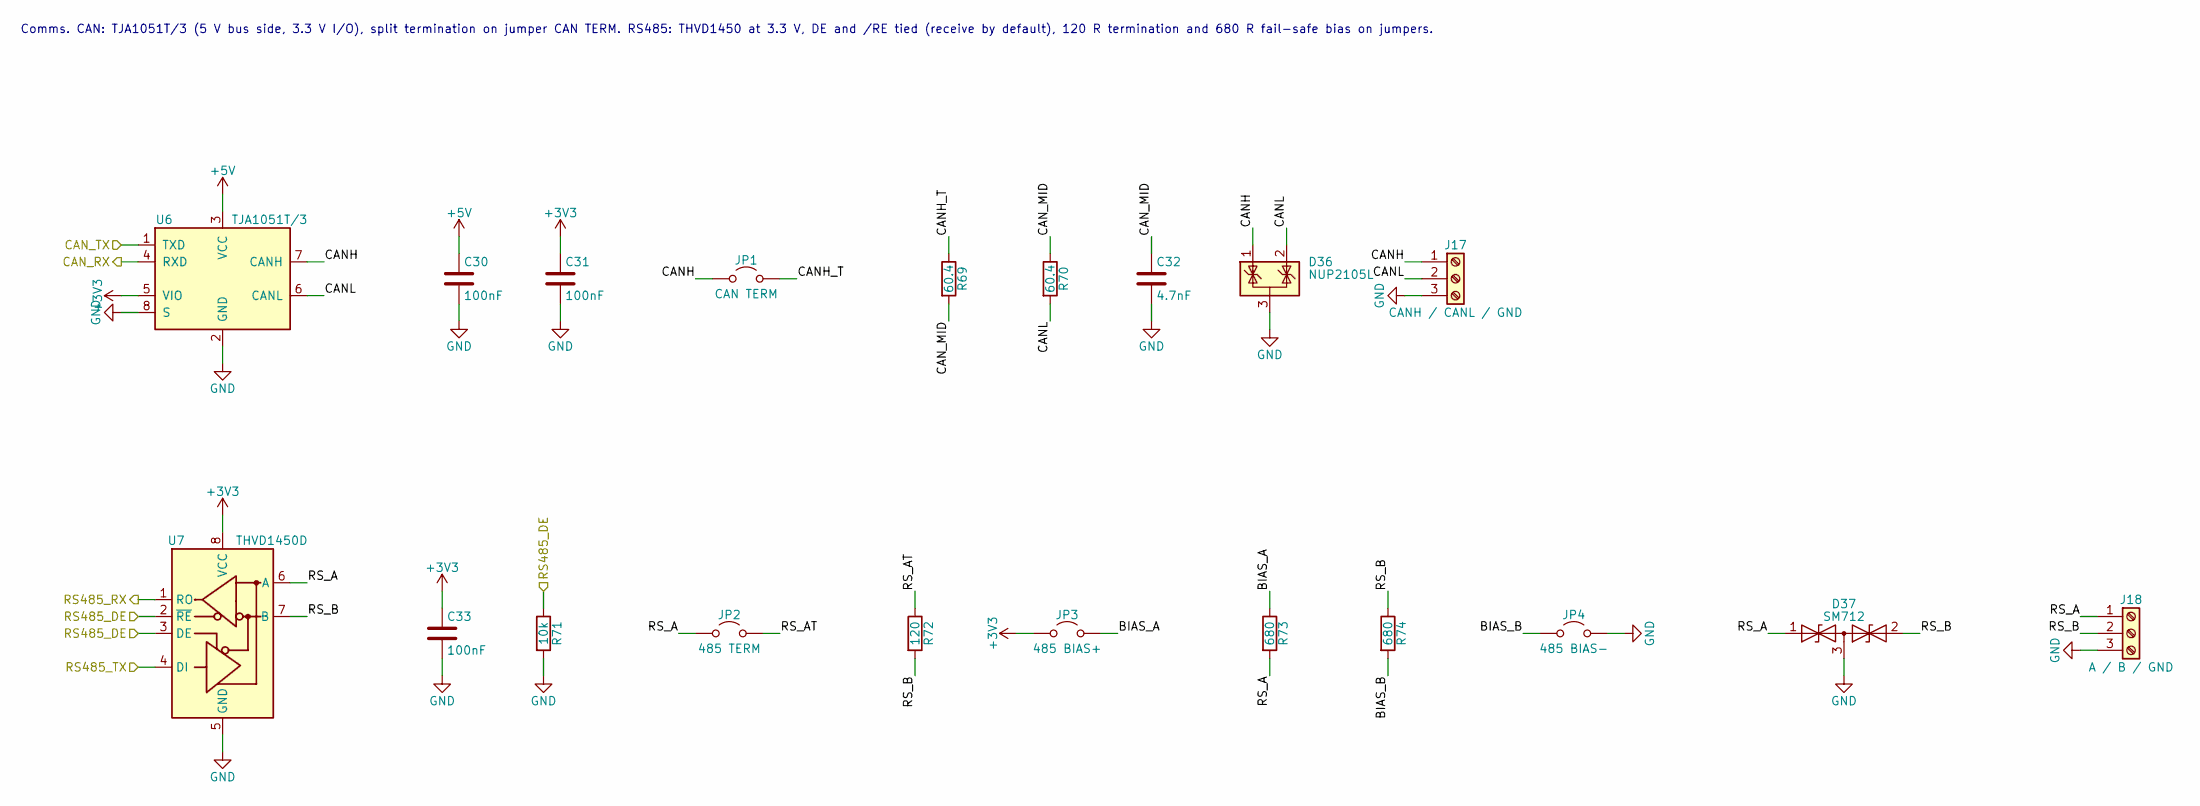
[picture p36: schematic comms.kicad_sch]

Parts:
C30, C31, C33: 100nF; C_0603_1608Metric
C32: 4.7nF; C_0603_1608Metric
D36: NUP2105L; SOT-23
D37: SM712; SOT-23
J17: CANH / CANL / GND; PhoenixContact_MSTBA_2,5_3-G-5,08_1x03_P5.08mm_Horizontal; MPN Phoenix MSTBA 2,5/3-G-5,08 + MSTB 2,5/3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
J18: A / B / GND; PhoenixContact_MSTBA_2,5_3-G-5,08_1x03_P5.08mm_Horizontal; MPN Phoenix MSTBA 2,5/3-G-5,08 + MSTB 2,5/3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
JP1: CAN TERM; PinHeader_1x02_P2.54mm_Vertical
JP2: 485 TERM; PinHeader_1x02_P2.54mm_Vertical
JP3: 485 BIAS+; PinHeader_1x02_P2.54mm_Vertical
JP4: 485 BIAS-; PinHeader_1x02_P2.54mm_Vertical
R69, R70: 60.4; R_0603_1608Metric
R71: 10k; R_0603_1608Metric
R72: 120; R_0603_1608Metric
R73, R74: 680; R_0603_1608Metric
U6: TJA1051T/3; SOIC-8_3.9x4.9mm_P1.27mm
U7: THVD1450D; SOIC-8_3.9x4.9mm_P1.27mm

Connections:
+3V3: C31.1, C33.1, JP3.1 (A), U6.5 (VIO), U7.8 (VCC); also elsewhere on the board
+5V: C30.1, U6.3 (VCC); also elsewhere on the board
/CAN_RX: U6.4 (RXD); also elsewhere on the board
/CAN_TX: U6.1 (TXD); also elsewhere on the board
/Comms/BIAS_A: JP3.2 (B), R73.1
/Comms/BIAS_B: JP4.1 (A), R74.2
/Comms/CANH: D36.1 (K), J17.1, JP1.1 (A), U6.7 (CANH)
/Comms/CANH_T: JP1.2 (B), R69.1
/Comms/CANL: D36.2 (K), J17.2, R70.2, U6.6 (CANL)
/Comms/CAN_MID: C32.1, R69.2, R70.1
/Comms/RS_A: D37.1 (A1), J18.1, JP2.1 (A), R73.2, U7.6 (A)
/Comms/RS_AT: JP2.2 (B), R72.1
/Comms/RS_B: D37.2 (A2), J18.2, R72.2, R74.1, U7.7 (B)
/RS485_DE: R71.1, U7.2 (~RE), U7.3 (DE); also elsewhere on the board
/RS485_RX: U7.1 (RO); also elsewhere on the board
/RS485_TX: U7.4 (DI); also elsewhere on the board
GND: C30.2, C31.2, C32.2, C33.2, D36.3 (A), D37.3 (common), J17.3, J18.3, JP4.2 (B), R71.2, U6.2 (GND), U6.8 (S), U7.5 (GND); also elsewhere on the board

Notes on the sheet:
Comms. CAN: TJA1051T/3 (5 V bus side, 3.3 V I/O), split termination on jumper CAN TERM. RS485: THVD1450 at 3.3 V, DE and /RE tied (receive by default), 120 R termination and 680 R fail-safe bias on jumpers.

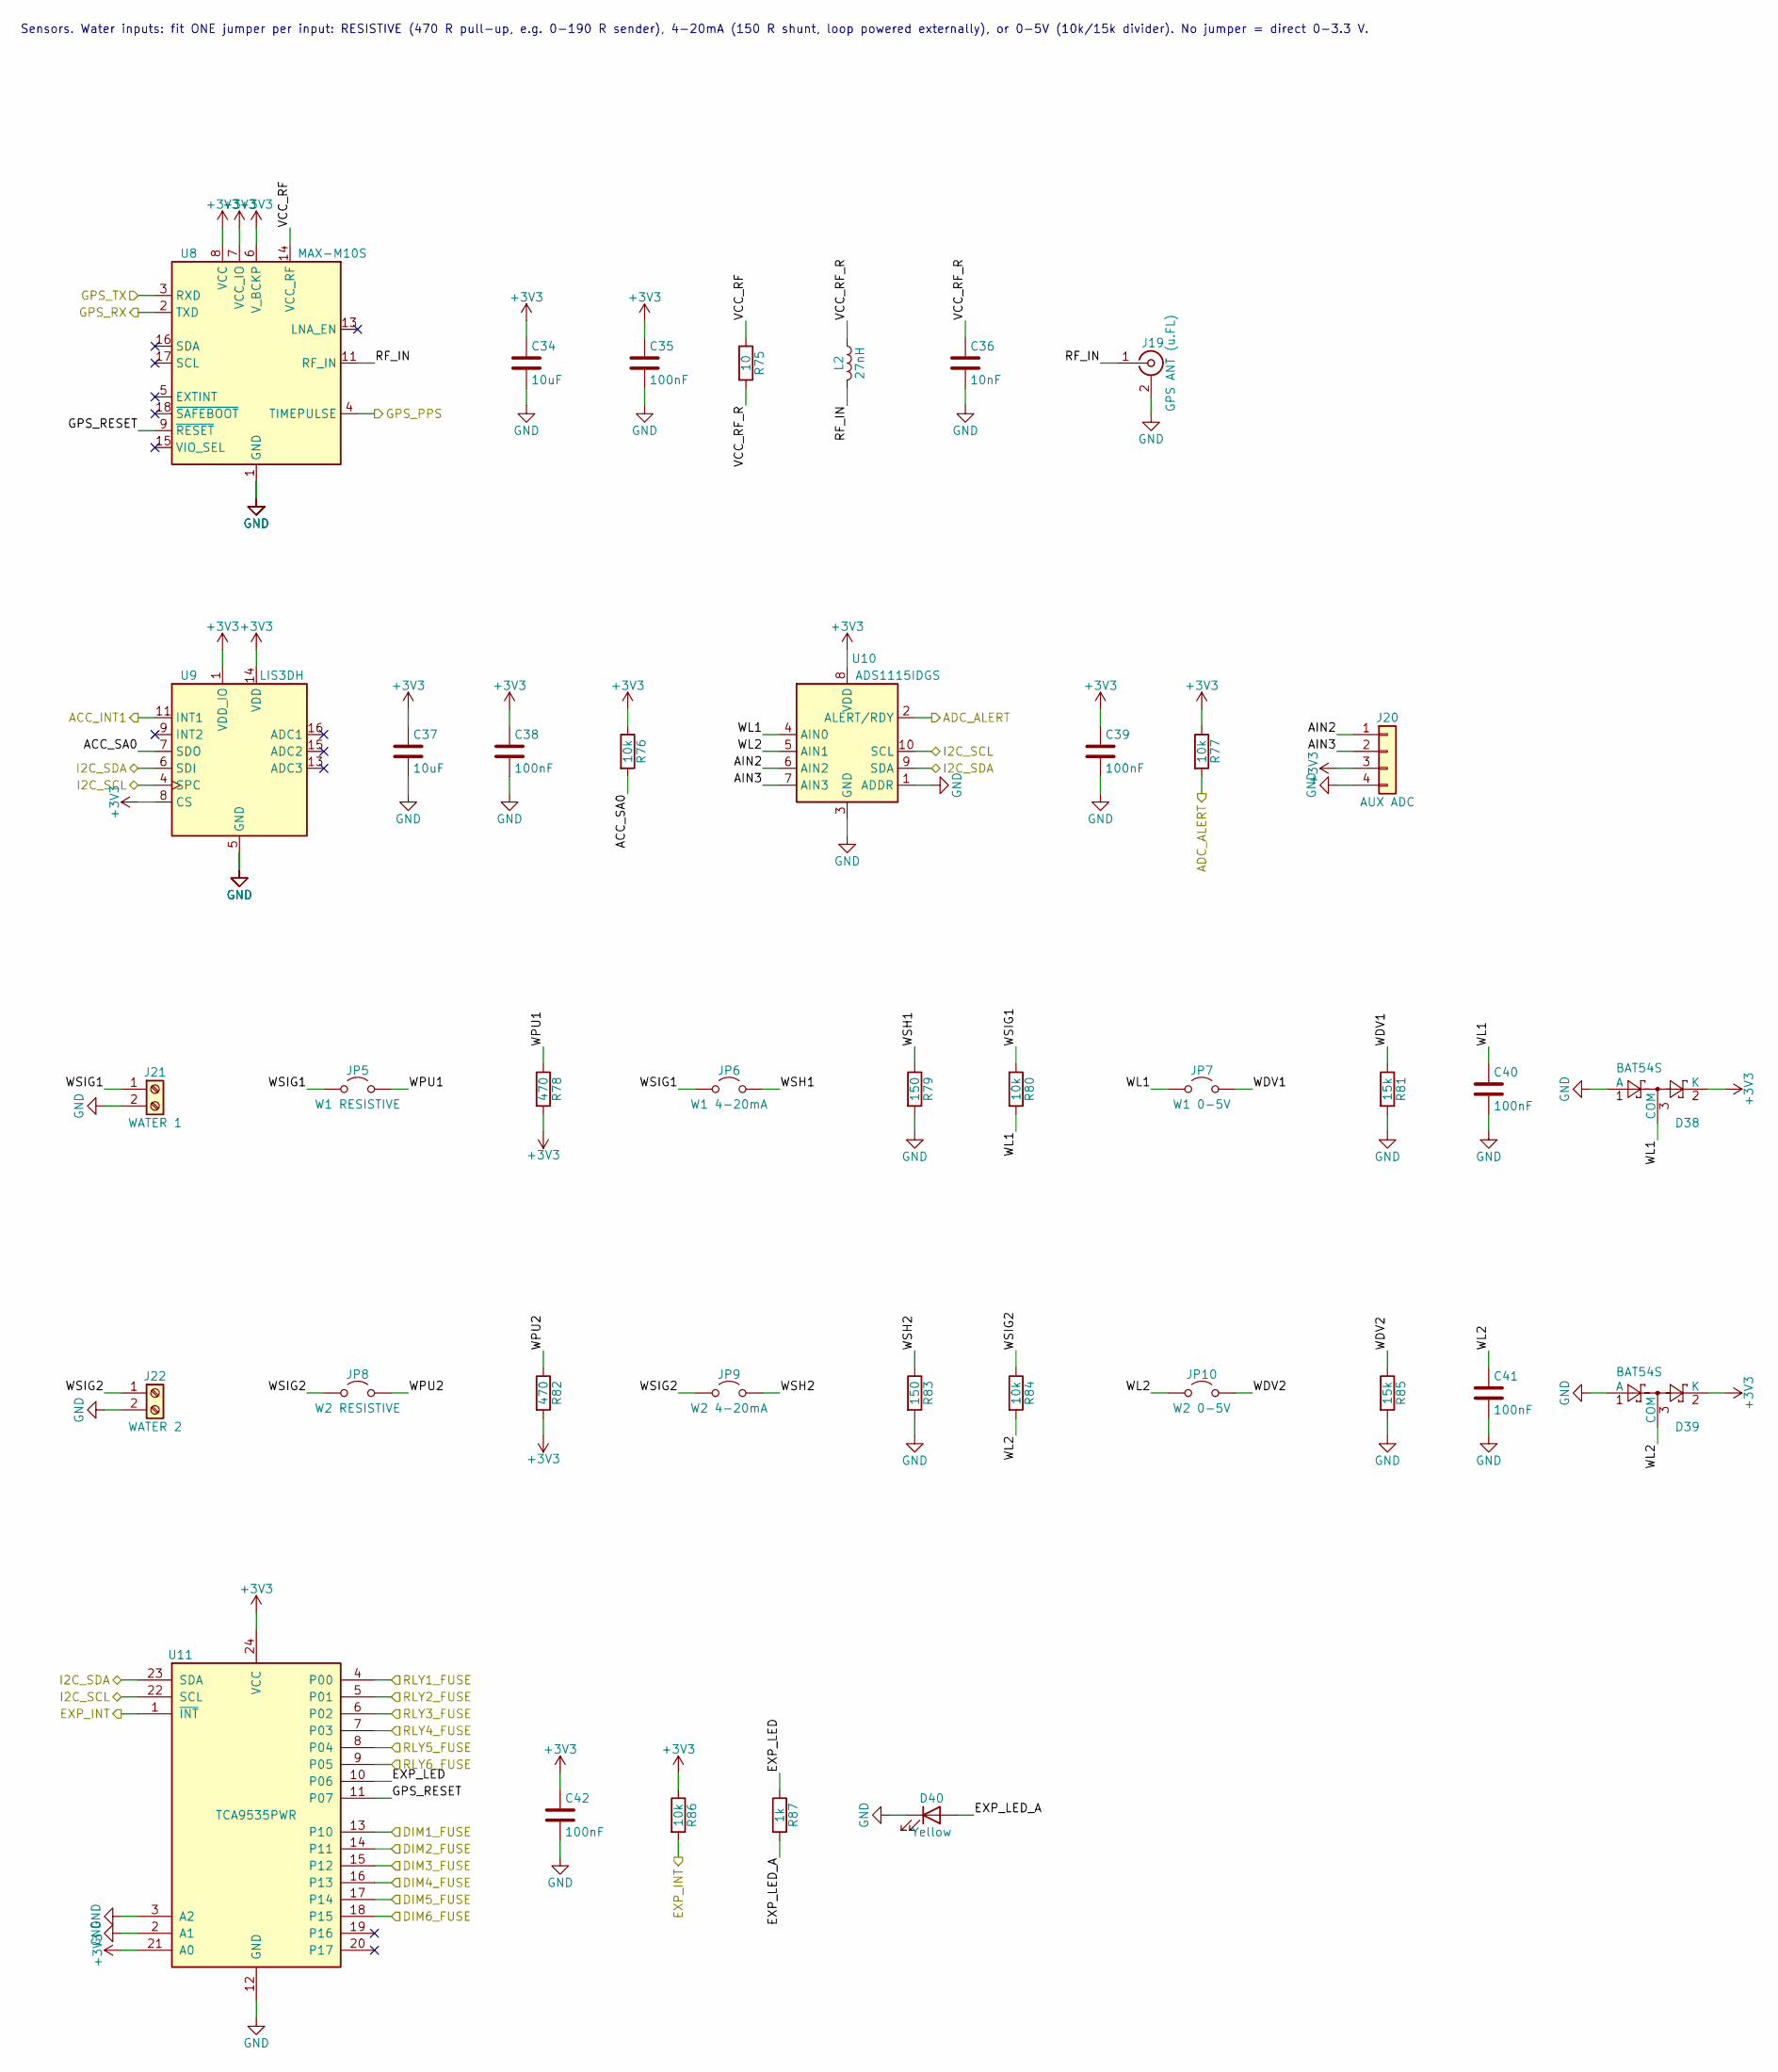
[picture p37: schematic sensors.kicad_sch]

Parts:
C34, C37: 10uF; C_0805_2012Metric
C35, C38, C39, C40, C41, C42: 100nF; C_0603_1608Metric
C36: 10nF; C_0603_1608Metric
D38, D39: BAT54S; SOT-23
D40: Yellow; LED_0603_1608Metric
J19: GPS ANT (u.FL); U.FL_Hirose_U.FL-R-SMT-1_Vertical
J20: AUX ADC; PinHeader_1x04_P2.54mm_Vertical
J21: WATER 1; PhoenixContact_MSTBA_2,5_2-G-5,08_1x02_P5.08mm_Horizontal; MPN Phoenix MSTBA 2,5/2-G-5,08 + MSTB 2,5/2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
J22: WATER 2; PhoenixContact_MSTBA_2,5_2-G-5,08_1x02_P5.08mm_Horizontal; MPN Phoenix MSTBA 2,5/2-G-5,08 + MSTB 2,5/2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
JP5: W1 RESISTIVE; PinHeader_1x02_P2.54mm_Vertical
JP6: W1 4-20mA; PinHeader_1x02_P2.54mm_Vertical
JP7: W1 0-5V; PinHeader_1x02_P2.54mm_Vertical
JP8: W2 RESISTIVE; PinHeader_1x02_P2.54mm_Vertical
JP9: W2 4-20mA; PinHeader_1x02_P2.54mm_Vertical
JP10: W2 0-5V; PinHeader_1x02_P2.54mm_Vertical
L2: 27nH; L_0603_1608Metric
R75: 10; R_0603_1608Metric
R76, R77, R80, R84, R86: 10k; R_0603_1608Metric
R78, R82: 470; R_0603_1608Metric
R79, R83: 150; R_0603_1608Metric
R81, R85: 15k; R_0603_1608Metric
R87: 1k; R_0603_1608Metric
U8: MAX-M10S; ublox_MAX
U9: LIS3DH; LGA-16_3x3mm_P0.5mm_LayoutBorder3x5y
U10: ADS1115IDGS; TSSOP-10_3x3mm_P0.5mm
U11: TCA9535PWR; TSSOP-24_4.4x7.8mm_P0.65mm

Connections:
+3V3: C34.1, C35.1, C37.1, C38.1, C39.1, C42.1, D38.2 (K), D39.2 (K), J20.3, R76.1, R77.1, R78.2, R82.2, R86.1, U8.6 (V_BCKP), U8.7 (VCC_IO), U8.8 (VCC), U9.1 (VDD_IO), U9.8 (CS), U9.14 (VDD), U10.8 (VDD), U11.21 (A0), U11.24 (VCC); also elsewhere on the board
/ACC_INT1: U9.11 (INT1); also elsewhere on the board
/ADC_ALERT: R77.2, U10.2 (ALERT/RDY); also elsewhere on the board
/DIM1_FUSE: U11.13 (P10); also elsewhere on the board
/DIM2_FUSE: U11.14 (P11); also elsewhere on the board
/DIM3_FUSE: U11.15 (P12); also elsewhere on the board
/DIM4_FUSE: U11.16 (P13); also elsewhere on the board
/DIM5_FUSE: U11.17 (P14); also elsewhere on the board
/DIM6_FUSE: U11.18 (P15); also elsewhere on the board
/EXP_INT: R86.2, U11.1 (~INT); also elsewhere on the board
/GPS_PPS: U8.4 (TIMEPULSE); also elsewhere on the board
/GPS_RX: U8.2 (TXD); also elsewhere on the board
/GPS_TX: U8.3 (RXD); also elsewhere on the board
/I2C_SCL: U9.4 (SPC), U10.10 (SCL), U11.22 (SCL); also elsewhere on the board
/I2C_SDA: U9.6 (SDI), U10.9 (SDA), U11.23 (SDA); also elsewhere on the board
/RLY1_FUSE: U11.4 (P00); also elsewhere on the board
/RLY2_FUSE: U11.5 (P01); also elsewhere on the board
/RLY3_FUSE: U11.6 (P02); also elsewhere on the board
/RLY4_FUSE: U11.7 (P03); also elsewhere on the board
/RLY5_FUSE: U11.8 (P04); also elsewhere on the board
/RLY6_FUSE: U11.9 (P05); also elsewhere on the board
/Sensors/ACC_SA0: R76.2, U9.7 (SDO)
/Sensors/AIN2: J20.1, U10.6 (AIN2)
/Sensors/AIN3: J20.2, U10.7 (AIN3)
/Sensors/EXP_LED: R87.1, U11.10 (P06)
/Sensors/EXP_LED_A: D40.2 (A), R87.2
/Sensors/GPS_RESET: U8.9 (~RESET), U11.11 (P07)
/Sensors/RF_IN: J19.1 (In), L2.2, U8.11 (RF_IN)
/Sensors/VCC_RF: R75.1, U8.14 (VCC_RF)
/Sensors/VCC_RF_R: C36.1, L2.1, R75.2
/Sensors/WDV1: JP7.2 (B), R81.1
/Sensors/WDV2: JP10.2 (B), R85.1
/Sensors/WL1: C40.1, D38.3 (COM), JP7.1 (A), R80.2, U10.4 (AIN0)
/Sensors/WL2: C41.1, D39.3 (COM), JP10.1 (A), R84.2, U10.5 (AIN1)
/Sensors/WPU1: JP5.2 (B), R78.1
/Sensors/WPU2: JP8.2 (B), R82.1
/Sensors/WSH1: JP6.2 (B), R79.1
/Sensors/WSH2: JP9.2 (B), R83.1
/Sensors/WSIG1: J21.1, JP5.1 (A), JP6.1 (A), R80.1
/Sensors/WSIG2: J22.1, JP8.1 (A), JP9.1 (A), R84.1
GND: C34.2, C35.2, C36.2, C37.2, C38.2, C39.2, C40.2, C41.2, C42.2, D38.1 (A), D39.1 (A), D40.1 (K), J19.2 (Ext), J20.4, J21.2, J22.2, R79.2, R81.2, R83.2, R85.2, U8.1 (GND), U8.10 (GND), U8.12 (GND), U9.5 (GND), U9.10 (GND), U9.12 (GND), U10.1 (ADDR), U10.3 (GND), U11.2 (A1), U11.3 (A2), U11.12 (GND); also elsewhere on the board

Notes on the sheet:
Sensors. Water inputs: fit ONE jumper per input: RESISTIVE (470 R pull-up, e.g. 0-190 R sender), 4-20mA (150 R shunt, loop powered externally), or 0-5V (10k/15k divider). No jumper = direct 0-3.3 V.
