Camperlux/vancontroller/VanController.kicad_pcb

## KiCad design VanController.kicad_pcb (continued)

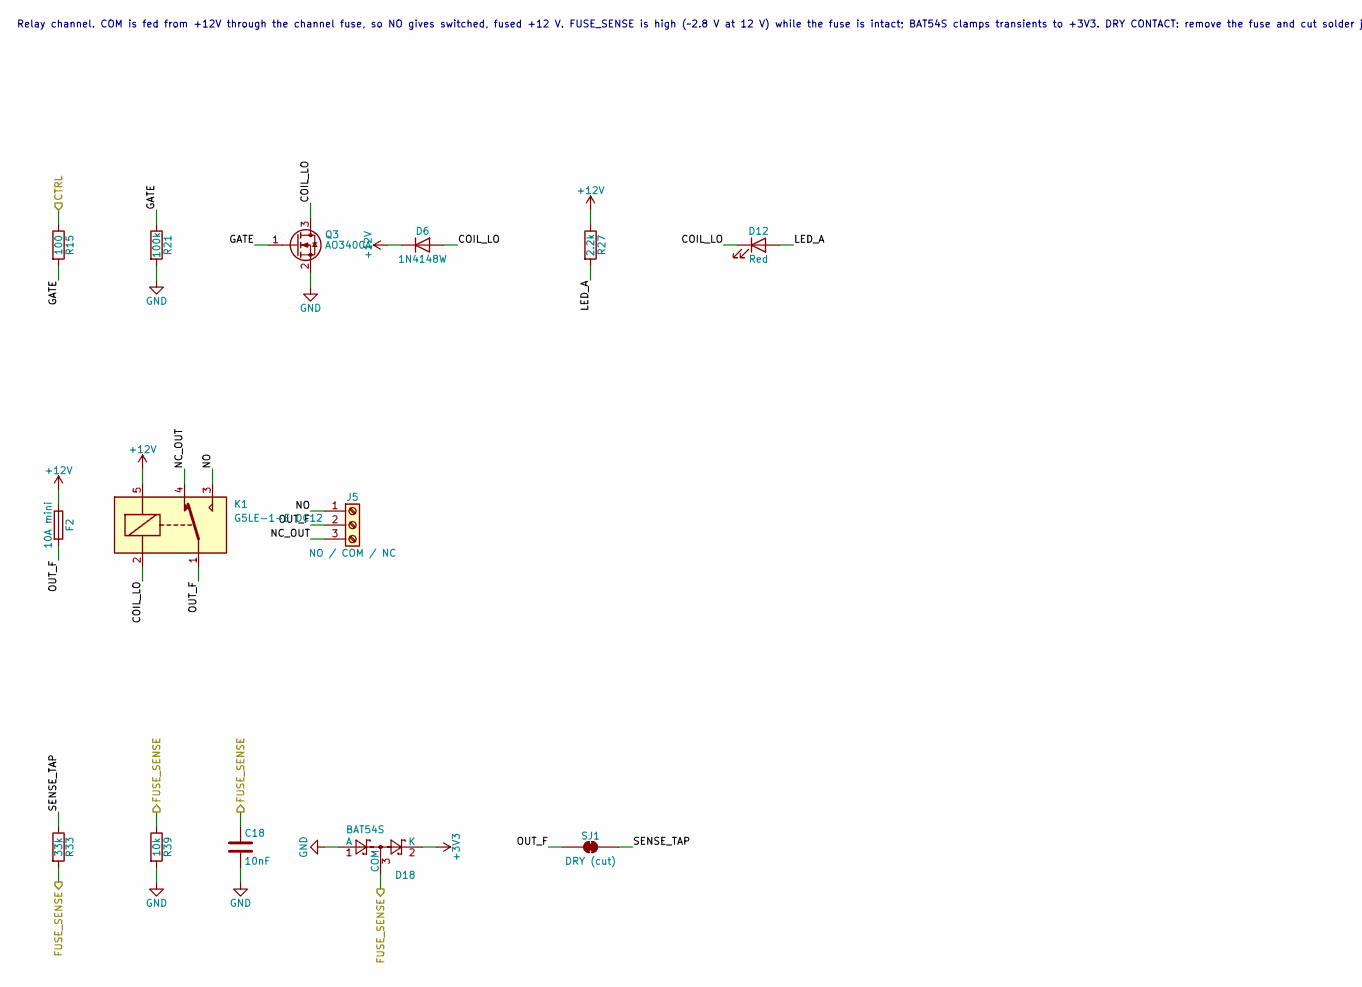
[picture p38: schematic relay_channel.kicad_sch, Relay channel, part in row 1, column 1]

Parts:
C18: 10nF; C_0603_1608Metric
D6: 1N4148W; D_SOD-123
D12: Red; LED_0603_1608Metric
D18: BAT54S; SOT-23
F2: 10A mini; Fuseholder_Blade_Mini_Keystone_3568; MPN Keystone 3568 + mini blade fuse (size t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
J5: NO / COM / NC; PhoenixContact_MSTBA_2,5_3-G-5,08_1x03_P5.08mm_Horizontal; MPN Phoenix MSTBA 2,5/3-G-5,08 + MSTB 2,5/3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
K1: G5LE-1-E DC12; Relay_SPDT_Omron-G5LE-1
Q3: AO3400A; SOT-23
R15: 100; R_0603_1608Metric
R21: 100k; R_0603_1608Metric
R27: 2.2k; R_0603_1608Metric
R33: 33k; R_0603_1608Metric
R39: 10k; R_0603_1608Metric
SJ1: DRY (cut); SolderJumper-2_P1.3mm_Bridged_RoundedPad1.0x1.5mm

Connections:
+3V3: D18.2 (K); also elsewhere on the board
+12V: D6.1 (K), F2.1, K1.5, R27.1; also elsewhere on the board
/RLY1: R15.1; also elsewhere on the board
/RLY1_FUSE: C18.1, D18.3 (COM), R33.2, R39.1; also elsewhere on the board
/Relays/Relay1/COIL_LO: D6.2 (A), D12.1 (K), K1.2, Q3.3 (D)
/Relays/Relay1/GATE: Q3.1 (G), R15.2, R21.1
/Relays/Relay1/LED_A: D12.2 (A), R27.2
/Relays/Relay1/NC_OUT: J5.3, K1.4
/Relays/Relay1/NO: J5.1, K1.3
/Relays/Relay1/OUT_F: F2.2, J5.2, K1.1, SJ1.1 (A)
/Relays/Relay1/SENSE_TAP: R33.1, SJ1.2 (B)
GND: C18.2, D18.1 (A), Q3.2 (S), R21.2, R39.2; also elsewhere on the board

Parts of its further copies:
C19, C20, C21, C22, C23: 10nF; C_0603_1608Metric
D7, D8, D9, D10, D11: 1N4148W; D_SOD-123
D13, D14, D15, D16, D17: Red; LED_0603_1608Metric
D19, D20, D21, D22, D23: BAT54S; SOT-23
F3, F4, F5, F6, F7: 10A mini; Fuseholder_Blade_Mini_Keystone_3568; MPN Keystone 3568 + mini blade fuse (size t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
J6, J7, J8, J9, J10: NO / COM / NC; PhoenixContact_MSTBA_2,5_3-G-5,08_1x03_P5.08mm_Horizontal; MPN Phoenix MSTBA 2,5/3-G-5,08 + MSTB 2,5/3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
K2, K3, K4, K5, K6: G5LE-1-E DC12; Relay_SPDT_Omron-G5LE-1
Q4, Q5, Q6, Q7, Q8: AO3400A; SOT-23
R16, R17, R18, R19, R20: 100; R_0603_1608Metric
R22, R23, R24, R25, R26: 100k; R_0603_1608Metric
R28, R29, R30, R31, R32: 2.2k; R_0603_1608Metric
R34, R35, R36, R37, R38: 33k; R_0603_1608Metric
R40, R41, R42, R43, R44: 10k; R_0603_1608Metric
SJ2, SJ3, SJ4, SJ5, SJ6: DRY (cut); SolderJumper-2_P1.3mm_Bridged_RoundedPad1.0x1.5mm

Connections of its further copies:
+3V3: D19.2 (K), D20.2 (K), D21.2 (K), D22.2 (K), D23.2 (K); also elsewhere on the board
+12V: D7.1 (K), D8.1 (K), D9.1 (K), D10.1 (K), D11.1 (K), F3.1, F4.1, F5.1, F6.1, F7.1, K2.5, K3.5, K4.5, K5.5, K6.5, R28.1, R29.1, R30.1, R31.1, R32.1; also elsewhere on the board
/RLY2: R16.1; also elsewhere on the board
/RLY2_FUSE: C19.1, D19.3 (COM), R34.2, R40.1; also elsewhere on the board
/RLY3: R17.1; also elsewhere on the board
/RLY3_FUSE: C20.1, D20.3 (COM), R35.2, R41.1; also elsewhere on the board
/RLY4: R18.1; also elsewhere on the board
/RLY4_FUSE: C21.1, D21.3 (COM), R36.2, R42.1; also elsewhere on the board
/RLY5: R19.1; also elsewhere on the board
/RLY5_FUSE: C22.1, D22.3 (COM), R37.2, R43.1; also elsewhere on the board
/RLY6: R20.1; also elsewhere on the board
/RLY6_FUSE: C23.1, D23.3 (COM), R38.2, R44.1; also elsewhere on the board
/Relays/Relay2/COIL_LO: D7.2 (A), D13.1 (K), K2.2, Q4.3 (D)
/Relays/Relay2/GATE: Q4.1 (G), R16.2, R22.1
/Relays/Relay2/LED_A: D13.2 (A), R28.2
/Relays/Relay2/NC_OUT: J6.3, K2.4
/Relays/Relay2/NO: J6.1, K2.3
/Relays/Relay2/OUT_F: F3.2, J6.2, K2.1, SJ2.1 (A)
/Relays/Relay2/SENSE_TAP: R34.1, SJ2.2 (B)
/Relays/Relay3/COIL_LO: D8.2 (A), D14.1 (K), K3.2, Q5.3 (D)
/Relays/Relay3/GATE: Q5.1 (G), R17.2, R23.1
/Relays/Relay3/LED_A: D14.2 (A), R29.2
/Relays/Relay3/NC_OUT: J7.3, K3.4
/Relays/Relay3/NO: J7.1, K3.3
/Relays/Relay3/OUT_F: F4.2, J7.2, K3.1, SJ3.1 (A)
/Relays/Relay3/SENSE_TAP: R35.1, SJ3.2 (B)
/Relays/Relay4/COIL_LO: D9.2 (A), D15.1 (K), K4.2, Q6.3 (D)
/Relays/Relay4/GATE: Q6.1 (G), R18.2, R24.1
/Relays/Relay4/LED_A: D15.2 (A), R30.2
/Relays/Relay4/NC_OUT: J8.3, K4.4
/Relays/Relay4/NO: J8.1, K4.3
/Relays/Relay4/OUT_F: F5.2, J8.2, K4.1, SJ4.1 (A)
/Relays/Relay4/SENSE_TAP: R36.1, SJ4.2 (B)
/Relays/Relay5/COIL_LO: D10.2 (A), D16.1 (K), K5.2, Q7.3 (D)
/Relays/Relay5/GATE: Q7.1 (G), R19.2, R25.1
/Relays/Relay5/LED_A: D16.2 (A), R31.2
/Relays/Relay5/NC_OUT: J9.3, K5.4
/Relays/Relay5/NO: J9.1, K5.3
/Relays/Relay5/OUT_F: F6.2, J9.2, K5.1, SJ5.1 (A)
/Relays/Relay5/SENSE_TAP: R37.1, SJ5.2 (B)
/Relays/Relay6/COIL_LO: D11.2 (A), D17.1 (K), K6.2, Q8.3 (D)
/Relays/Relay6/GATE: Q8.1 (G), R20.2, R26.1
/Relays/Relay6/LED_A: D17.2 (A), R32.2
/Relays/Relay6/NC_OUT: J10.3, K6.4
/Relays/Relay6/NO: J10.1, K6.3
/Relays/Relay6/OUT_F: F7.2, J10.2, K6.1, SJ6.1 (A)
/Relays/Relay6/SENSE_TAP: R38.1, SJ6.2 (B)
GND: C19.2, C20.2, C21.2, C22.2, C23.2, D19.1 (A), D20.1 (A), D21.1 (A), D22.1 (A), D23.1 (A), Q4.2 (S), Q5.2 (S), Q6.2 (S), Q7.2 (S), Q8.2 (S), R22.2, R23.2, R24.2, R25.2, R26.2, R40.2, R41.2, R42.2, R43.2, R44.2; also elsewhere on the board

Notes on the sheet:
Relay channel. COM is fed from +12V through the channel fuse, so NO gives switched, fused +12 V. FUSE_SENSE is high (~2.8 V at 12 V) while the fuse is intact; BAT54S clamps transients to +3V3. DRY CONTACT: remove the fuse and cut solder jumper SJ (DRY). COM/NO/NC then connect only to the relay cont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

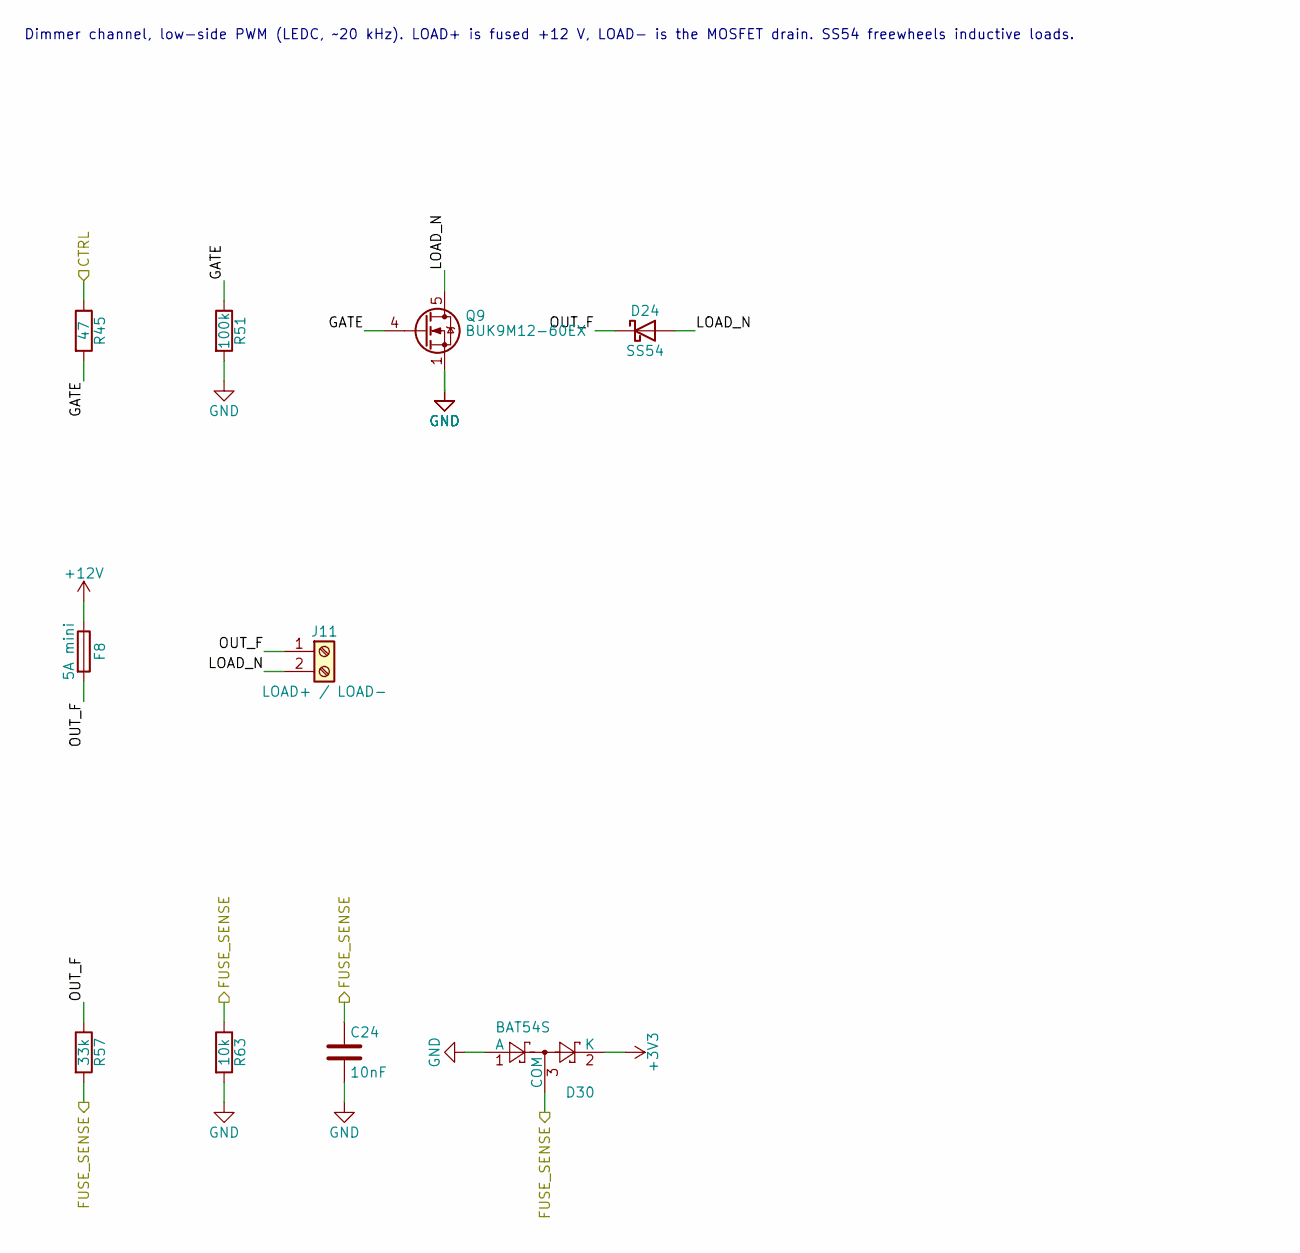
[picture p39: schematic dimmer_channel.kicad_sch, Dimmer channel]

Parts:
C24: 10nF; C_0603_1608Metric
D24: SS54; D_SMC
D30: BAT54S; SOT-23
F8: 5A mini; Fuseholder_Blade_Mini_Keystone_3568; MPN Keystone 3568 + mini blade fuse (size t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
J11: LOAD+ / LOAD-; PhoenixContact_MSTBA_2,5_2-G-5,08_1x02_P5.08mm_Horizontal; MPN Phoenix MSTBA 2,5/2-G-5,08 + MSTB 2,5/2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
Q9: BUK9M12-60EX; LFPAK33
R45: 47; R_0603_1608Metric
R51: 100k; R_0603_1608Metric
R57: 33k; R_0603_1608Metric
R63: 10k; R_0603_1608Metric

Connections:
+3V3: D30.2 (K); also elsewhere on the board
+12V: F8.1; also elsewhere on the board
/DIM1: R45.1; also elsewhere on the board
/DIM1_FUSE: C24.1, D30.3 (COM), R57.2, R63.1; also elsewhere on the board
/Dimmers/Dimmer1/GATE: Q9.4 (G), R45.2, R51.1
/Dimmers/Dimmer1/LOAD_N: D24.2 (A), J11.2, Q9.5 (D)
/Dimmers/Dimmer1/OUT_F: D24.1 (K), F8.2, J11.1, R57.1
GND: C24.2, D30.1 (A), Q9.1 (S), Q9.2 (S), Q9.3 (S), R51.2, R63.2; also elsewhere on the board

Parts of its further copies:
C25, C26, C27, C28, C29: 10nF; C_0603_1608Metric
D25, D26, D27, D28, D29: SS54; D_SMC
D31, D32, D33, D34, D35: BAT54S; SOT-23
F9, F10, F11, F12, F13: 5A mini; Fuseholder_Blade_Mini_Keystone_3568; MPN Keystone 3568 + mini blade fuse (size t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
J12, J13, J14, J15, J16: LOAD+ / LOAD-; PhoenixContact_MSTBA_2,5_2-G-5,08_1x02_P5.08mm_Horizontal; MPN Phoenix MSTBA 2,5/2-G-5,08 + MSTB 2,5/2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
Q10, Q11, Q12, Q13, Q14: BUK9M12-60EX; LFPAK33
R46, R47, R48, R49, R50: 47; R_0603_1608Metric
R52, R53, R54, R55, R56: 100k; R_0603_1608Metric
R58, R59, R60, R61, R62: 33k; R_0603_1608Metric
R64, R65, R66, R67, R68: 10k; R_0603_1608Metric

Connections of its further copies:
+3V3: D31.2 (K), D32.2 (K), D33.2 (K), D34.2 (K), D35.2 (K); also elsewhere on the board
+12V: F9.1, F10.1, F11.1, F12.1, F13.1; also elsewhere on the board
/DIM2: R46.1; also elsewhere on the board
/DIM2_FUSE: C25.1, D31.3 (COM), R58.2, R64.1; also elsewhere on the board
/DIM3: R47.1; also elsewhere on the board
/DIM3_FUSE: C26.1, D32.3 (COM), R59.2, R65.1; also elsewhere on the board
/DIM4: R48.1; also elsewhere on the board
/DIM4_FUSE: C27.1, D33.3 (COM), R60.2, R66.1; also elsewhere on the board
/DIM5: R49.1; also elsewhere on the board
/DIM5_FUSE: C28.1, D34.3 (COM), R61.2, R67.1; also elsewhere on the board
/DIM6: R50.1; also elsewhere on the board
/DIM6_FUSE: C29.1, D35.3 (COM), R62.2, R68.1; also elsewhere on the board
/Dimmers/Dimmer2/GATE: Q10.4 (G), R46.2, R52.1
/Dimmers/Dimmer2/LOAD_N: D25.2 (A), J12.2, Q10.5 (D)
/Dimmers/Dimmer2/OUT_F: D25.1 (K), F9.2, J12.1, R58.1
/Dimmers/Dimmer3/GATE: Q11.4 (G), R47.2, R53.1
/Dimmers/Dimmer3/LOAD_N: D26.2 (A), J13.2, Q11.5 (D)
/Dimmers/Dimmer3/OUT_F: D26.1 (K), F10.2, J13.1, R59.1
/Dimmers/Dimmer4/GATE: Q12.4 (G), R48.2, R54.1
/Dimmers/Dimmer4/LOAD_N: D27.2 (A), J14.2, Q12.5 (D)
/Dimmers/Dimmer4/OUT_F: D27.1 (K), F11.2, J14.1, R60.1
/Dimmers/Dimmer5/GATE: Q13.4 (G), R49.2, R55.1
/Dimmers/Dimmer5/LOAD_N: D28.2 (A), J15.2, Q13.5 (D)
/Dimmers/Dimmer5/OUT_F: D28.1 (K), F12.2, J15.1, R61.1
/Dimmers/Dimmer6/GATE: Q14.4 (G), R50.2, R56.1
/Dimmers/Dimmer6/LOAD_N: D29.2 (A), J16.2, Q14.5 (D)
/Dimmers/Dimmer6/OUT_F: D29.1 (K), F13.2, J16.1, R62.1
GND: C25.2, C26.2, C27.2, C28.2, C29.2, D31.1 (A), D32.1 (A), D33.1 (A), D34.1 (A), D35.1 (A), Q10.1 (S), Q10.2 (S), Q10.3 (S), Q11.1 (S), Q11.2 (S), Q11.3 (S), Q12.1 (S), Q12.2 (S), Q12.3 (S), Q13.1 (S), Q13.2 (S), Q13.3 (S), Q14.1 (S), Q14.2 (S), Q14.3 (S), R52.2, R53.2, R54.2, R55.2, R56.2, R64.2, R65.2, R66.2, R67.2, R68.2; also elsewhere on the board

Notes on the sheet:
Dimmer channel, low-side PWM (LEDC, ~20 kHz). LOAD+ is fused +12 V, LOAD- is the MOSFET drain. SS54 freewheels inductive loads.

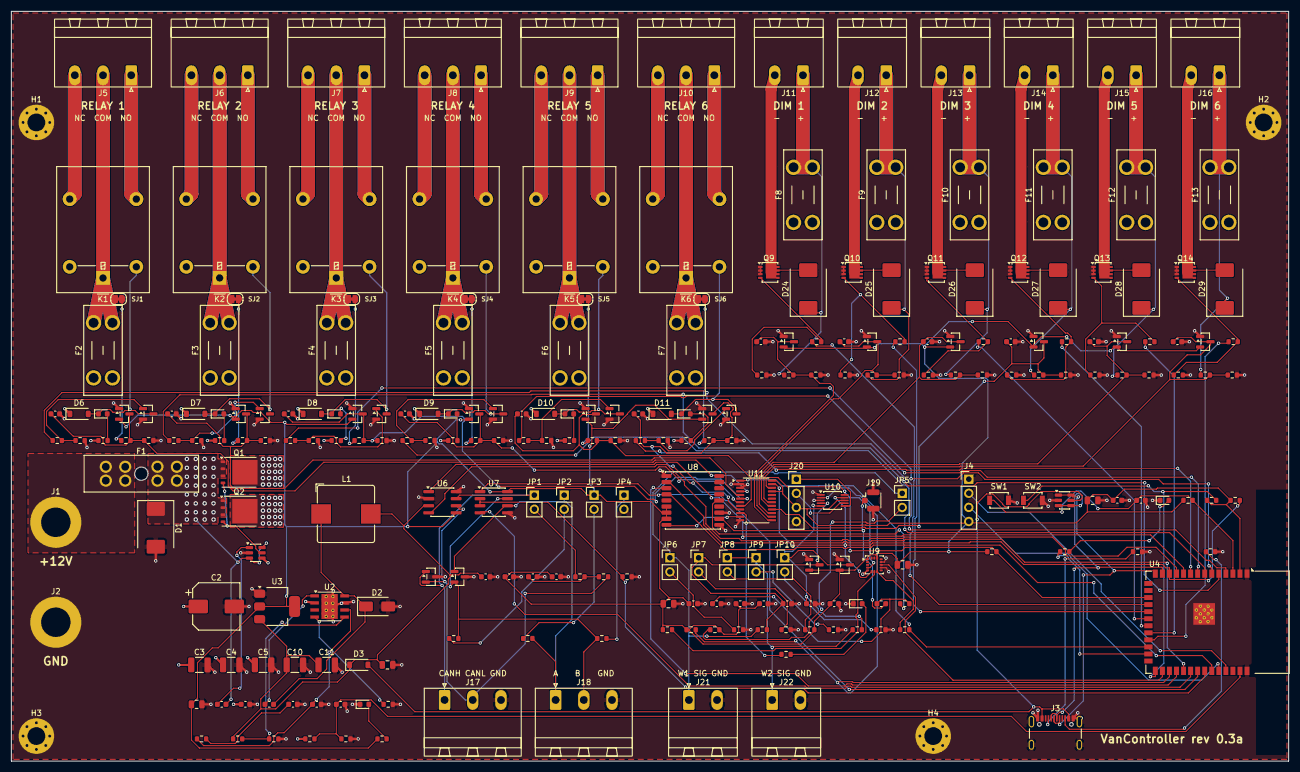
[picture p40: board VanController.kicad_pcb from above]

Board: 4 copper layers, 230.0 x 135.0 mm, 259 parts (0 on the bottom side), 152 nets.
