Camperlux/vancontroller/(commit log)

2026-10-07 VanController rev 0.3: ESP32-S3 12 V van controller board
    KiCad 10 project (schematic + routed 4-layer 230x135 mm board), fab
    outputs, PCBWay order package, Fusion 360 enclosure script and print
    files, generator scripts and documentation (design spec, GPIO map,
    firmware notes, order log).
    [02_BOM_VanController_rev0.3.xlsx, 03_PickPlace_VanController_rev0.3.csv, 07_3D_Model_rev0.3.step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]
2026-10-14 Rev 0.3a: dry-contact option for the relay outputs
    Each relay channel gets a bridged solder jumper (SJ1-SJ6) between the
    fused COM copper and the fuse-sense resistor. Removing the channel fuse
    and cutting the jumper leaves COM/NO/NC connected only to the relay
    contacts. Copper-only change: Gerbers regenerated, BOM and centroid
    unchanged. make_fab.py now writes UTC timestamps and zips the Gerbers.
    Docs: dry-contact procedure, firmware note, PCBWay loose-parts note.
    [02_BOM_VanController_rev0.3.xlsx, 07_3D_Model_rev0.3.step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]
